gzgreg/enph253-2015-team13/SolidWorks parts/linkage_collapsed.png

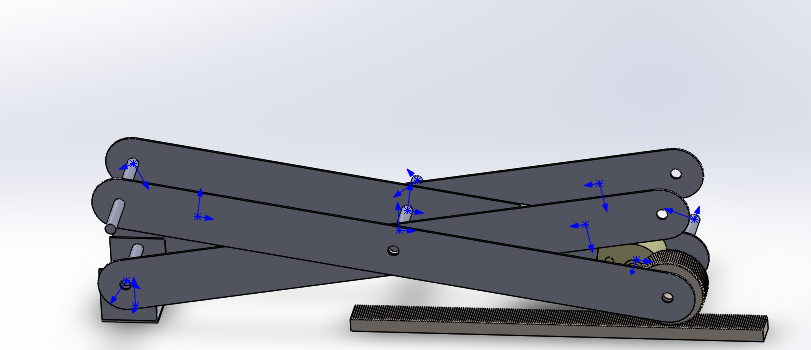
SolidWorks parts/linkage_collapsed.png
