gzgreg/enph253-2015-team13/SolidWorks parts/ARM Design/Design 2/Bottom Joint.png

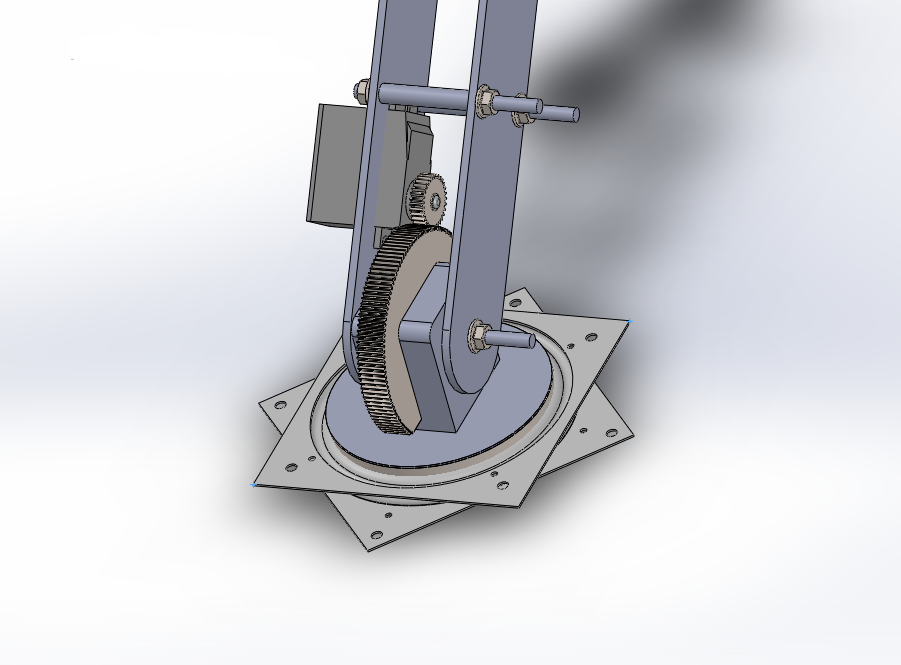
SolidWorks parts/ARM Design/Design 2/Bottom Joint.png
