gzgreg/enph253-2015-team13/README.md

# enph253-2015-team13
Github repo for our ENPH253 (and ENPH257) project.
