gzgreg/enph253-2015-team13/Lab/Lab Report Tracking Sheet.xlsx

TO DO | Used to Calculate | Data |  | Simulation
 |  | Heating | Steady State | Heating | Steady State | Legend
Black Rod | -Emissivity in different surface states |  |  |  |  |  | Complete
Bare Rod | -Thermal conductivity -Specific heat capacity |  |  |  |  |  | To Be Done
Moist Rod | -Heat loss from a wet surface |  |  |  |  |  | Not Nessisary
Insulated Rod | -Convective heat transfer coefficient in different conditions
Veritcal Bare Rod | -Convective heat transfer coefficient in different geometries
Vertical Bare Rod In Ice | -Convective heat transfer coefficient in different geometries/conditions
Power Source Heat | -Fraction of power generated by the thermal resistor
