gzgreg/enph253-2015-team13/Lab/Black Rod/html/transFinDiffPlotter_01.png

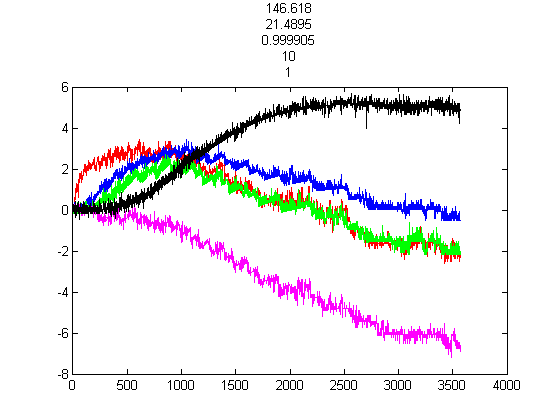
Lab/Black Rod/html/transFinDiffPlotter_01.png
