gzgreg/enph253-2015-team13/Lab/Diagrams for Report/BlackRod.png

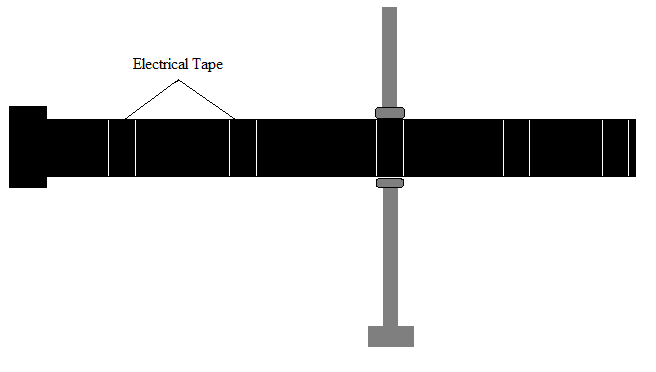
Lab/Diagrams for Report/BlackRod.png
