gzgreg/enph253-2015-team13/Lab/Diagrams for Report/MoistRod.png

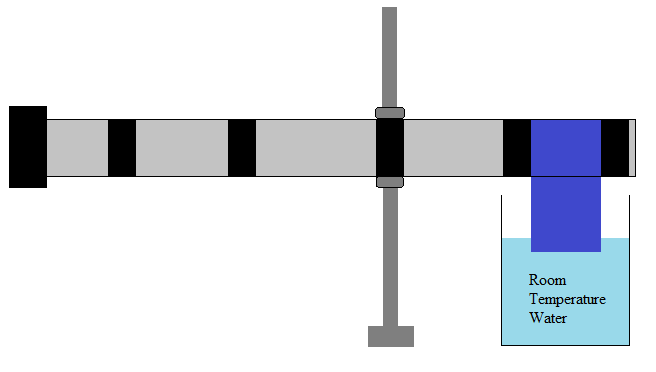
Lab/Diagrams for Report/MoistRod.png
