gzgreg/enph253-2015-team13/Lab/Diagrams for Report/VerticalBareRodIce.png

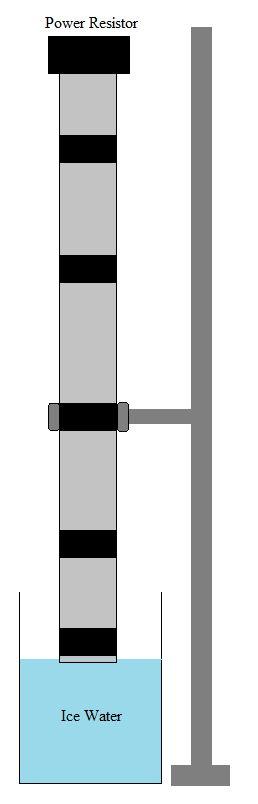
Lab/Diagrams for Report/VerticalBareRodIce.png
