gzgreg/enph253-2015-team13/Lab/James' Lab Simulations/Insulated Rod/html/insulate_rod_sim_01.png

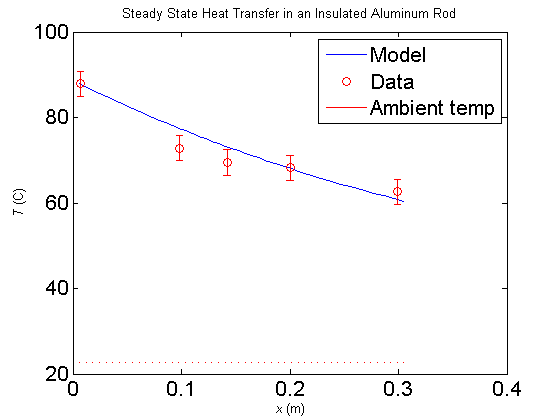
Lab/James' Lab Simulations/Insulated Rod/html/insulate_rod_sim_01.png
