gzgreg/enph253-2015-team13/Lab/Riley's Lab Stimulations V2/html/moistRodSimulation_01.png

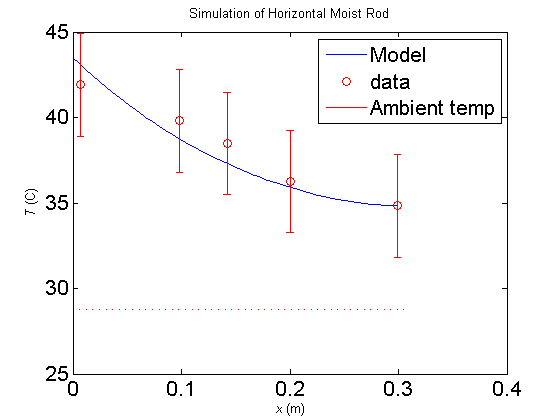
Lab/Riley's Lab Stimulations V2/html/moistRodSimulation_01.png
