gzgreg/enph253-2015-team13/Lab/Transient Insulated Rod Heating/html/transFinDiffPlotter_02.png

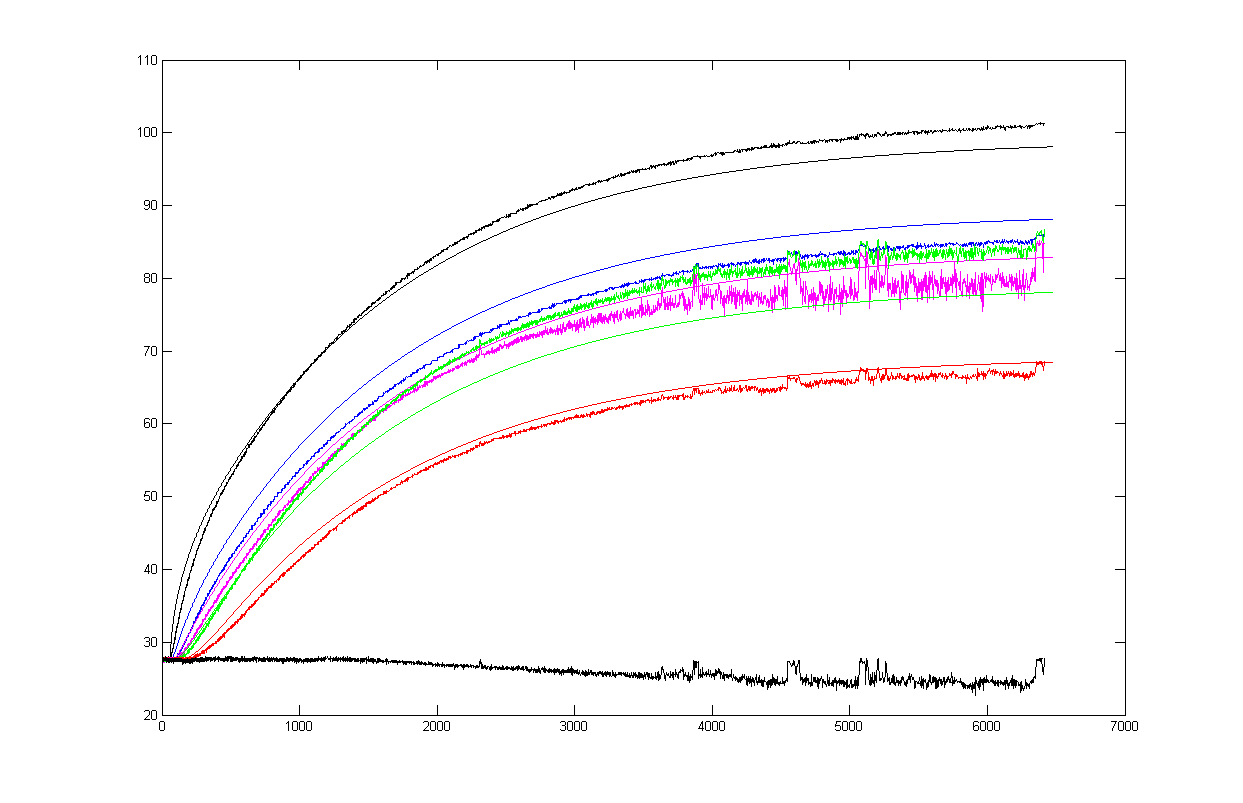
Lab/Transient Insulated Rod Heating/html/transFinDiffPlotter_02.png
