gzgreg/enph253-2015-team13/Lab/Vertical Bare Rod/htmlBottomPower/transFinDiffPlotter_02.png

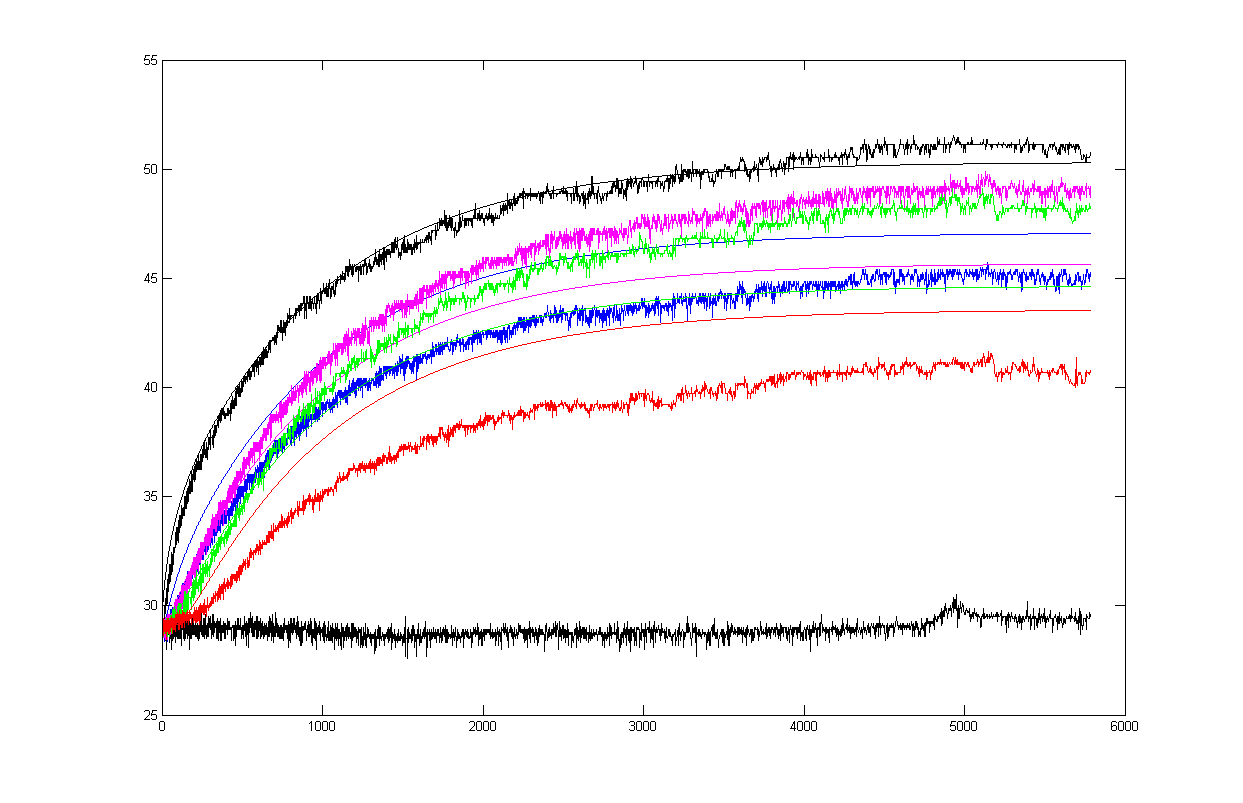
Lab/Vertical Bare Rod/htmlBottomPower/transFinDiffPlotter_02.png
