gzgreg/enph253-2015-team13/Lab/Vertical Bare Rod/htmlTopPower/transFinDiffPlotter_01.png

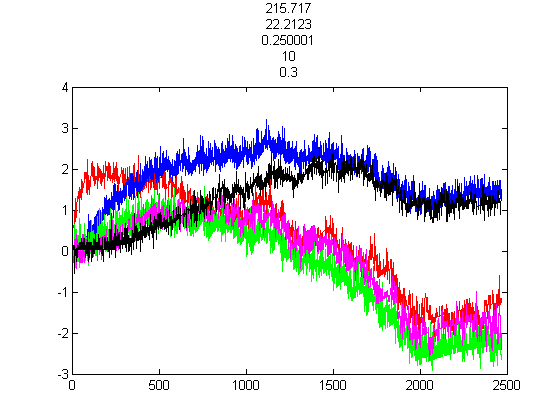
Lab/Vertical Bare Rod/htmlTopPower/transFinDiffPlotter_01.png
