gzgreg/enph253-2015-team13/Lab/Wilhelm's Lab Simuations/Black Rod/html/Black_Rod_Sim_01.png

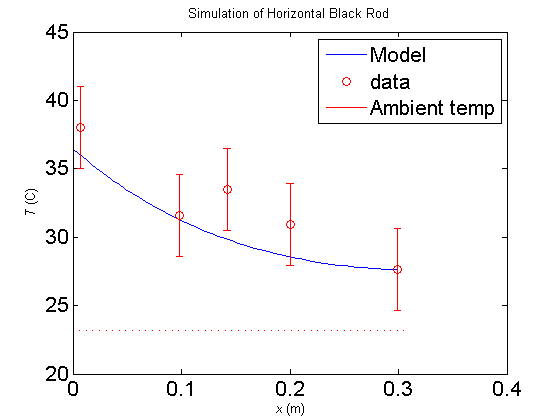
Lab/Wilhelm's Lab Simuations/Black Rod/html/Black_Rod_Sim_01.png
