gzgreg/enph253-2015-team13/Lab/Wilhelm's Lab Simuations/Vertical Bare Rod - Bottom Heating/html/Vert_Bare_Bottom_Heat_01.png

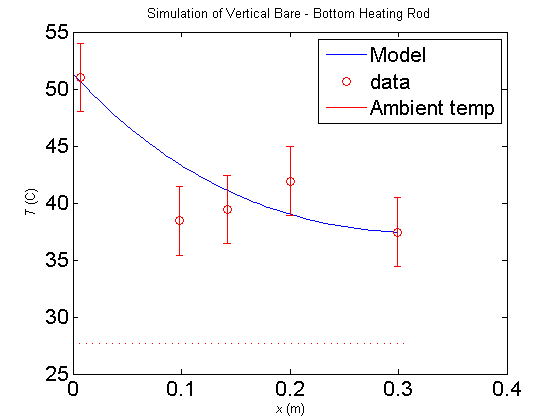
Lab/Wilhelm's Lab Simuations/Vertical Bare Rod - Bottom Heating/html/Vert_Bare_Bottom_Heat_01.png
