gzgreg/enph253-2015-team13/Lab/Wilhelm's Lab Simuations/Vertical Bare Rod - Top Heating/html/Vert_Bare_Top_Heat_01.png

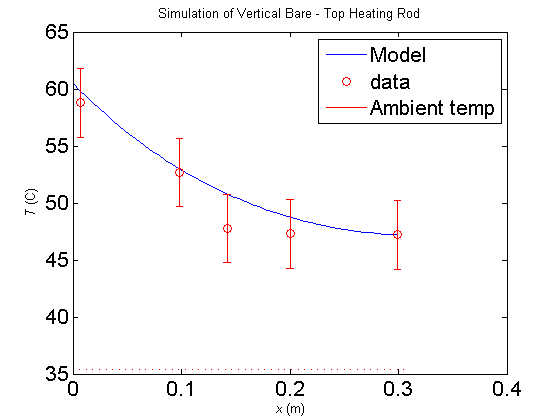
Lab/Wilhelm's Lab Simuations/Vertical Bare Rod - Top Heating/html/Vert_Bare_Top_Heat_01.png
