gzgreg/enph253-2015-team13/CrudeRobot.SLDASM

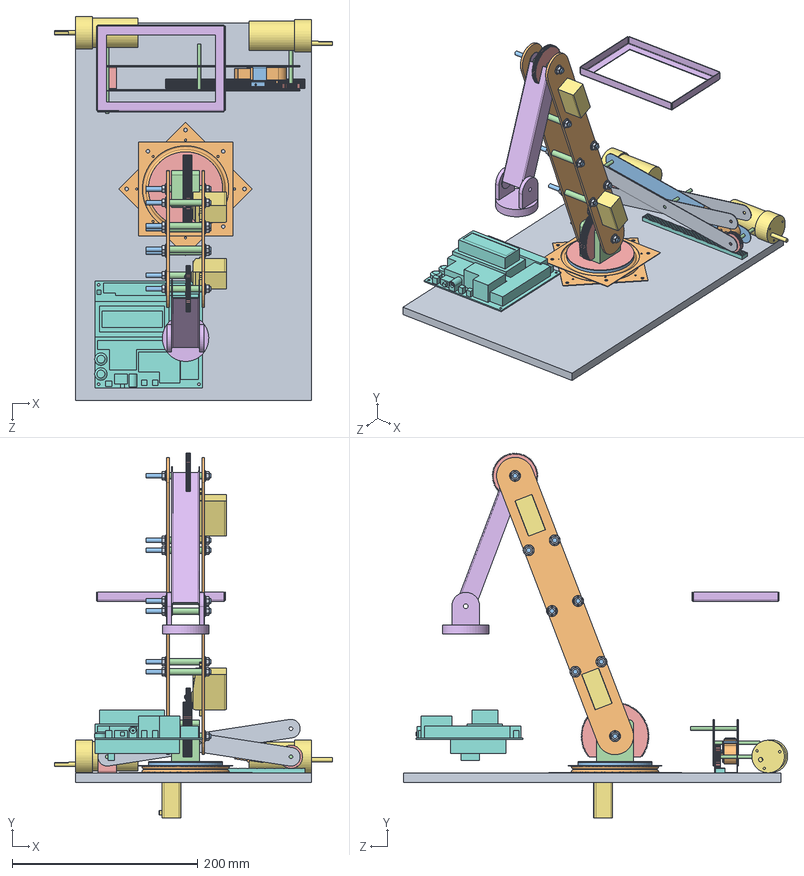
[picture p51: CAD file, 2015-06-24]
CrudeRobot.SLDASM
299.2 x 392.7 x 413.6 mm
ChassisV2.0
long_arm_side_beam x 2
~70x5mmCrosspin x 8
Sleeve x 8
spur gear_iso x 7
Arm_short_section_V2.0
Servo Futaba S3003 x 2
Servo Spindle x 2
hex flange nut gradea_iso x 16
6031K170 (Lazy Susan)
internal spur gear_iso
ArmBracket_V2.1
armRotationPlateV2.0
Pickup_Mechanism
Scotty's Stepper
rack spur rectangular_iso
Linkage long part x 3
GM7
linage with motor mount
4mmShaft x 4
linkage bracket
Basket holder
Motor BarbCole Geared (1) x 2
Tinah Board
