gzgreg/enph253-2015-team13/Playing surface/00 competition surface 2015.SLDASM

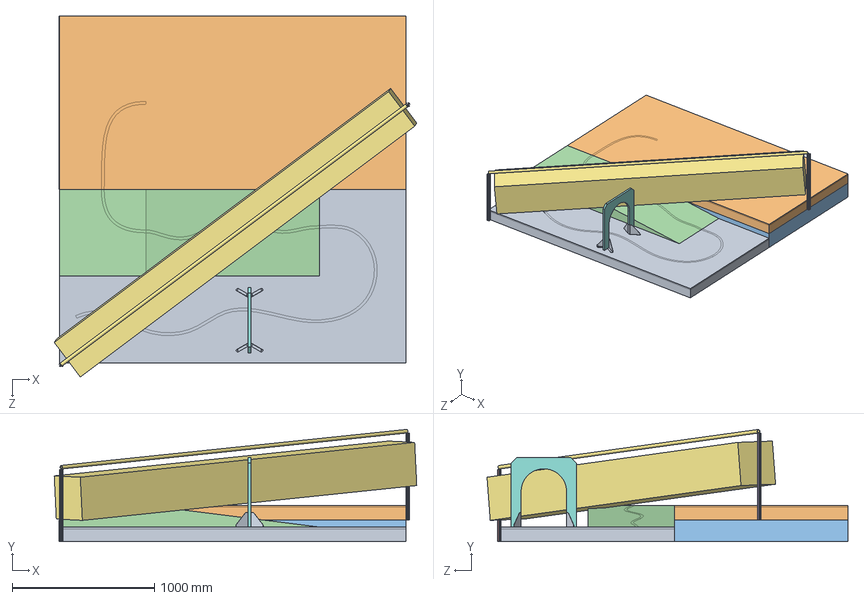
[picture p52: CAD file, 2015-06-10]
Playing surface/00 competition surface 2015.SLDASM
2549.8 x 788.8 x 2539.0 mm
surface unit one
surface unit two
riser framer
ramp
8020 20inches long
8020 24inches long
zip line tube
253 2015 play surface SPCA door
253 2015 play surface SPCA door bracket x 2
