gzgreg/enph253-2015-team13/Robot/SolidWorks Parts/Pet Basket.SLDASM

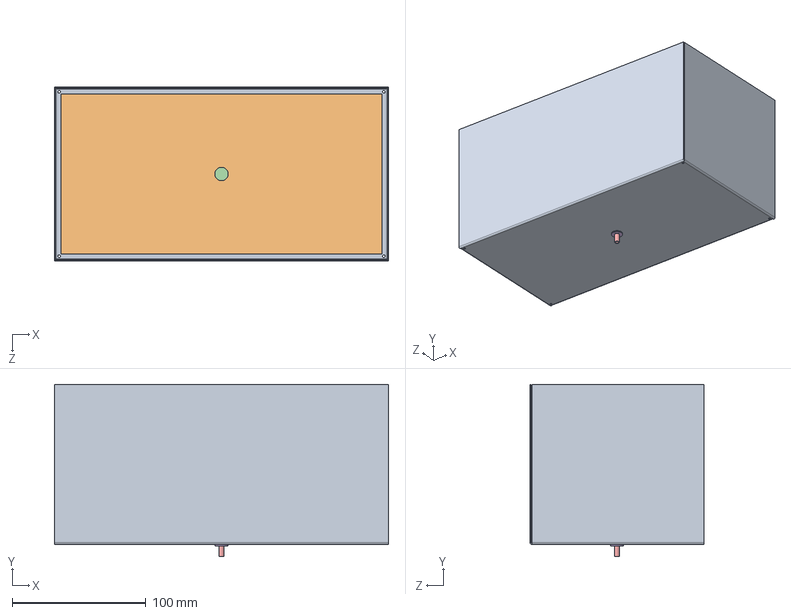
[picture p53: CAD file, 2015-06-18]
Robot/SolidWorks Parts/Pet Basket.SLDASM
250.0 x 128.9 x 130.0 mm
Pet Basket
Launch Bottom
8mmTube
8mmEndCap
4mmTube
Seal
