gzgreg/enph253-2015-team13/Robot/SolidWorks Parts/Zipline Mechanism/Zipline.SLDASM

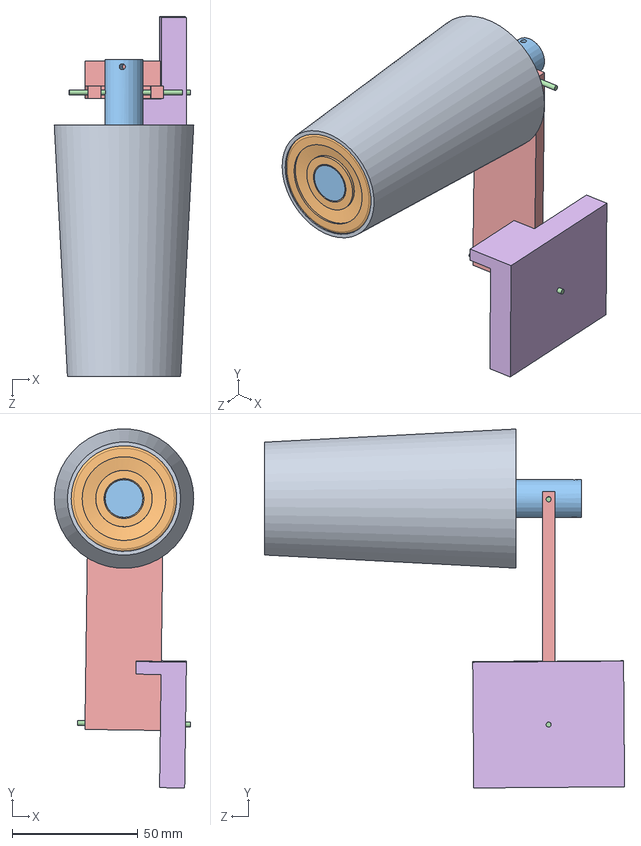
[picture p54: CAD file, 2015-07-04]
Robot/SolidWorks Parts/Zipline Mechanism/Zipline.SLDASM
55.5 x 142.7 x 143.2 mm
Bearing Holder
taper roller bearing_iso x 2
Bearing Rod
Pin x 2
Bearing Rod Holder
Basket Attachment
