gzgreg/enph253-2015-team13/SolidWorks parts/ARM Design/Design 2/Arm_V2.0.SLDASM

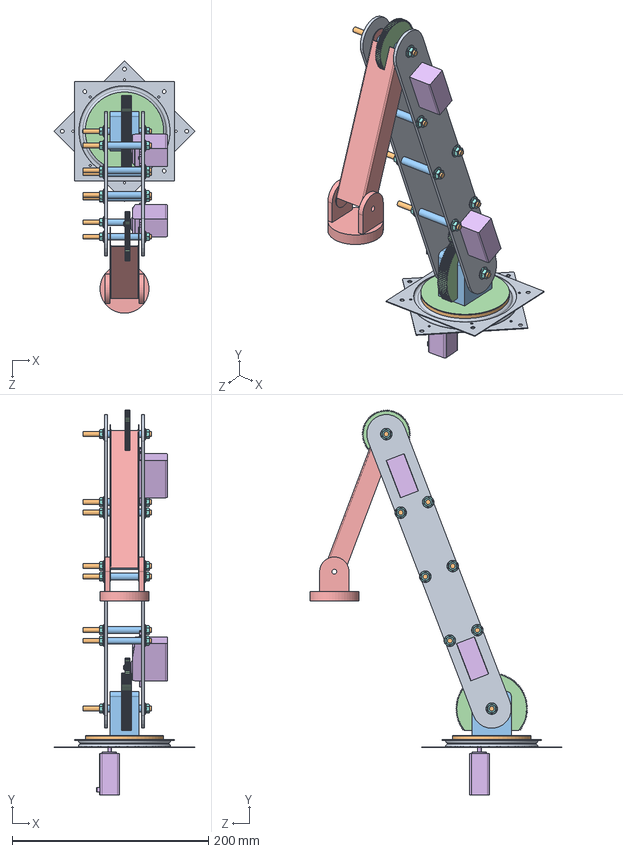
[picture p55: CAD file, 2015-06-19]
SolidWorks parts/ARM Design/Design 2/Arm_V2.0.SLDASM
143.7 x 392.7 x 257.4 mm
long_arm_side_beam x 2
~70x5mmCrosspin x 8
Sleeve x 8
spur gear_iso x 5
Arm_short_section_V2.0
Servo Futaba S3003 x 2
Servo Spindle x 2
hex flange nut gradea_iso x 16
6031K170 (Lazy Susan)
internal spur gear_iso
ArmBracket_V2.1
armRotationPlateV2.0
Pickup_Mechanism
Scotty's Stepper
