gzgreg/enph253-2015-team13/SolidWorks parts/Basket Lift Mechanism - Version 1/Assem1.SLDASM

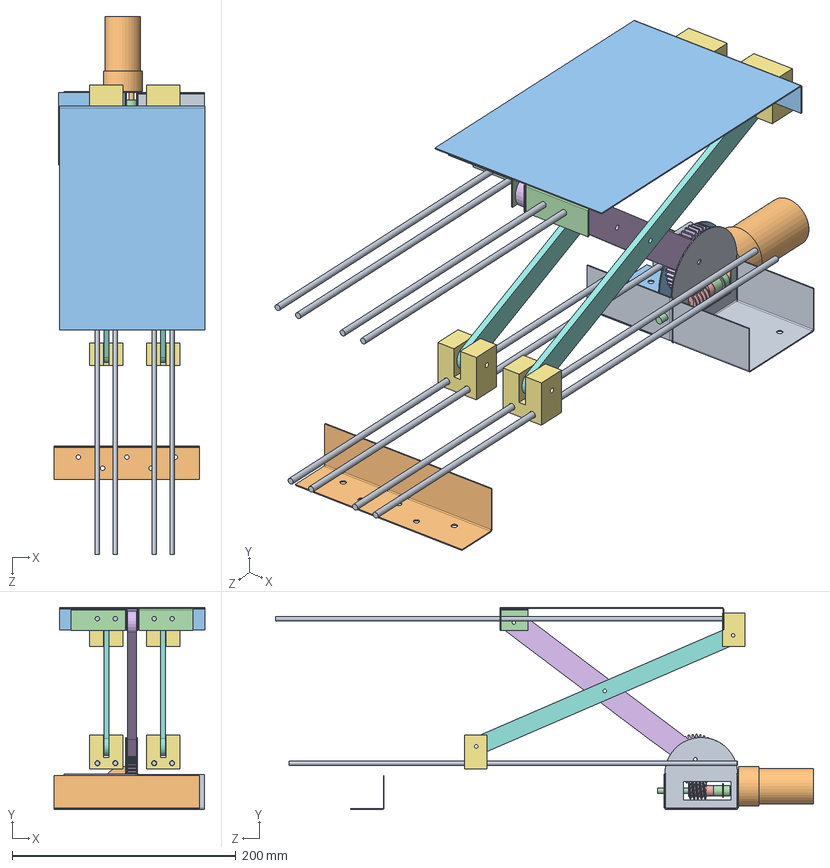
[picture p56: CAD file, 2015-07-16]
SolidWorks parts/Basket Lift Mechanism - Version 1/Assem1.SLDASM
134.6 x 180.5 x 481.1 mm
DrivenArmBasePinJoint-WithMotorMount
MotorBarbColeGeared
DrivenArmBasePinJoint-ForMakingAssembly
MachinedDrivenPin
WormGear
DrivenArmShaft
SlideArmPinSlider x 4
SlideArmShaft x 2
SlideArmSlidePole x 8
SlideArmPoleHolder
TopShelf-v1
DrivenArmTopPinJoint x 2
