gzgreg/enph253-2015-team13/SolidWorks parts/Catapult Basket/Catapult Basket - Assy Rev B.SLDASM

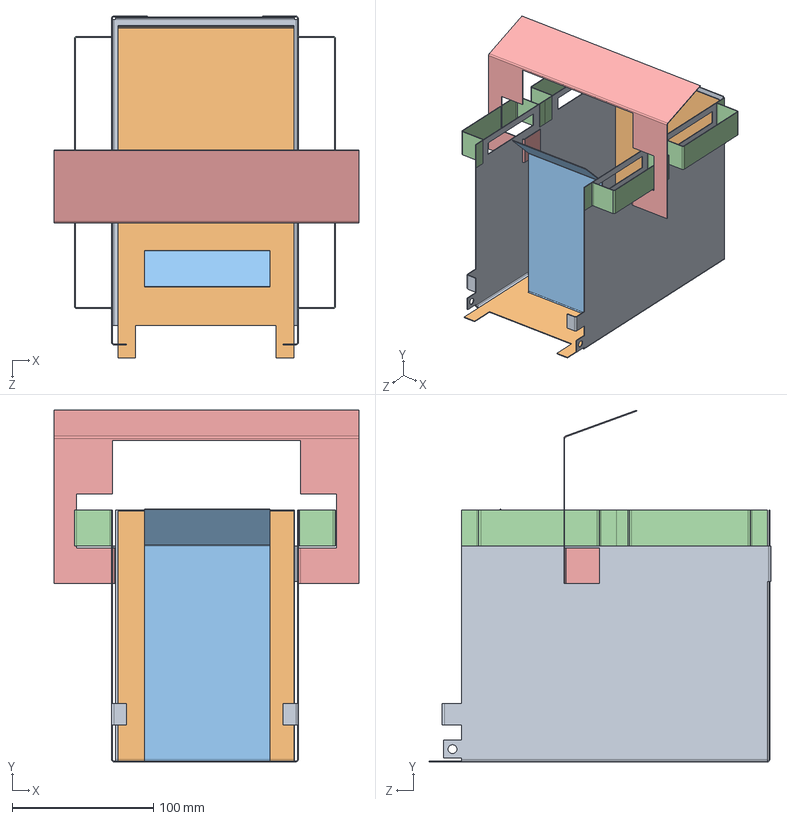
[picture p57: CAD file, 2015-07-23]
SolidWorks parts/Catapult Basket/Catapult Basket - Assy Rev B.SLDASM
215.9 x 249.3 x 242.4 mm
Outer Basket to Cut Rev 4
Inner Basket - Catapult to Cut Rev 2
Inner Basket - Sloped Angle to Cut Rev 2
Basket Attachment Rev 2 x 4
Zipline Guide Rev 1
