gzgreg/enph253-2015-team13/SolidWorks parts/Chassis and drive train/Chassis and Drive train.SLDASM

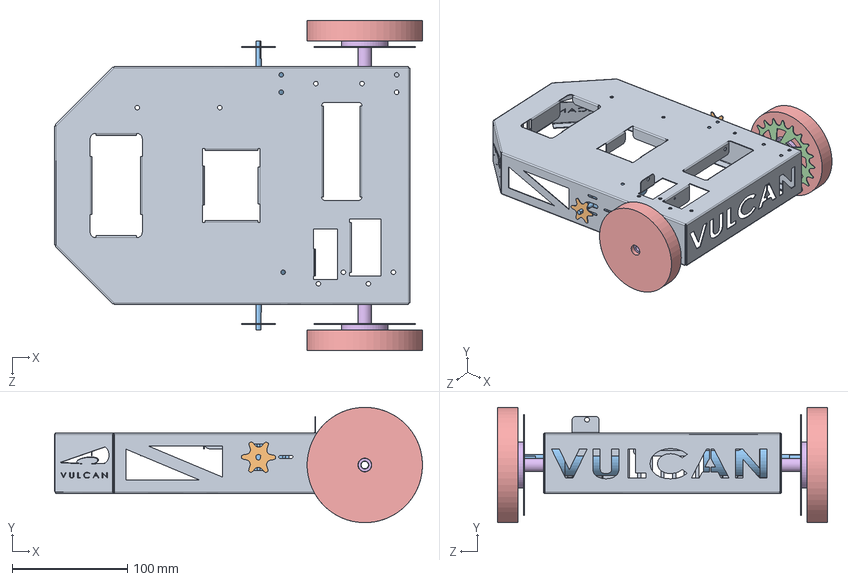
[picture p58: CAD file, 2015-08-13]
SolidWorks parts/Chassis and drive train/Chassis and Drive train.SLDASM
319.0 x 100.0 x 285.7 mm
chassis V4.0
6-tooth-sprocket x 2
Motor BarbCole Geared (1)MWasm x 2
20-tooth-sprocket_ x 2
wheelMWasm x 2
wheel hubMWasm x 2
