gzgreg/enph253-2015-team13/SolidWorks parts/PLAN B STUFF/HolesOnBasket.SLDASM

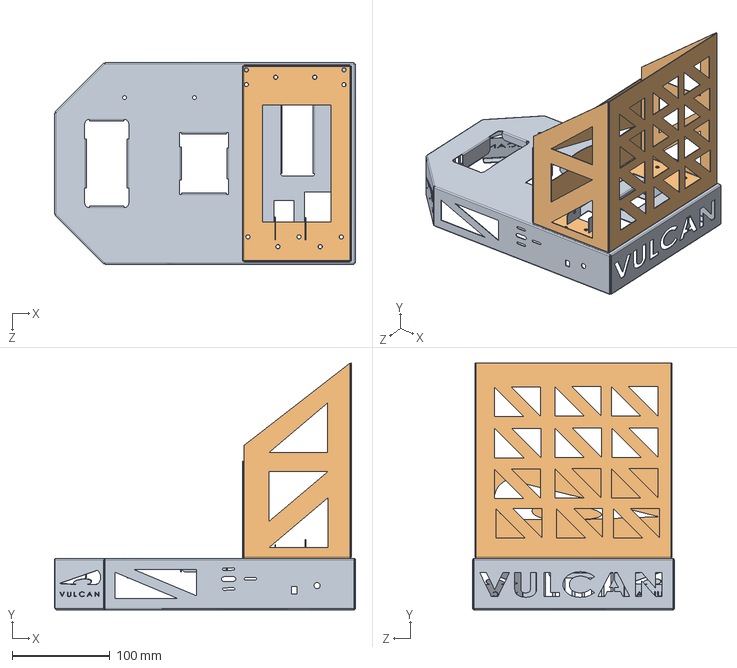
[picture p59: CAD file, 2015-08-13]
SolidWorks parts/PLAN B STUFF/HolesOnBasket.SLDASM
308.3 x 252.5 x 206.7 mm
chassis V4.1
Basket-Triangles
