gzgreg/enph253-2015-team13/SolidWorks parts/wheels/Assem1.SLDASM

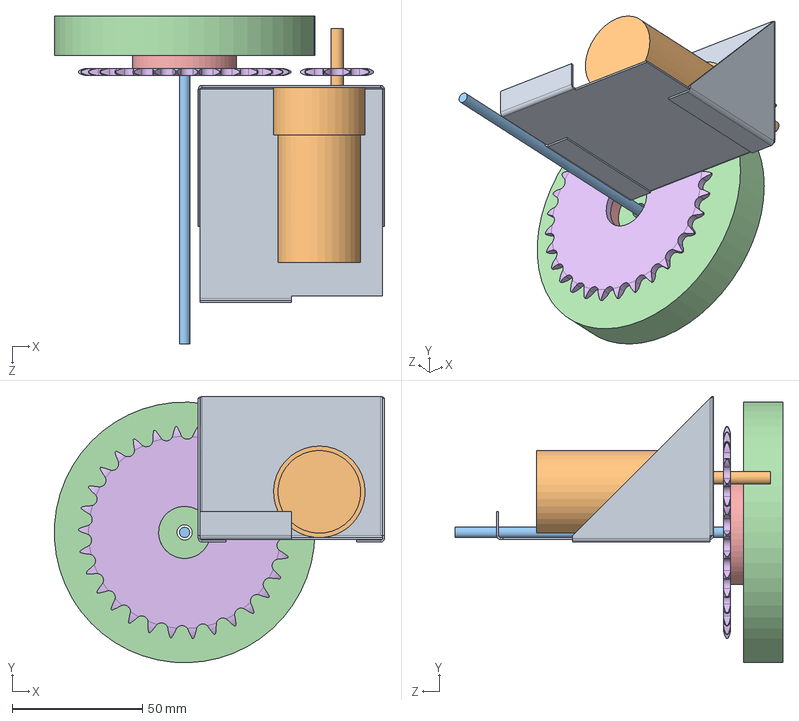
[picture p60: CAD file, 2015-06-25]
SolidWorks parts/wheels/Assem1.SLDASM
126.6 x 102.2 x 125.7 mm
mounting bracket
Motor BarbCole Geared (1)
axel
wheel
wheel hub
short pitch roller chain wheel_s_iso x 2
