gzgreg/enph253-2015-team13/SolidWorks parts/Zip Line Mechanism/SizeTestAssembly.SLDASM

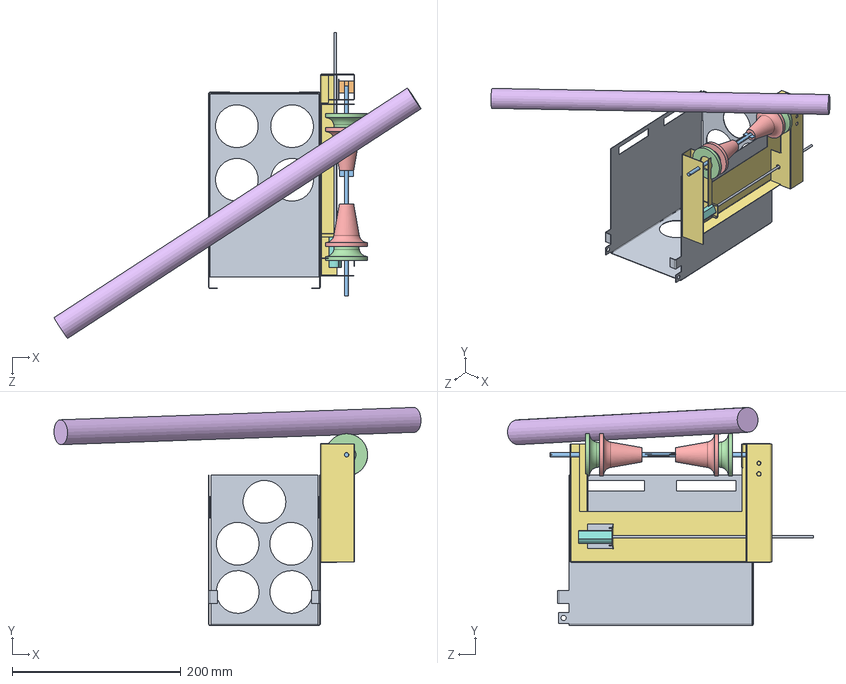
[picture p61: CAD file, 2015-08-01]
SolidWorks parts/Zip Line Mechanism/SizeTestAssembly.SLDASM
435.1 x 258.6 x 362.8 mm
Outer Basket to Cut Rev 4
PinSupport v3
RollerShaft x 2
PoweredRoller x 2
Zipline Roller Rev 5 x 2
ZiplinePole
RollerFlange-FullCorrectSide
DrivingMotorTemplate
DrivenShaft
