gzgreg/enph253-2015-team13/SolidWorks parts/ARM Design/Design 1/Arm_V1.0.SLDASM

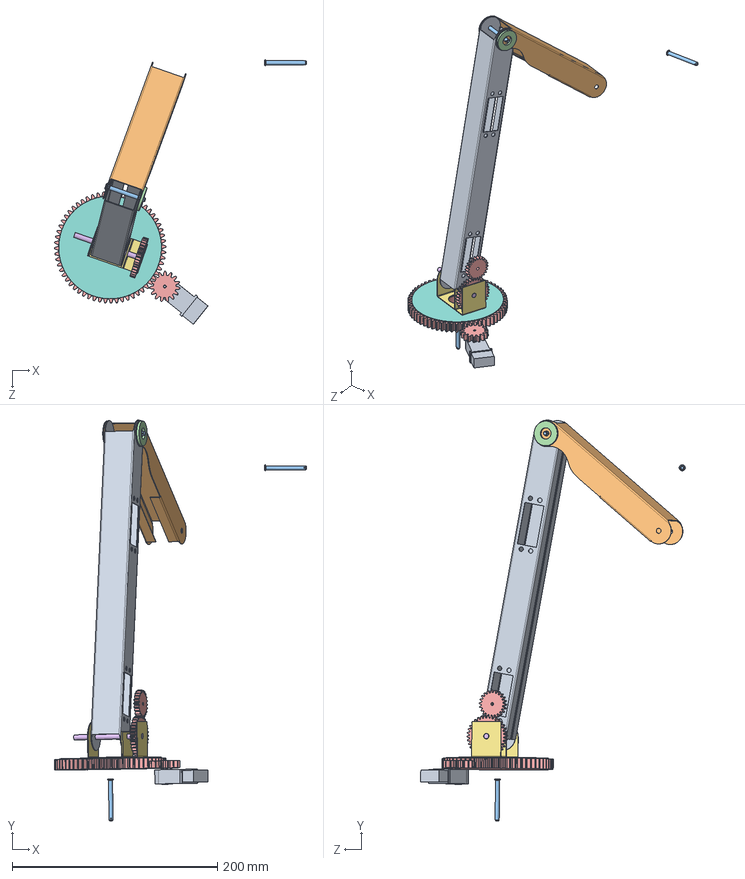
[picture p62: CAD file, 2015-06-17]
SolidWorks parts/ARM Design/Design 1/Arm_V1.0.SLDASM
245.5 x 390.4 x 257.6 mm
armSeg1_V1.0
armSeg2_V1.0
clevis pin headed_iso x 3
plain washer 10673 type snl_iso
spur gear_iso x 4
~70x5mmCrosspin
Armbracket
armRotationPlate
GM7
