gzgreg/enph253-2015-team13/SolidWorks parts/Basket Lift/Driven Linkage.SLDASM

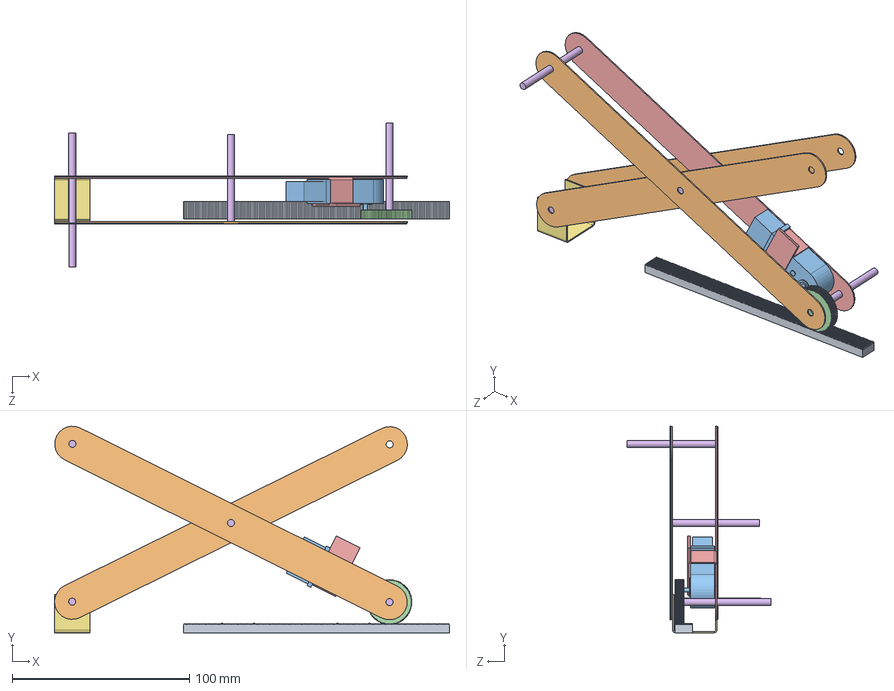
[picture p63: CAD file, 2015-06-24]
SolidWorks parts/Basket Lift/Driven Linkage.SLDASM
222.9 x 116.6 x 81.3 mm
rack spur rectangular_iso
Linkage long part x 3
GM7
spur gear_iso x 2
linage with motor mount
4mmShaft x 4
linkage bracket
