gzgreg/enph253-2015-team13/SolidWorks parts/Catapult Basket/Catapult Basket - Assy Rev B with Zipline Catcher.SLDASM

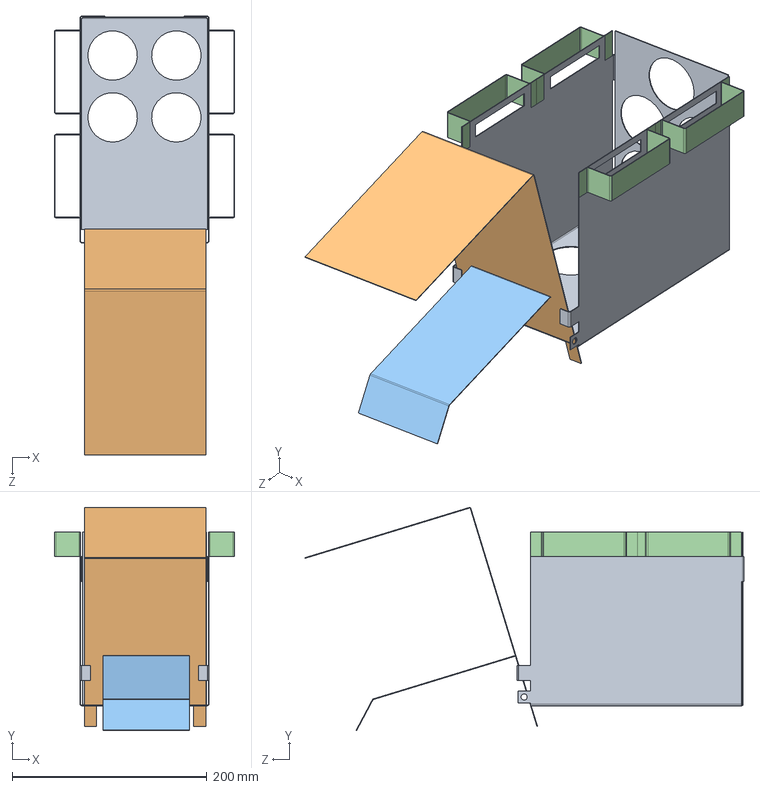
[picture p64: CAD file, 2015-07-23]
SolidWorks parts/Catapult Basket/Catapult Basket - Assy Rev B with Zipline Catcher.SLDASM
185.2 x 229.1 x 450.9 mm
Outer Basket to Cut Rev 4
Inner Basket - Catapult to Cut Rev 2
Inner Basket - Sloped Angle to Cut Rev 2
Basket Attachment Rev 2 x 4
