gzgreg/enph253-2015-team13/SolidWorks parts/Motor-wheel_module/Motor-wheel_assem.SLDASM

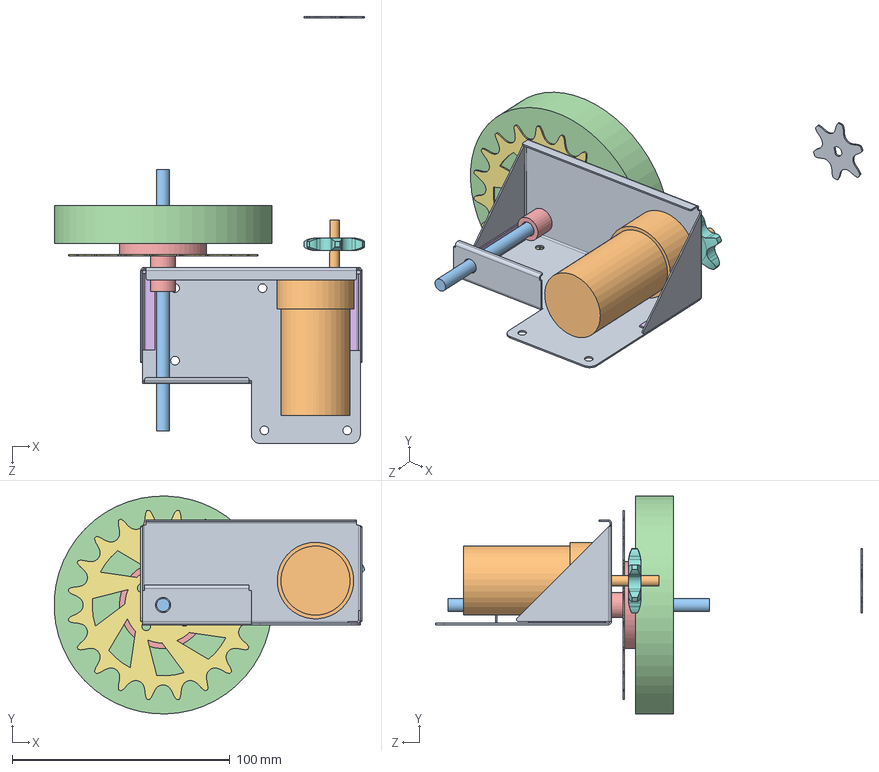
[picture p65: CAD file, 2015-07-15]
SolidWorks parts/Motor-wheel_module/Motor-wheel_assem.SLDASM
142.4 x 100.0 x 195.9 mm
mounting bracketMWasm
Motor BarbCole Geared (1)MWasm
axelMWasm
wheelMWasm
wheel hubMWasm
edge_stiffener x 2
20-tooth-sprocket
precision roller chain sprocket_ai
6-tooth-sprocket
