gzgreg/enph253-2015-team13/SolidWorks parts/pickup mechanism.SLDASM

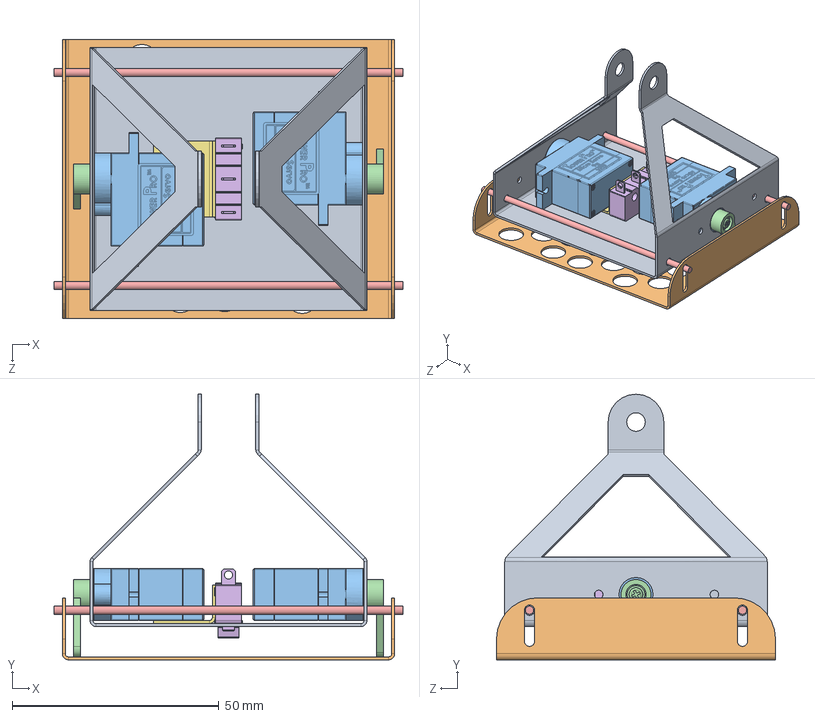
[picture p66: CAD file, 2015-08-04]
SolidWorks parts/pickup mechanism.SLDASM
84.4 x 64.2 x 67.5 mm
pickup mechanism
Al_pickup_mech
SG90 BODY x 2
SG90 ARM x 2
Part2^pickup mechanism x 2
Micro Switch Button
Part3^pickup mechanism
