gzgreg/enph253-2015-team13/SolidWorks parts/Servo futaba/Servo Assembly Futaba S3003.SLDASM

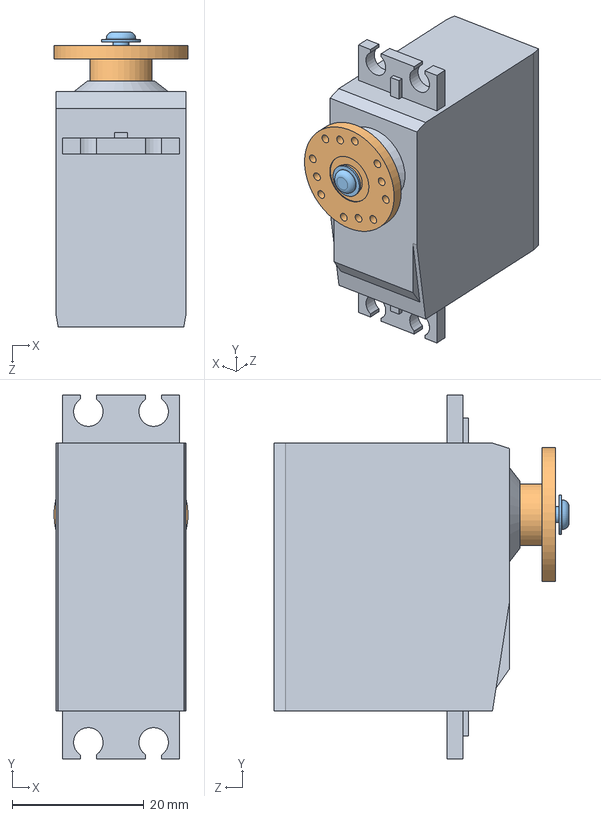
[picture p67: CAD file, 2015-07-08]
SolidWorks parts/Servo futaba/Servo Assembly Futaba S3003.SLDASM
20.3 x 55.3 x 44.8 mm
Servo Futaba S3003
Servo Rotor
Servo Spindle
