gzgreg/enph253-2015-team13/SolidWorks parts/Bumper/FinalBumperMech.SLDASM

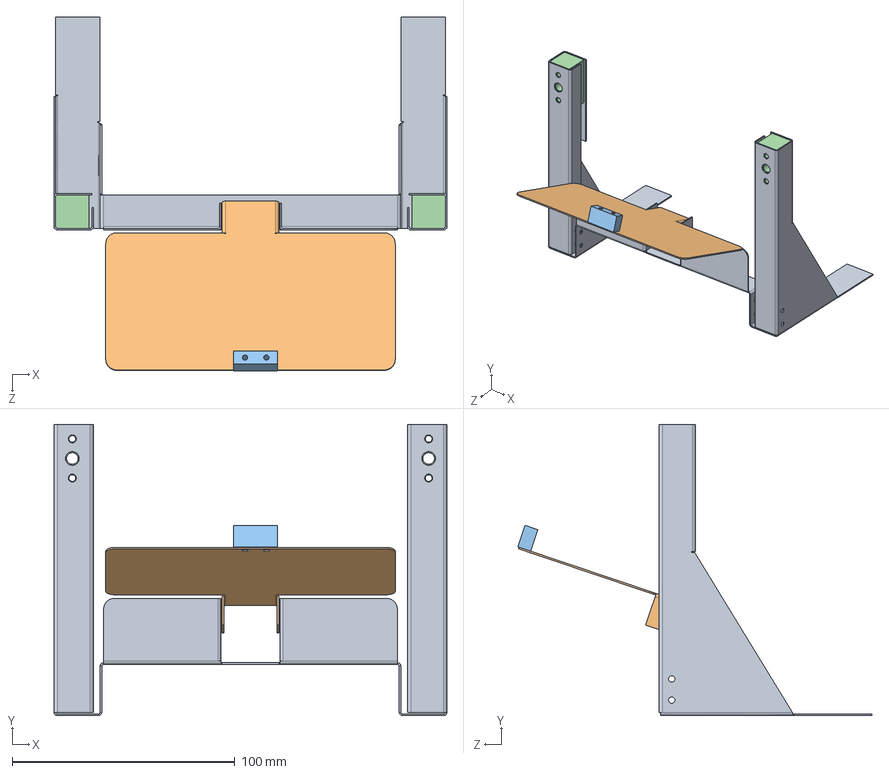
[picture p68: CAD file, 2015-08-13]
SolidWorks parts/Bumper/FinalBumperMech.SLDASM
176.5 x 130.7 x 159.2 mm
MicroSwitchMount-withIRMount
PickupFlange
CrudeMicroSwitch
IRHousing-for Assembly x 2
