gzgreg/enph253-2015-team13/SolidWorks parts/james' zipline/Assem2.SLDASM

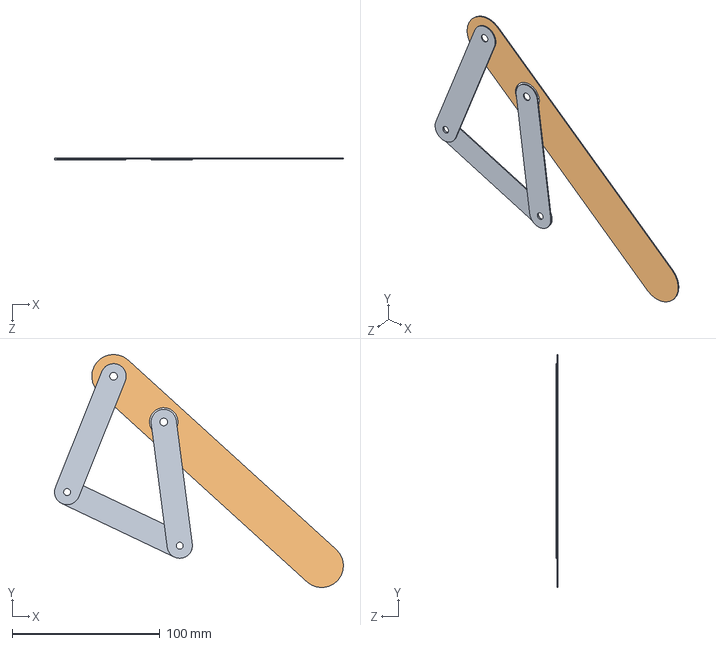
[picture p69: CAD file, 2015-07-04]
SolidWorks parts/james' zipline/Assem2.SLDASM
195.7 x 157.9 x 1.47 mm
