gzgreg/enph253-2015-team13/SolidWorks parts/Motor-wheel_module/wheelMWasm.SLDPRT

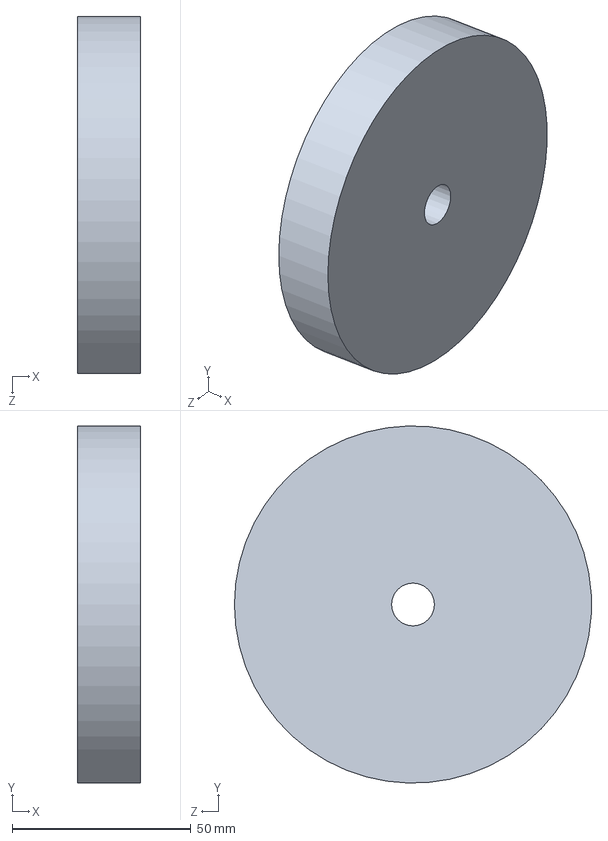
[picture p70: CAD file, 2015-07-14]
SolidWorks parts/Motor-wheel_module/wheelMWasm.SLDPRT
17.5 x 100.0 x 100.0 mm
