gzgreg/enph253-2015-team13/SolidWorks parts/PLAN B STUFF/Assem2.SLDASM

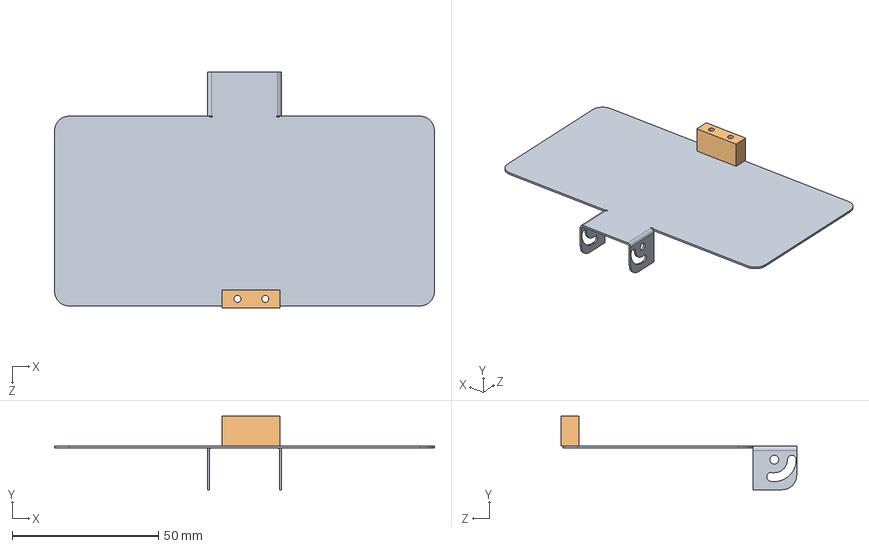
[picture p71: CAD file, 2015-08-13]
SolidWorks parts/PLAN B STUFF/Assem2.SLDASM
130.0 x 25.2 x 80.6 mm
PickupFlange
CrudeMicroSwitch
