gzgreg/enph253-2015-team13/SolidWorks parts/Zip Line Mechanism/RollerFlange-FullCorrectSide.SLDPRT

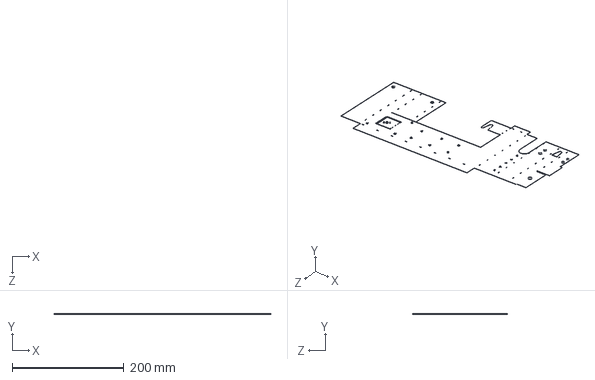
[picture p72: CAD file, 2015-08-01]
SolidWorks parts/Zip Line Mechanism/RollerFlange-FullCorrectSide.SLDPRT
389.1 x 0.737 x 169.1 mm
