gzgreg/enph253-2015-team13/SolidWorks parts/ARM Design/Arm_v3.SLDASM

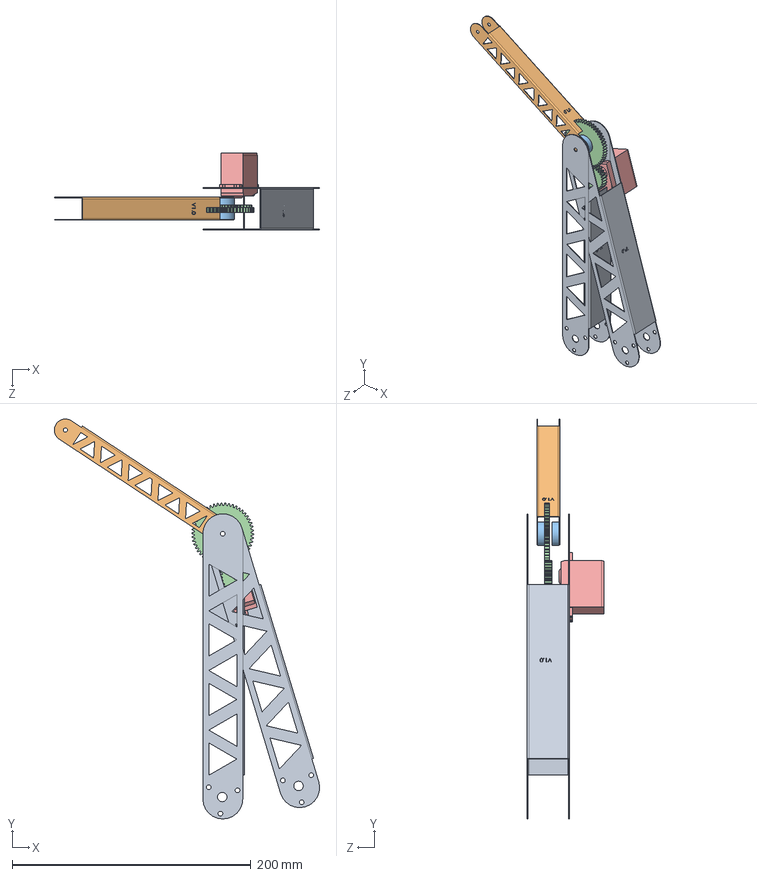
[picture p73: CAD file, 2015-08-01]
SolidWorks parts/ARM Design/Arm_v3.SLDASM
222.5 x 335.4 x 64.2 mm
amr_seg2_v3
gear spacer x 2
arm_segment_v3
spur gear_iso x 2
Servo Motor
