gzgreg/enph253-2015-team13/SolidWorks parts/Basket Lift/Accordian_Linkage.SLDASM

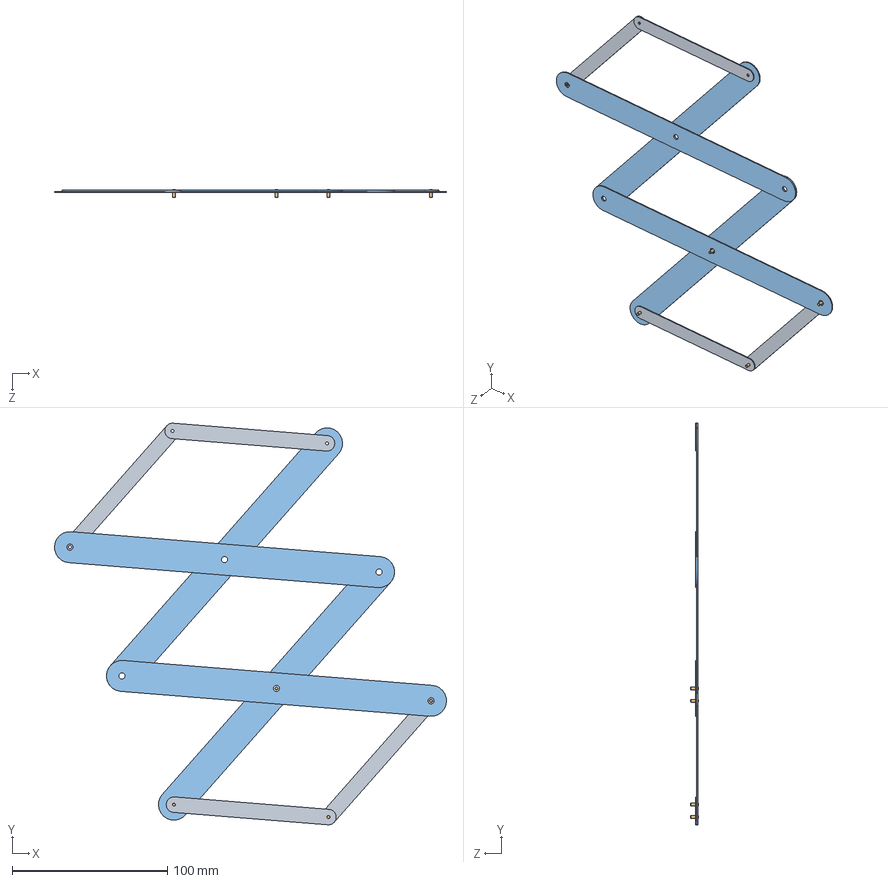
[picture p74: CAD file, 2015-06-15]
SolidWorks parts/Basket Lift/Accordian_Linkage.SLDASM
252.8 x 259.1 x 5.00 mm
Linkage part x 4
parallel pin hardened_iso x 4
Linkage long part x 4
