gzgreg/enph253-2015-team13/SolidWorks parts/Motor-wheel_module/wheel hubMWasm.SLDPRT

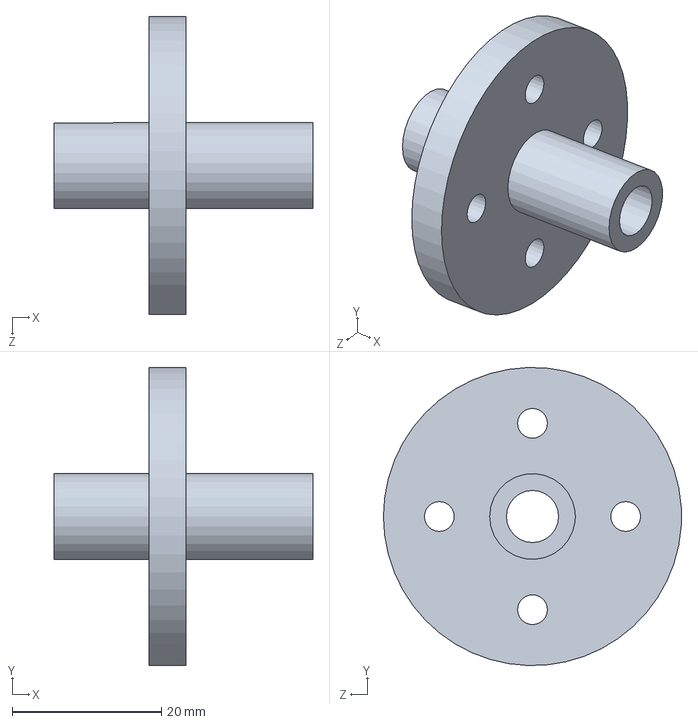
[picture p75: CAD file, 2015-07-13]
SolidWorks parts/Motor-wheel_module/wheel hubMWasm.SLDPRT
34.7 x 40.0 x 40.0 mm
