gzgreg/enph253-2015-team13/SolidWorks parts/SG90.SLDASM

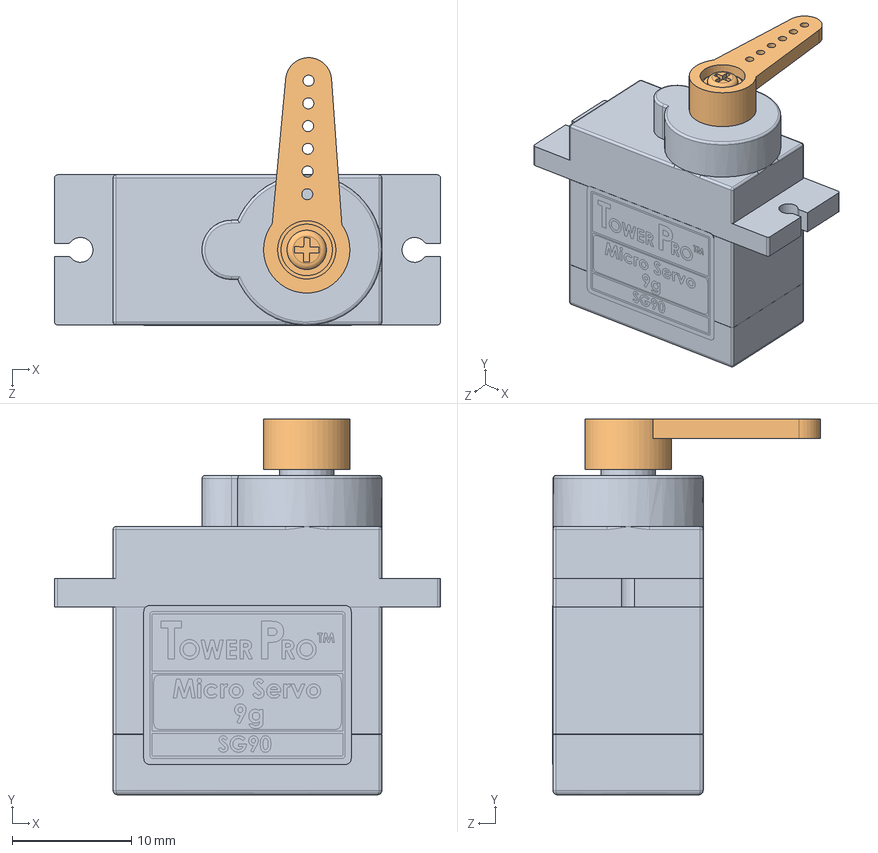
[picture p76: CAD file, 2015-08-02]
SolidWorks parts/SG90.SLDASM
32.4 x 31.5 x 22.4 mm
SG90 BODY
SG90 ARM
