gzgreg/enph253-2015-team13/SolidWorks parts/ARM Design/Arm_mount.SLDASM

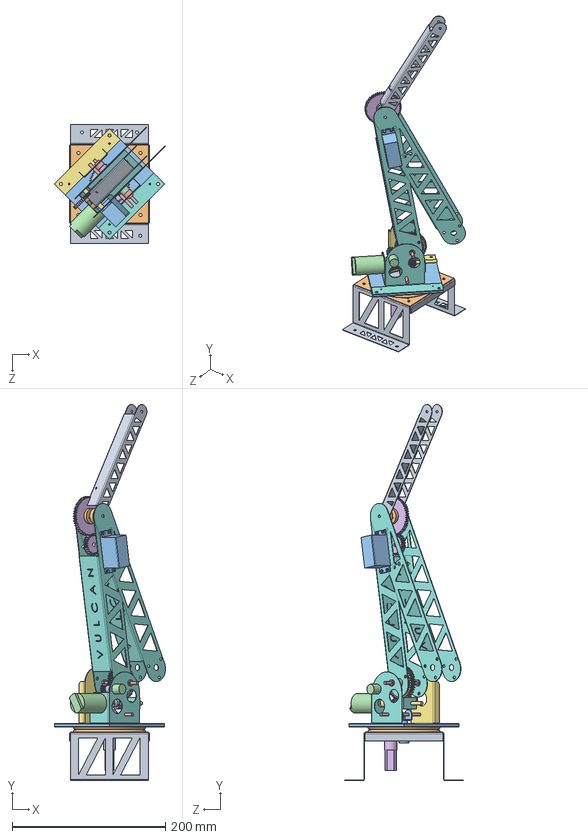
[picture p77: CAD file, 2015-08-01]
SolidWorks parts/ARM Design/Arm_mount.SLDASM
145.0 x 490.9 x 155.1 mm
arm_mount
6031K170 (Lazy Susan)
Internal_spur
Potentiometer x 2
arm_rotation_spur_gear
Arm_rotation_motor
Arm base Flange with motor mount
worm for helical gear
helical gear 40 teeth
Mecano Thingy
DC motor
4mm_shaft x 2
spur gear_iso x 3
metal_shaft_coupler
amr_seg2_v3
gear spacer x 2
arm_segment_v3
Servo Motor
bushing-spacer
bushing-spacer2 x 2
bushing-spacer3
top_arm_spacer x 2
