gzgreg/enph253-2015-team13/SolidWorks parts/Zip Line Mechanism/Assem2.SLDASM

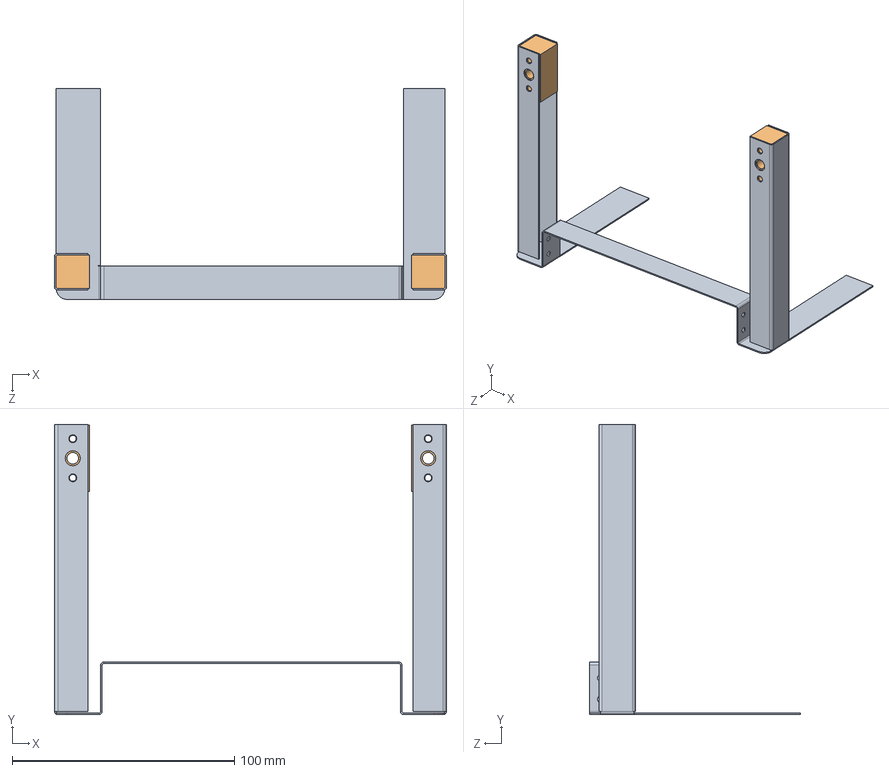
[picture p78: CAD file, 2015-08-01]
SolidWorks parts/Zip Line Mechanism/Assem2.SLDASM
176.5 x 130.7 x 95.0 mm
MicroSwitchMount-withIRMount
IRHousing-for Assembly x 2
