gzgreg/enph253-2015-team13/SolidWorks parts/ARM Design/Design 5/Arm_mount_V5.0.SLDASM

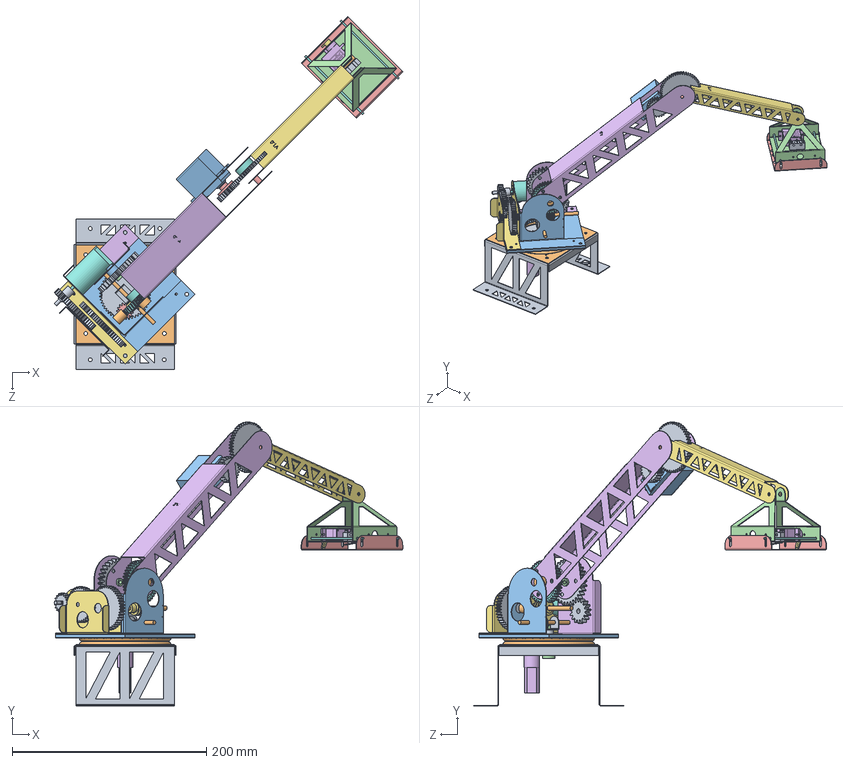
[picture p79: CAD file, 2015-08-13]
SolidWorks parts/ARM Design/Design 5/Arm_mount_V5.0.SLDASM
358.8 x 292.3 x 363.4 mm
arm_mountV4.0V5.0FINAL
6031K170 (Lazy Susan)V4.0V5.0FINAL
Internal_spurV4.0V5.0FINAL
PotentiometerV4.0V5.0FINAL
arm_rotation_spur_gearV4.0V5.0FINAL
Arm_rotation_motorV4.0V5.0FINAL
worm for helical gearV4.0V5.0FINAL
helical gear 40 teethV4.0V5.0FINAL
Mecano ThingyV4.0V5.0FINAL
4mm_shaftV4.0V5.0FINAL
Servo Futaba S3003V4.0V5.0FINAL
Servo SpindleV4.0V5.0FINAL
Servo RotorV4.0V5.0FINAL
amr_seg2_v3V4.0V5.0FINAL
gear spacerV4.0V5.0FINAL
spur gear_iso x 8
bushing-spacerV4.0V5.0FINAL
bushing-spacer2V4.0V5.0FINAL
bushing-spacer3V4.0V5.0FINAL
top_arm_spacerV4.0V5.0FINAL
Part3V4.0V5.0
new motor flangeV5.0
DC motor
motor gear collar
metal_shaft_couplerV4.0V5.0
Arm base Flange with motor mountV4.0V5.0
pickup mechanismFINAL
Al_pickup_mechFINAL
SG90 BODYFINAL
SG90 ARMFINAL
Part2^pickup mechanism x 2
Micro Switch ButtonFINAL
Part3^pickup mechanism
