gzgreg/enph253-2015-team13/SolidWorks parts/Basket Lift Mechanism - Version 1/SlideArmYolo.SLDASM

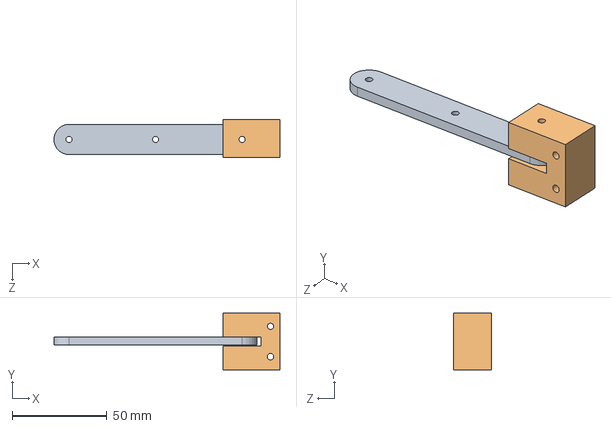
[picture p80: CAD file, 2015-07-16]
SolidWorks parts/Basket Lift Mechanism - Version 1/SlideArmYolo.SLDASM
119.1 x 30.0 x 20.0 mm
SlideArmShaft
SlideArmPinSlider
