gzgreg/enph253-2015-team13/SolidWorks parts/Bumper/BumperMech.SLDASM

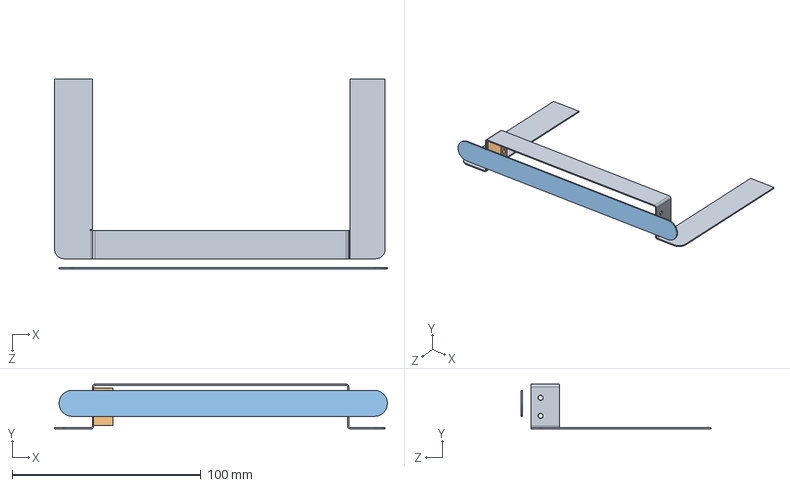
[picture p81: CAD file, 2015-08-01]
SolidWorks parts/Bumper/BumperMech.SLDASM
176.2 x 23.7 x 100.3 mm
MicroSwitchMount
CrudeMicroSwitch
Bumper
