gzgreg/enph253-2015-team13/SolidWorks parts/Catapult Basket/Catapult Basket - Assy Rev 2.SLDASM

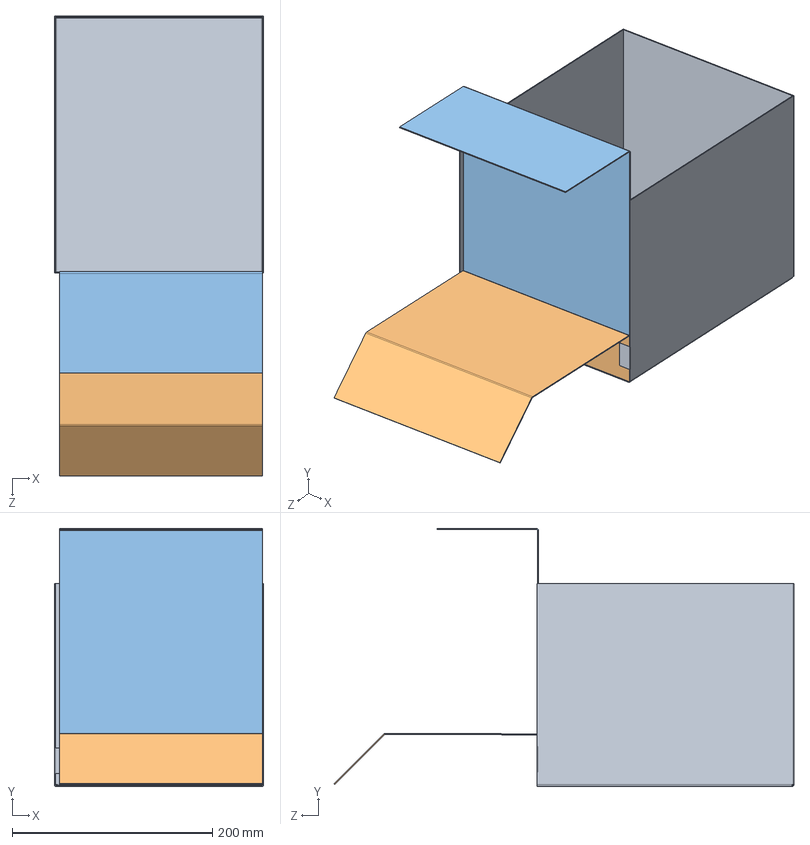
[picture p82: CAD file, 2015-07-13]
SolidWorks parts/Catapult Basket/Catapult Basket - Assy Rev 2.SLDASM
209.2 x 258.3 x 459.9 mm
Catapult Basket Rev 1
Catapult Basket - Catapult Slope Side Rev 1
Catapult Basket - Catapult Rev 2
