gzgreg/enph253-2015-team13/SolidWorks parts/Motor-wheel_module/mounting bracketMWasm.SLDPRT

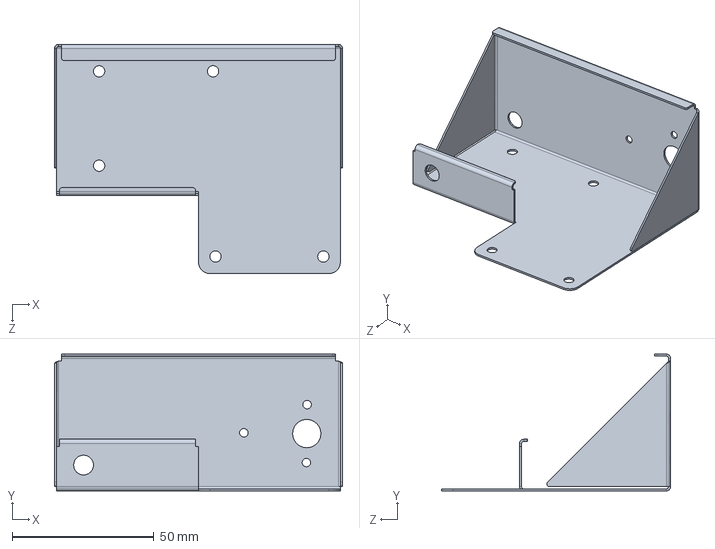
[picture p83: CAD file, 2015-07-04]
SolidWorks parts/Motor-wheel_module/mounting bracketMWasm.SLDPRT
101.5 x 48.2 x 80.7 mm
