gzgreg/enph253-2015-team13/SolidWorks parts/Basket Lift Mechanism - R-Dawg Version 2.0/BasketLiftMechanism-V2.SLDASM

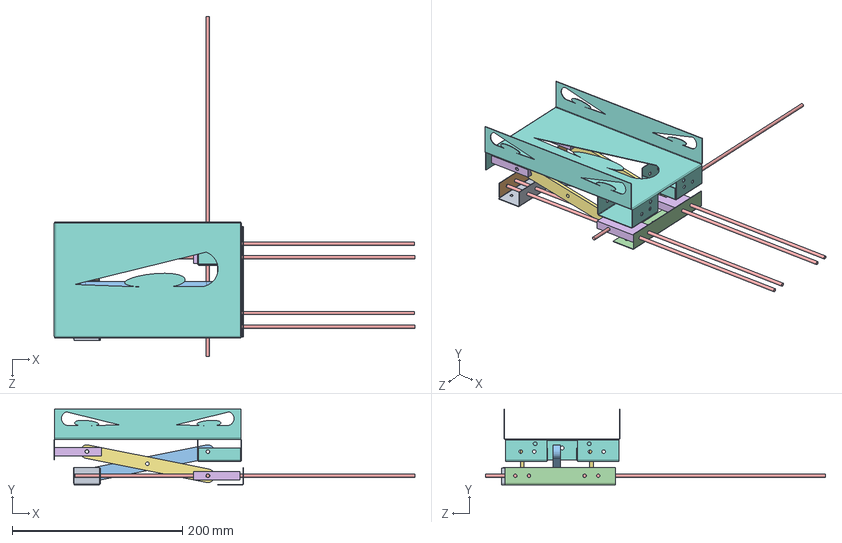
[picture p84: CAD file, 2015-07-22]
SolidWorks parts/Basket Lift Mechanism - R-Dawg Version 2.0/BasketLiftMechanism-V2.SLDASM
424.5 x 89.1 x 400.0 mm
FixedArmPinJoint
FixedArmPinJoint-WithSlidePoleMounts
FixedArmShaft
SlidePoleMount
SlideArmSlidePole x 5
SlideArmPinSlider x 4
SlideArmShaft x 2
BasketHolder
