gzgreg/enph253-2015-team13/SolidWorks parts/Basket Lift Mechanism - Version 1/aRMM.SLDASM

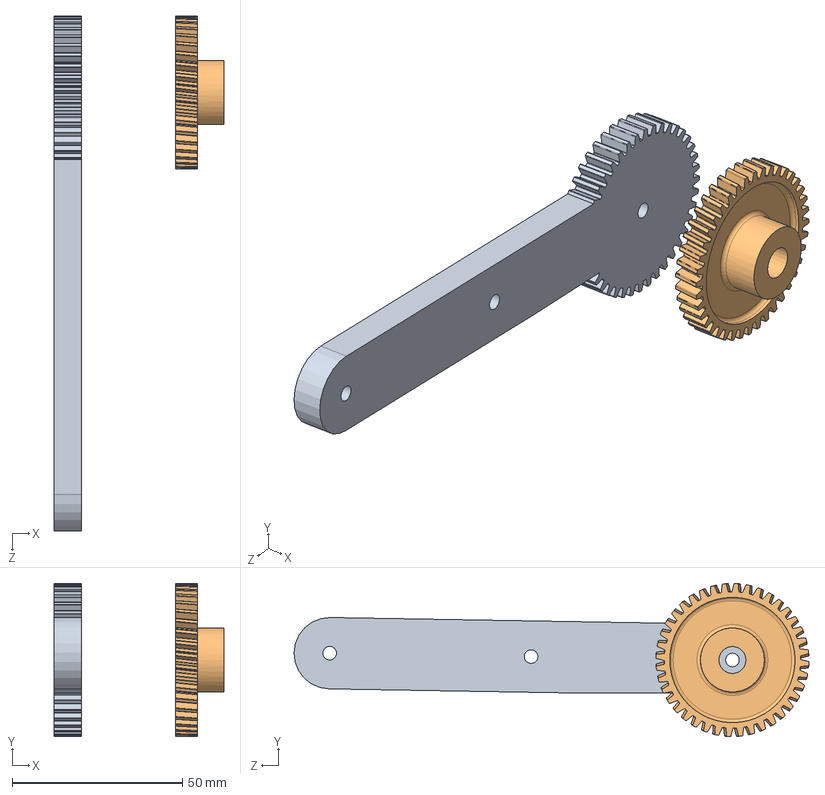
[picture p85: CAD file, 2015-07-16]
SolidWorks parts/Basket Lift Mechanism - Version 1/aRMM.SLDASM
49.9 x 45.0 x 151.3 mm
DrivenArmShaft
HelicalGear40Teeth
