gzgreg/enph253-2015-team13/SolidWorks parts/Bumper/IRHousing-for Assembly.SLDPRT

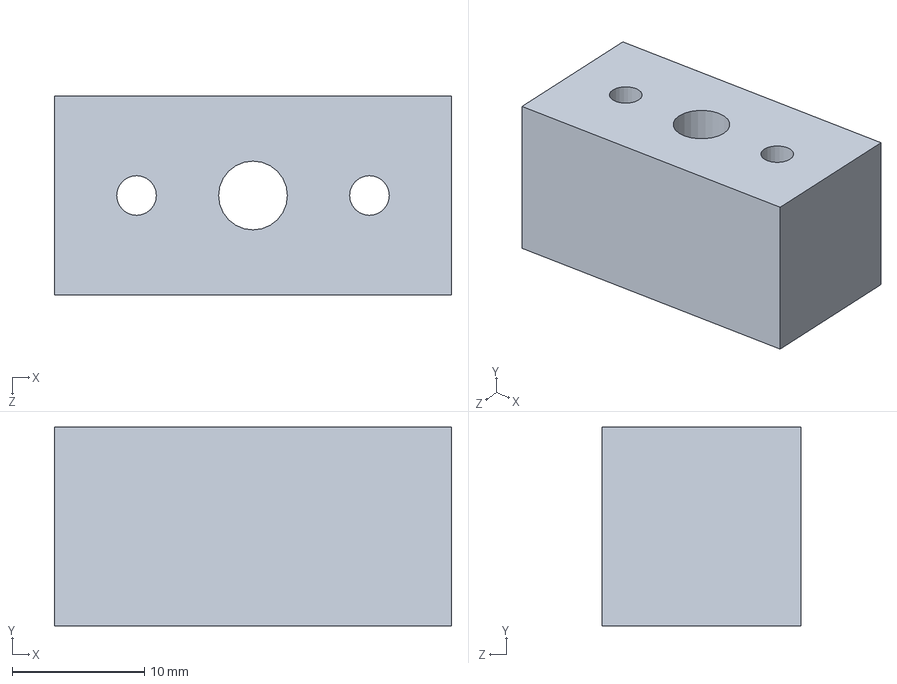
[picture p86: CAD file, 2015-08-01]
SolidWorks parts/Bumper/IRHousing-for Assembly.SLDPRT
30.0 x 15.0 x 15.0 mm
