gzgreg/enph253-2015-team13/SolidWorks parts/Motor-wheel_module/Cfhfh.SLDASM

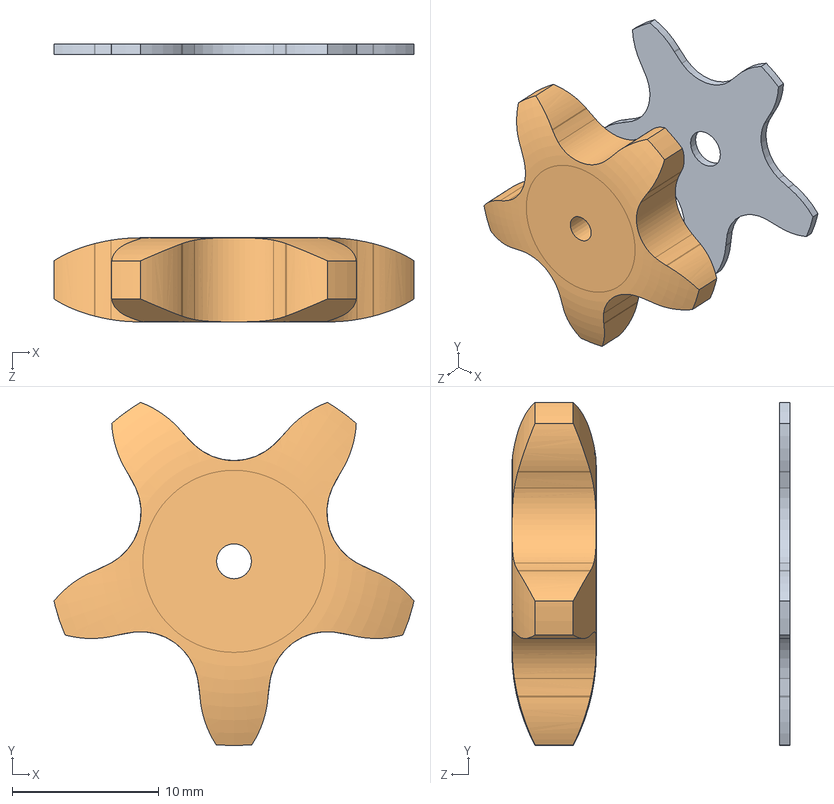
[picture p87: CAD file, 2015-07-04]
SolidWorks parts/Motor-wheel_module/Cfhfh.SLDASM
24.5 x 23.4 x 18.9 mm
9 -tooth-sprocket
precision roller chain sprocket_ai
