gzgreg/enph253-2015-team13/SolidWorks parts/Motor-wheel_module/Assem1.SLDASM

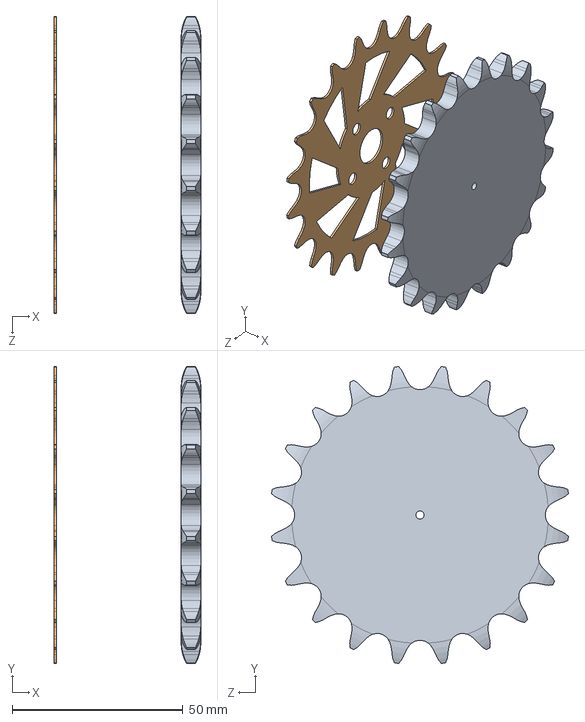
[picture p88: CAD file, 2015-07-04]
SolidWorks parts/Motor-wheel_module/Assem1.SLDASM
42.9 x 86.9 x 86.9 mm
precision roller chain sprocket_ai
30-tooth-sprocket
