gzgreg/enph253-2015-team13/SolidWorks parts/Zip Line Mechanism/RollerFlange-Full.SLDPRT

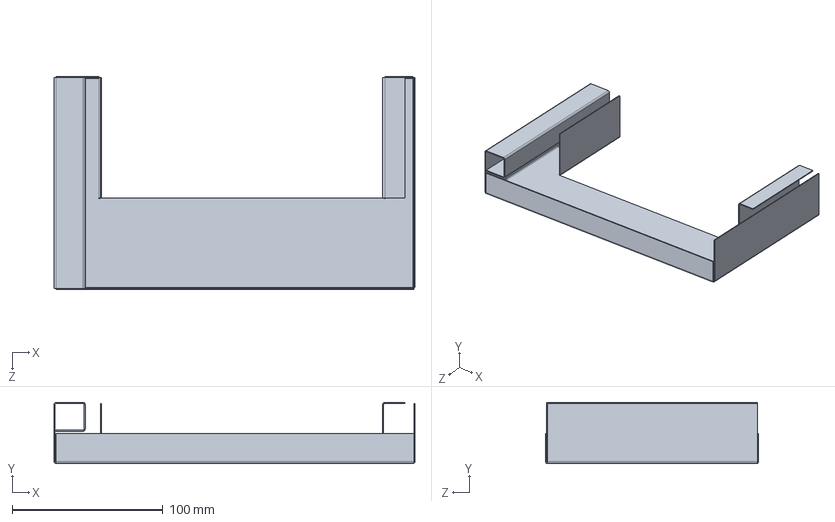
[picture p89: CAD file, 2015-07-30]
SolidWorks parts/Zip Line Mechanism/RollerFlange-Full.SLDPRT
239.4 x 40.7 x 141.5 mm
