gzgreg/enph253-2015-team13/SolidWorks parts/Basket Lift Mechanism - R-Dawg Version 2.0/BasketHoldAssembly.SLDASM

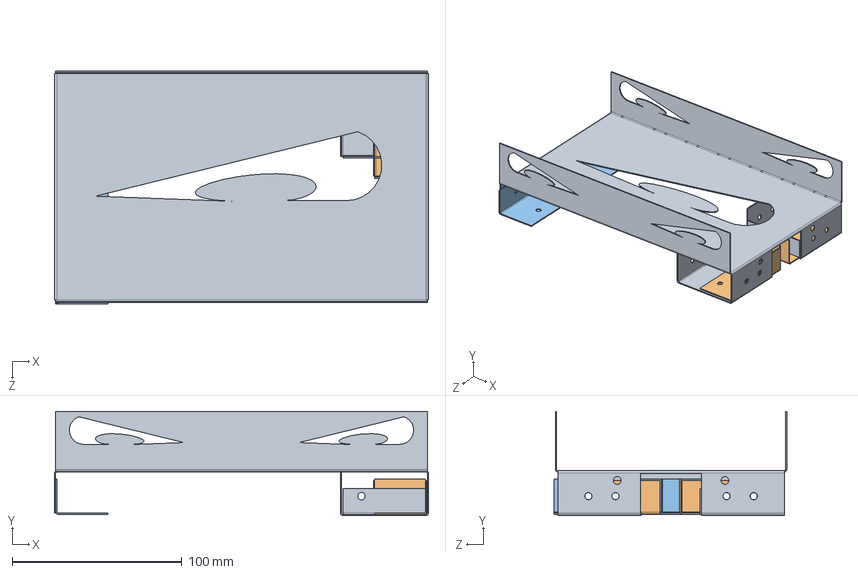
[picture p90: CAD file, 2015-07-17]
SolidWorks parts/Basket Lift Mechanism - R-Dawg Version 2.0/BasketHoldAssembly.SLDASM
220.5 x 61.5 x 137.1 mm
BasketHolder
FixedArmPinJoint x 2
SlidePoleMount
