gzgreg/enph253-2015-team13/SolidWorks parts/Motor-wheel_module/make_9-t-sprocket.SLDASM

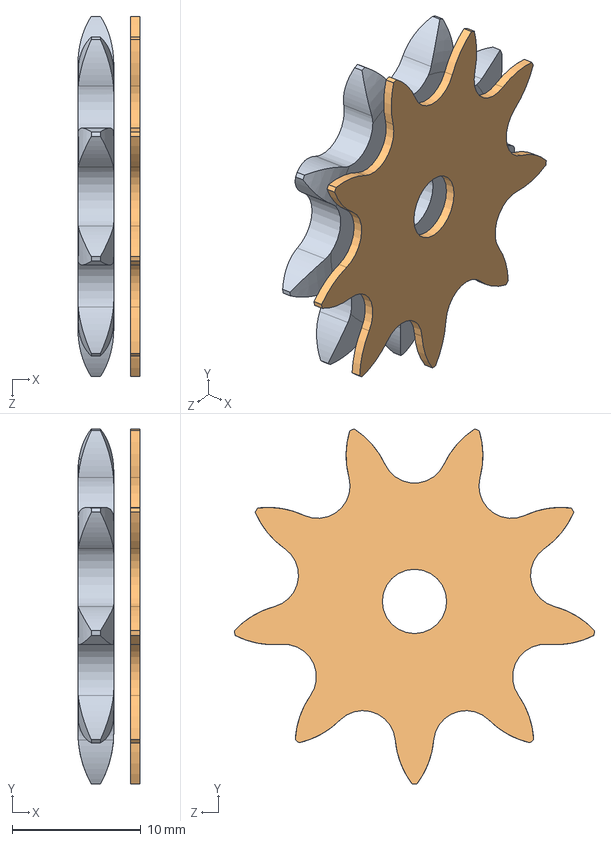
[picture p91: CAD file, 2015-07-04]
SolidWorks parts/Motor-wheel_module/make_9-t-sprocket.SLDASM
4.83 x 27.6 x 28.0 mm
short pitch roller chain wheel_s_iso
9 -tooth-sprocket
