gzgreg/enph253-2015-team13/SolidWorks parts/Zipline Catcher/Zipline Roller Assy Rev 1.SLDASM

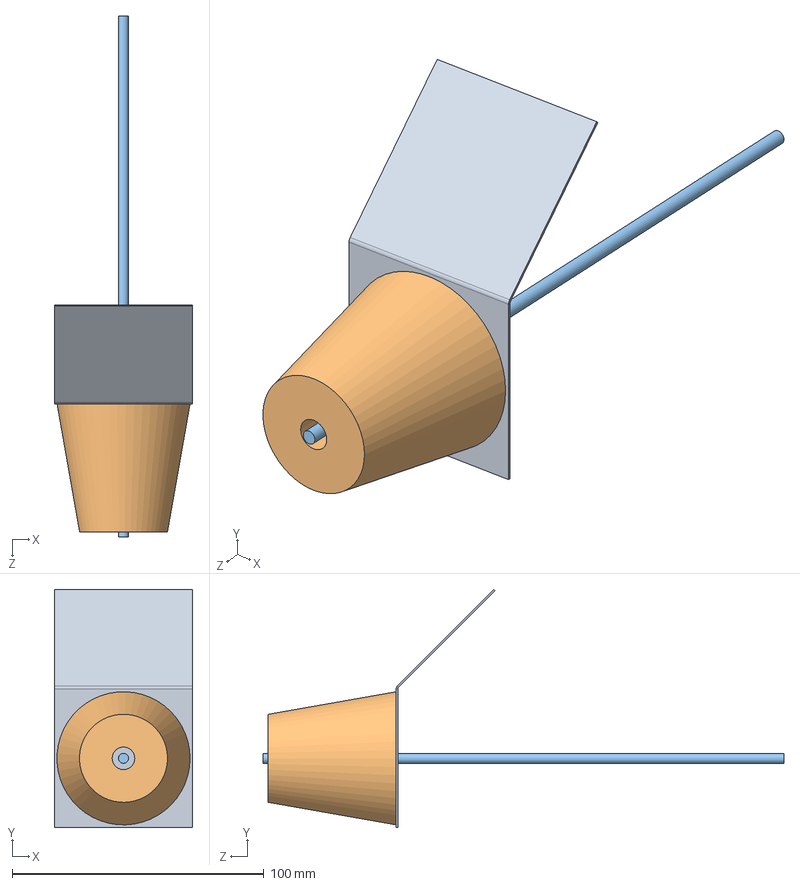
[picture p92: CAD file, 2015-07-14]
SolidWorks parts/Zipline Catcher/Zipline Roller Assy Rev 1.SLDASM
55.0 x 94.6 x 207.0 mm
Guide Piece Rev 1
Zipline Roller Rev 2
Zipline Roller Shaft
