gzgreg/enph253-2015-team13/SolidWorks parts/basket lift motor.SLDASM

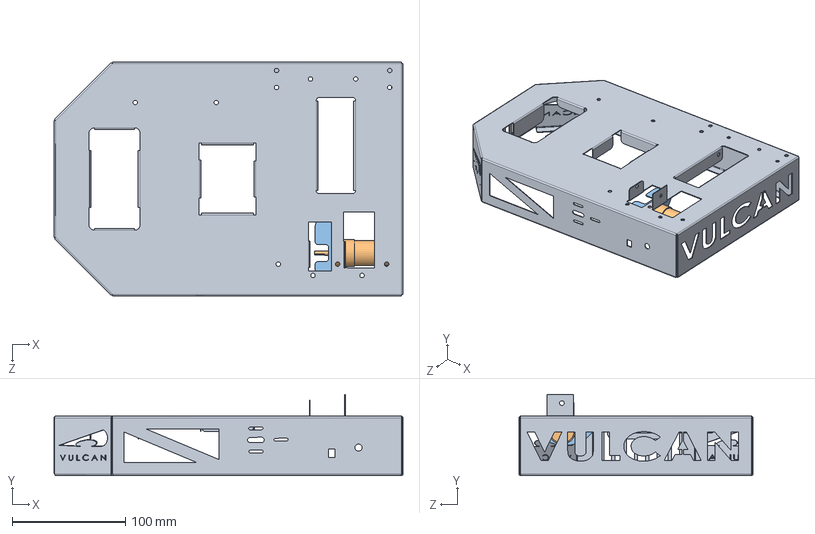
[picture p93: CAD file, 2015-07-31]
SolidWorks parts/basket lift motor.SLDASM
308.3 x 71.8 x 206.7 mm
chassis V4.1
swiss_geared_motor
basket lift motor mount
