gzgreg/enph253-2015-team13/SolidWorks parts/Motor-wheel_module/axelMWasm.SLDPRT

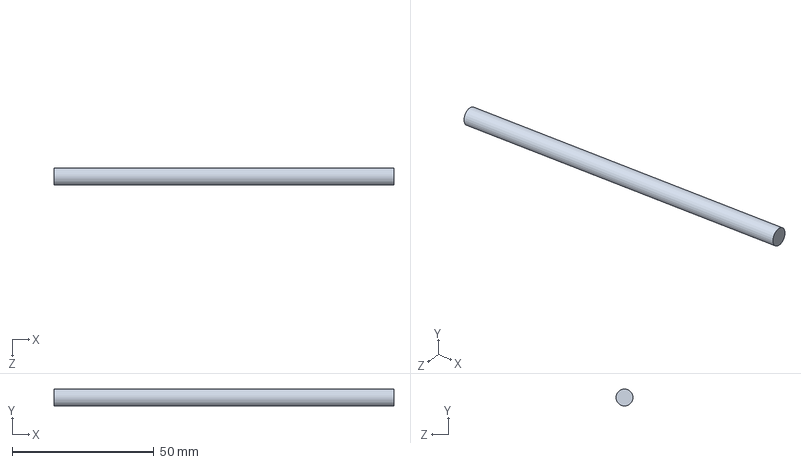
[picture p94: CAD file, 2015-06-27]
SolidWorks parts/Motor-wheel_module/axelMWasm.SLDPRT
120.0 x 6.00 x 6.00 mm
