gzgreg/enph253-2015-team13/SolidWorks parts/Motor-wheel_module/Motor BarbCole Geared (1)MWasm.SLDPRT

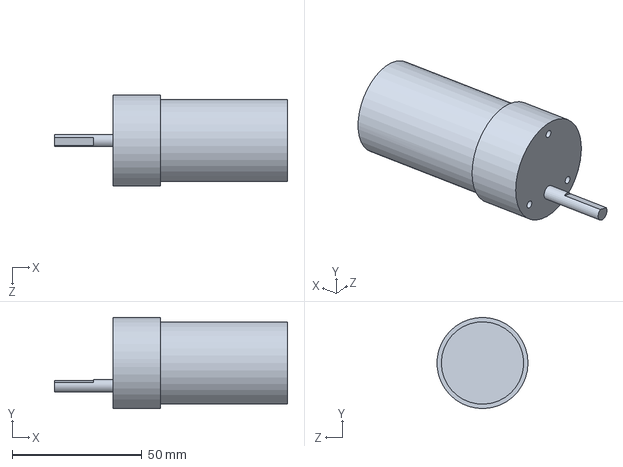
[picture p95: CAD file, 2015-06-26]
SolidWorks parts/Motor-wheel_module/Motor BarbCole Geared (1)MWasm.SLDPRT
89.9 x 35.1 x 35.1 mm
