gzgreg/enph253-2015-team13/SolidWorks parts/mounted_tinah.SLDASM

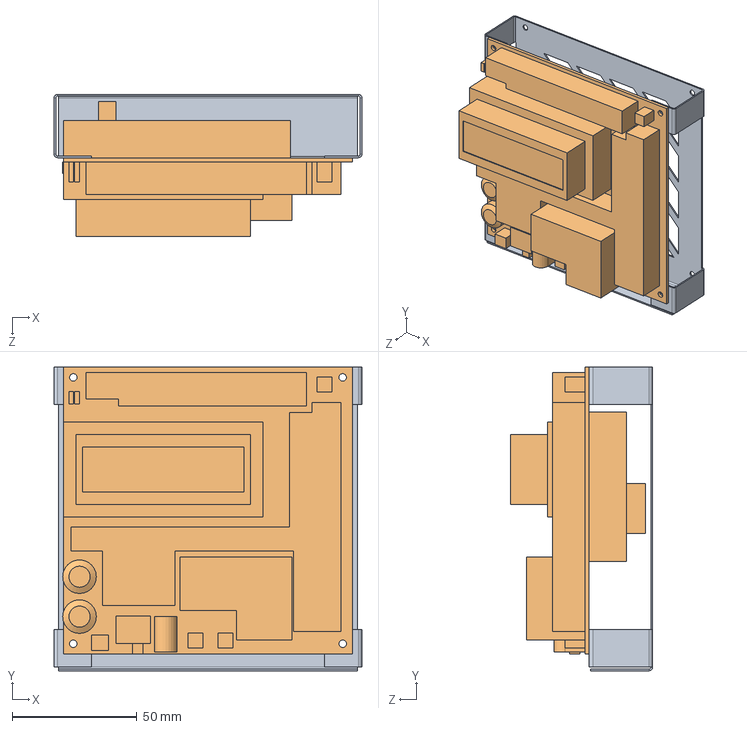
[picture p96: CAD file, 2015-07-30]
SolidWorks parts/mounted_tinah.SLDASM
123.5 x 121.7 x 57.1 mm
tinah mount
Tinah Board
