gzgreg/enph253-2015-team13/SolidWorks parts/Basket Lift Mechanism - Version 1/DrivenArmBasePinJoint-ForMakingAssembly.SLDPRT

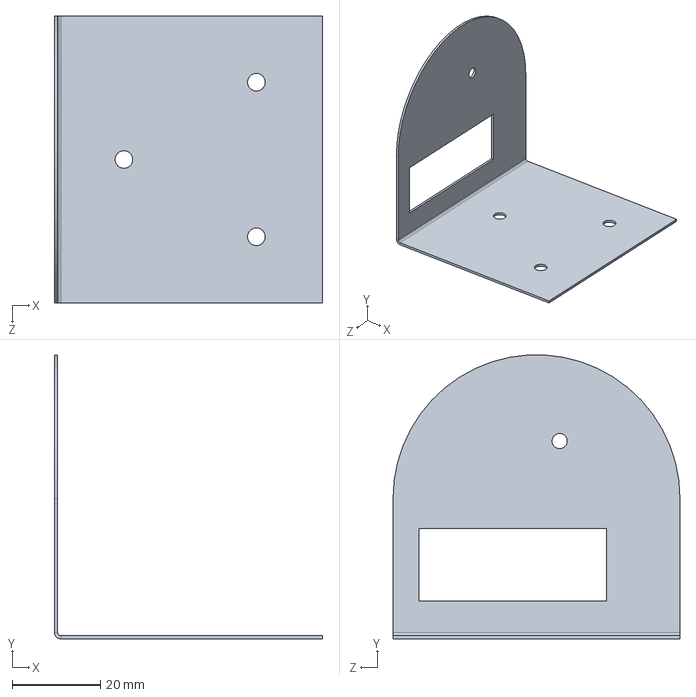
[picture p97: CAD file, 2015-07-16]
SolidWorks parts/Basket Lift Mechanism - Version 1/DrivenArmBasePinJoint-ForMakingAssembly.SLDPRT
60.7 x 64.3 x 65.0 mm
