gzgreg/enph253-2015-team13/SolidWorks parts/chassis v4.0.SLDASM

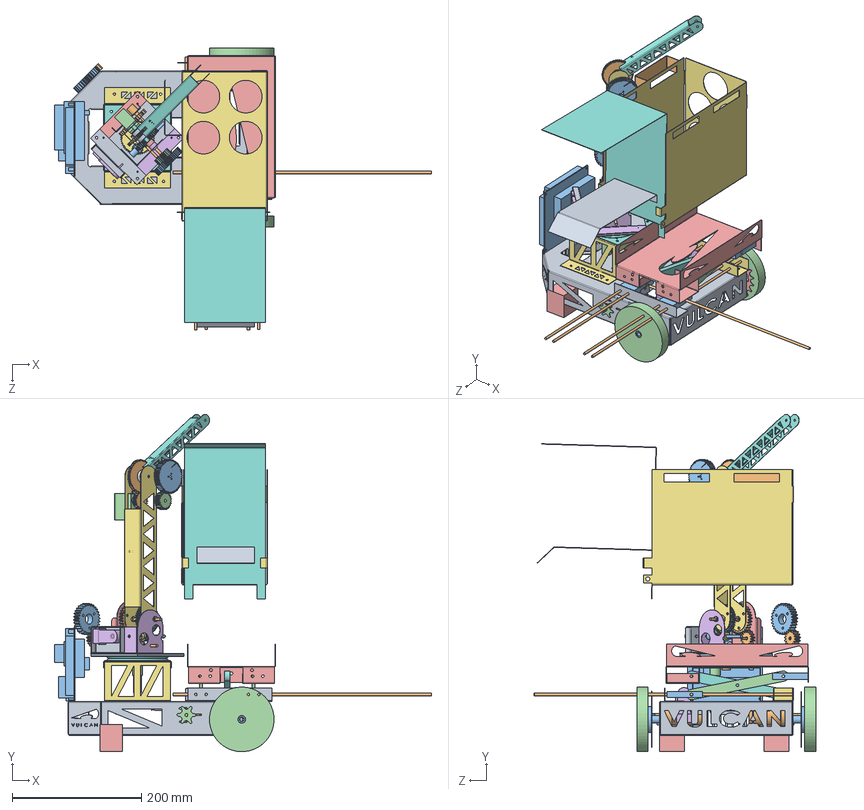
[picture p98: CAD file, 2015-07-30]
SolidWorks parts/chassis v4.0.SLDASM
583.6 x 522.2 x 435.9 mm
chassis V4.0
Motor BarbCole Geared (1) x 2
wheel hubMWasm x 2
wheelMWasm x 2
20-tooth-sprocket x 2
QRD x 2
Tinah Board
6-tooth-sprocket x 2
castor_wheel_crude x 2
FixedArmPinJoint
FixedArmPinJoint-WithSlidePoleMounts
FixedArmShaft
SlidePoleMount
SlideArmSlidePole x 5
SlideArmPinSlider x 4
SlideArmShaft x 2
BasketHolder
GM7 x 2
arm_mountV4.0
6031K170 (Lazy Susan)V4.0
Internal_spurV4.0
PotentiometerV4.0 x 2
arm_rotation_spur_gearV4.0
Arm_rotation_motorV4.0
Part3V4.0
Arm base Flange with motor mountV4.0
worm for helical gearV4.0
helical gear 40 teethV4.0
Mecano ThingyV4.0
4mm_shaftV4.0 x 2
metal_shaft_couplerV4.0
Servo Futaba S3003V4.0
Servo SpindleV4.0
Servo RotorV4.0
amr_seg2_v3V4.0
gear spacerV4.0 x 2
arm_segment_v3V4.0
spur gear_iso x 4
mod1_50t_laser_offsetV4.0
mod1_25T_gear_laser_offsetV4.0
bushing-spacerV4.0
bushing-spacer2V4.0 x 2
bushing-spacer3V4.0
top_arm_spacerV4.0 x 2
new motor flange
pot_gear
arm_encoder_gear
