gzgreg/enph253-2015-team13/SolidWorks parts/Motor-wheel_module/wheel.SLDASM

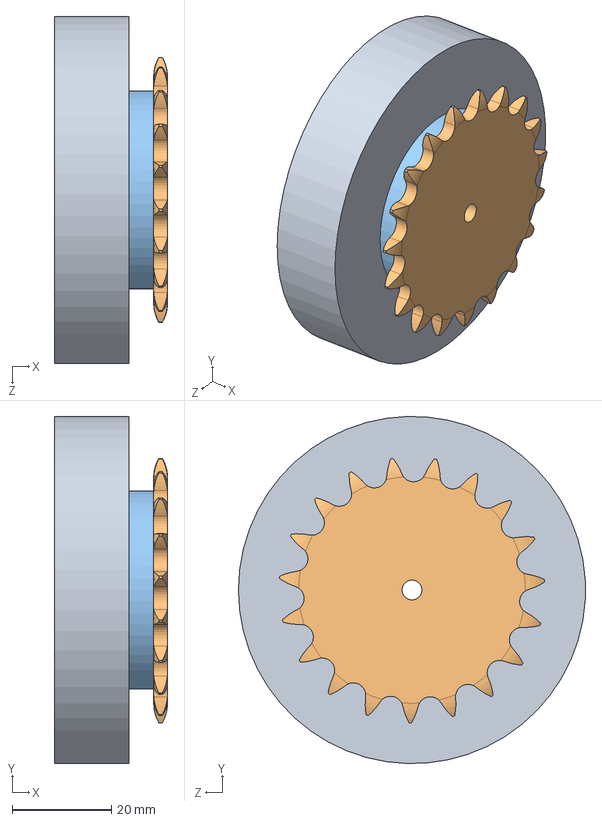
[picture p99: CAD file, 2015-06-24]
SolidWorks parts/Motor-wheel_module/wheel.SLDASM
22.8 x 70.0 x 70.0 mm
wheel
short pitch roller chain wheel_s_iso
wheel hub
