gzgreg/enph253-2015-team13/SolidWorks parts/ARM Design/Design 5/MountV4.0V5.0.SLDASM

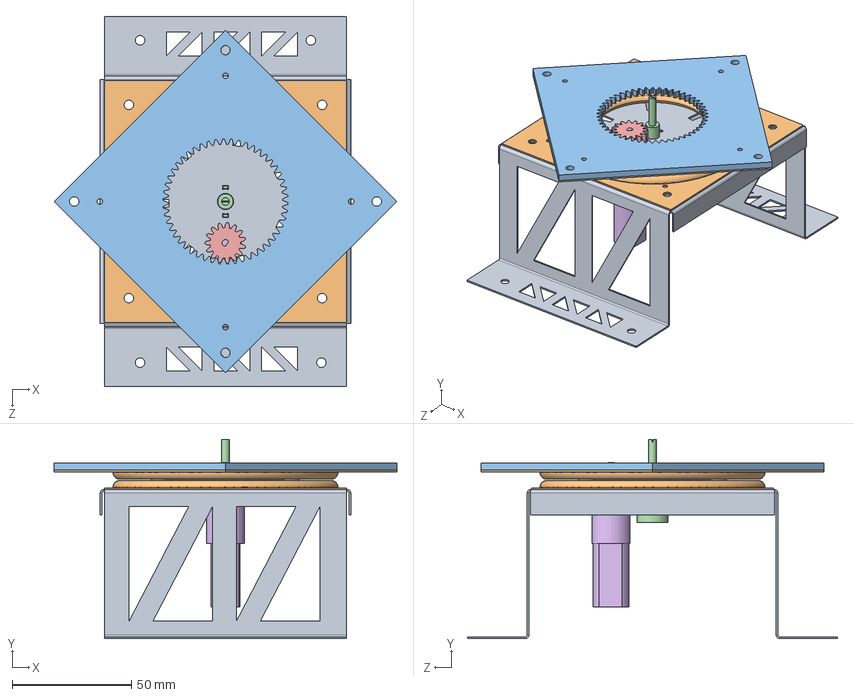
[picture p100: CAD file, 2015-07-30]
SolidWorks parts/ARM Design/Design 5/MountV4.0V5.0.SLDASM
143.7 x 83.5 x 155.1 mm
arm_mount
6031K170 (Lazy Susan)
Internal_spur
Potentiometer
arm_rotation_spur_gear
Arm_rotation_motor
