gzgreg/enph253-2015-team13/SolidWorks parts/worm and gear assembly.SLDASM

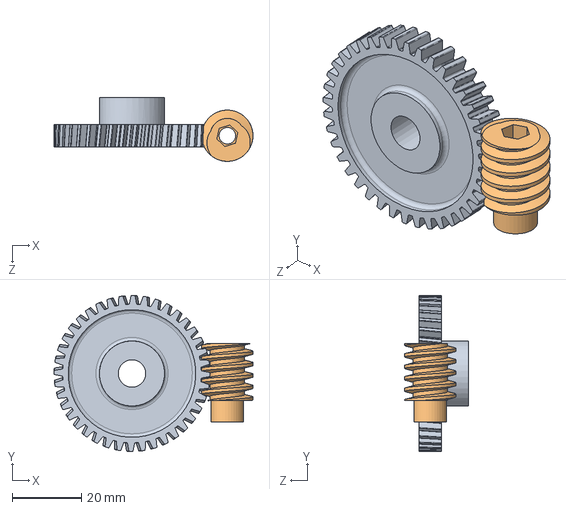
[picture p101: CAD file, 2015-07-08]
SolidWorks parts/worm and gear assembly.SLDASM
57.4 x 45.0 x 18.4 mm
helical gear 40 teeth
worm for helical gear
