gzgreg/enph253-2015-team13/SolidWorks parts/Assem2.SLDASM

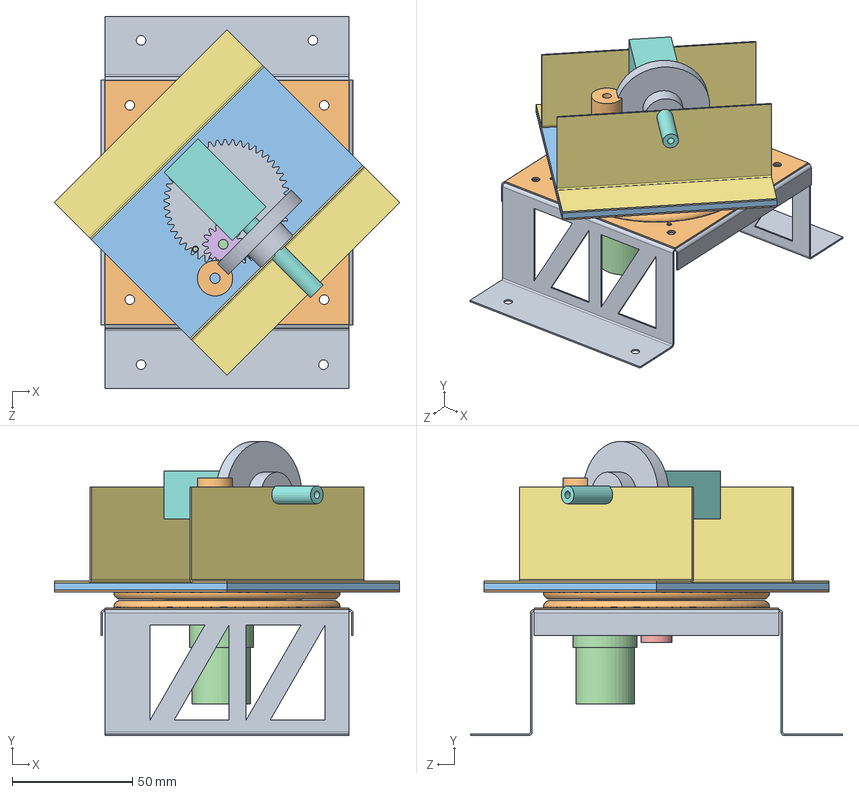
[picture p102: CAD file, 2015-07-08]
SolidWorks parts/Assem2.SLDASM
143.7 x 122.5 x 155.1 mm
arm_mount
6031K170 (Lazy Susan)
Internal_spur
small_geared_motot
Potentiometer
arm_rotation_spur_gear
gear for worm
basic worm
