gzgreg/enph253-2015-team13/SolidWorks parts/Robot.SLDASM

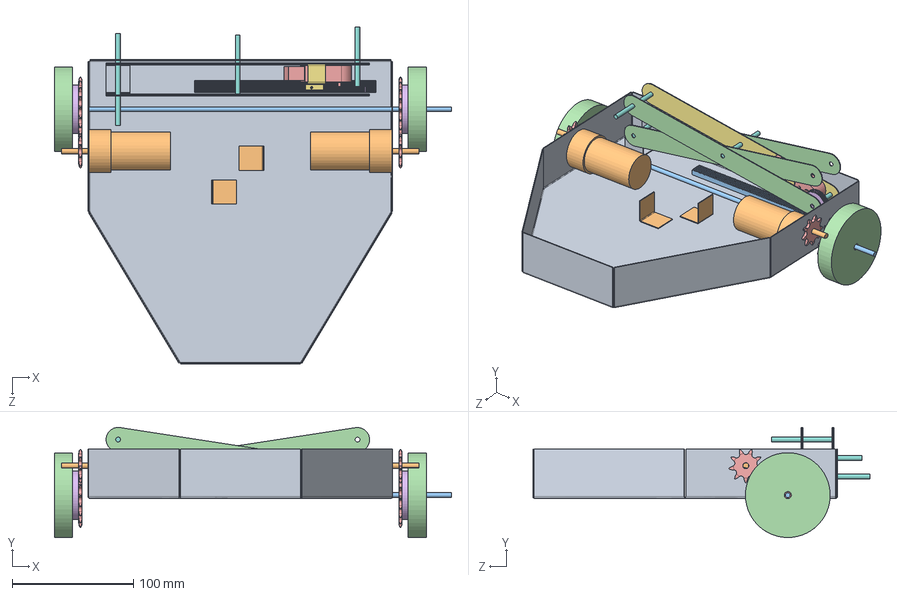
[picture p103: CAD file, 2015-06-24]
SolidWorks parts/Robot.SLDASM
327.8 x 90.9 x 278.5 mm
Chassis V3.0
Motor BarbCole Geared (1) x 2
rack spur rectangular_iso
Linkage long part x 3
GM7
spur gear_iso x 3
linage with motor mount
4mmShaft x 4
linkage bracket
Wheel_mount_bracket x 2
Axel
wheel x 2
short pitch roller chain wheel_s_iso x 4
wheel hub x 2
