gzgreg/enph253-2015-team13/SolidWorks parts/ARM Design/Spur_teeth_cut.SLDASM

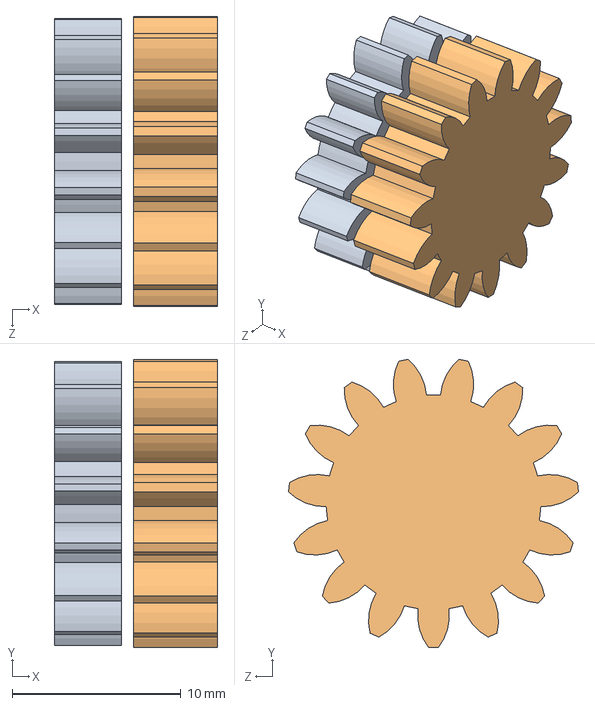
[picture p104: CAD file, 2015-07-07]
SolidWorks parts/ARM Design/Spur_teeth_cut.SLDASM
9.70 x 17.1 x 17.2 mm
spur gear_iso
arm_rotation_spur_gear
