gzgreg/enph253-2015-team13/SolidWorks parts/Assem1.SLDASM

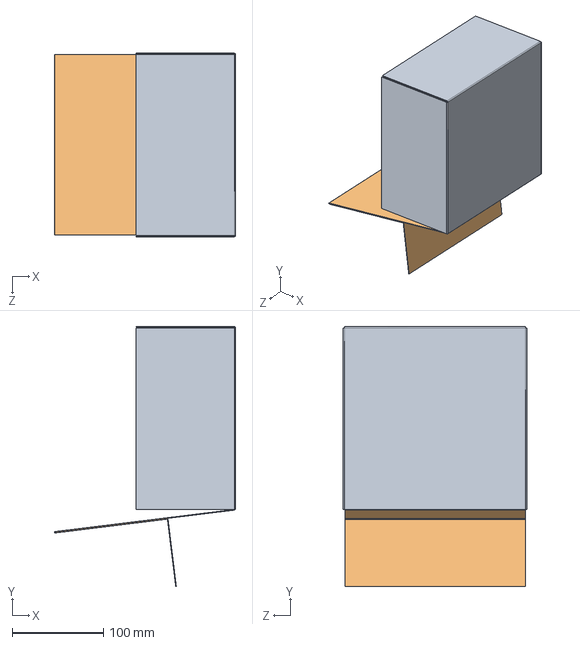
[picture p105: CAD file, 2015-06-11]
SolidWorks parts/Assem1.SLDASM
199.1 x 285.4 x 201.5 mm
basket
