gzgreg/enph253-2015-team13/SolidWorks parts/ARM Design/internal_spur_offset_cut.SLDASM

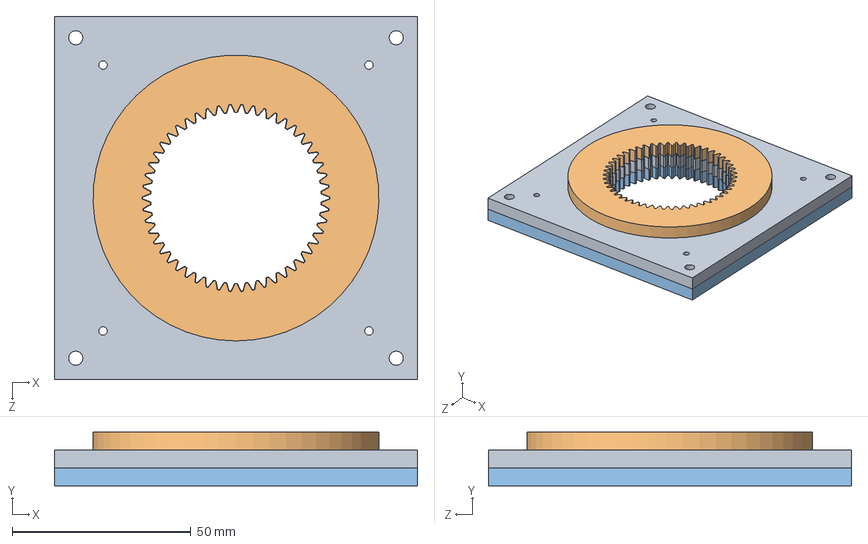
[picture p106: CAD file, 2015-07-07]
SolidWorks parts/ARM Design/internal_spur_offset_cut.SLDASM
101.6 x 15.0 x 101.6 mm
internal_spur_offset
internal spur gear_iso
Internal_spur
