gzgreg/enph253-2015-team13/SolidWorks parts/ARM Design/internal_spur_cut.SLDASM

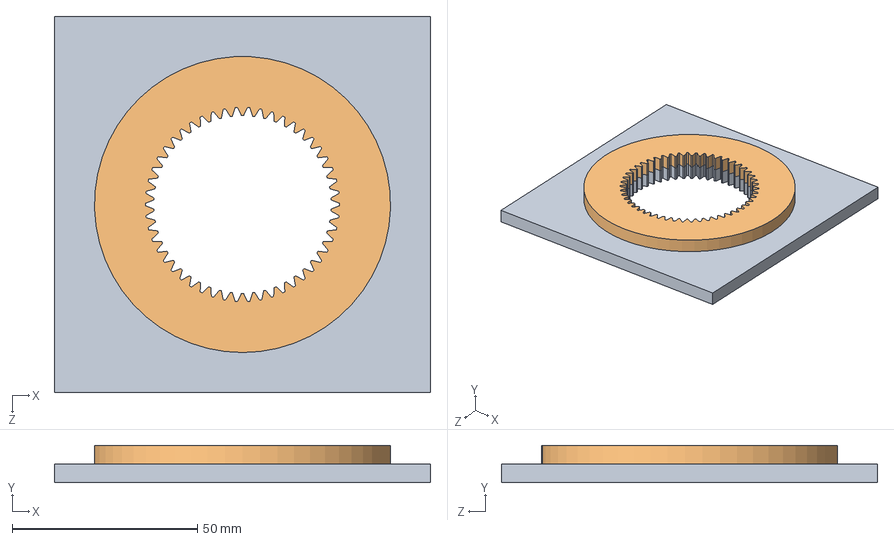
[picture p107: CAD file, 2015-07-04]
SolidWorks parts/ARM Design/internal_spur_cut.SLDASM
101.6 x 10.0 x 101.6 mm
Internal_spur
internal spur gear_iso
