gzgreg/enph253-2015-team13/SolidWorks parts/ARM Design/Design 1/armRotationPlateV2.0.SLDPRT

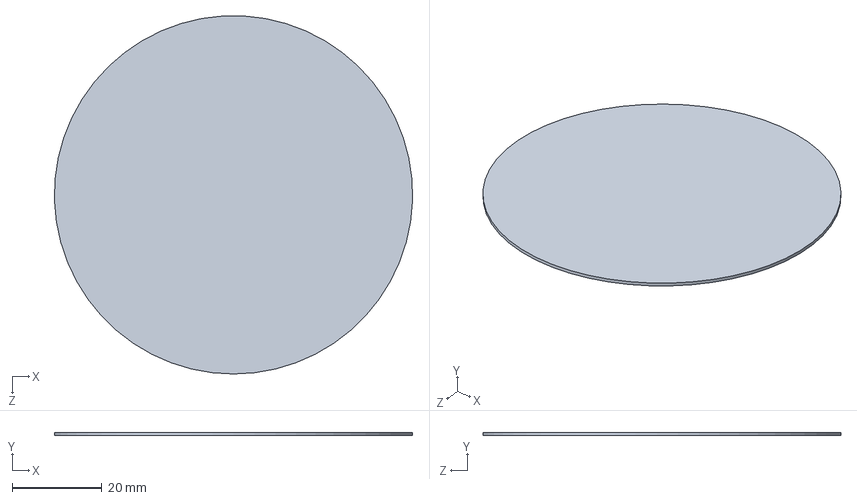
[picture p108: CAD file, 2015-06-18]
SolidWorks parts/ARM Design/Design 1/armRotationPlateV2.0.SLDPRT
80.0 x 0.737 x 79.9 mm
