gzgreg/enph253-2015-team13/SolidWorks parts/ARM Design/Design 5/helical gear 40 teethV4.0V5.0.SLDPRT

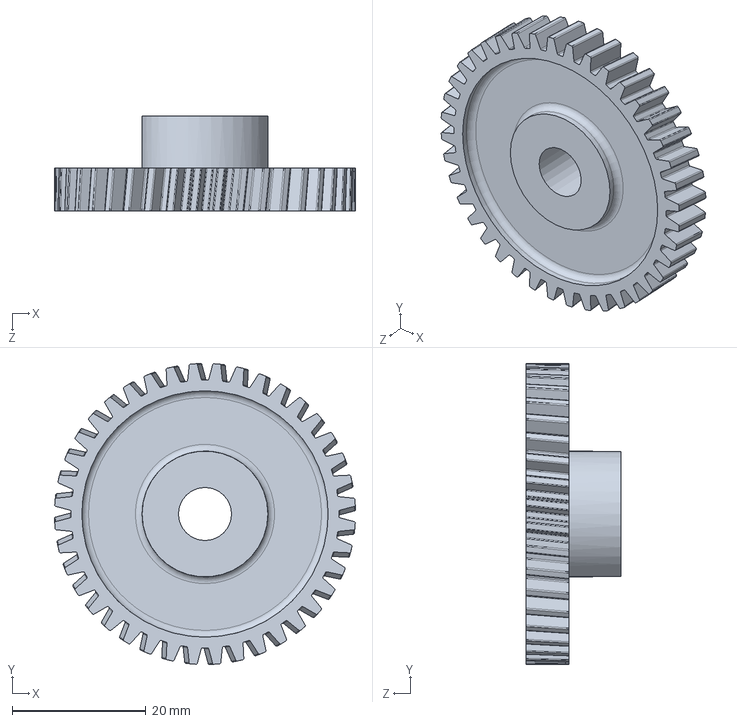
[picture p109: CAD file, 2015-08-13]
SolidWorks parts/ARM Design/Design 5/helical gear 40 teethV4.0V5.0.SLDPRT
45.0 x 45.0 x 14.2 mm
