gzgreg/enph253-2015-team13/SolidWorks parts/Arm Release/Steel Plate Rev 1.SLDPRT

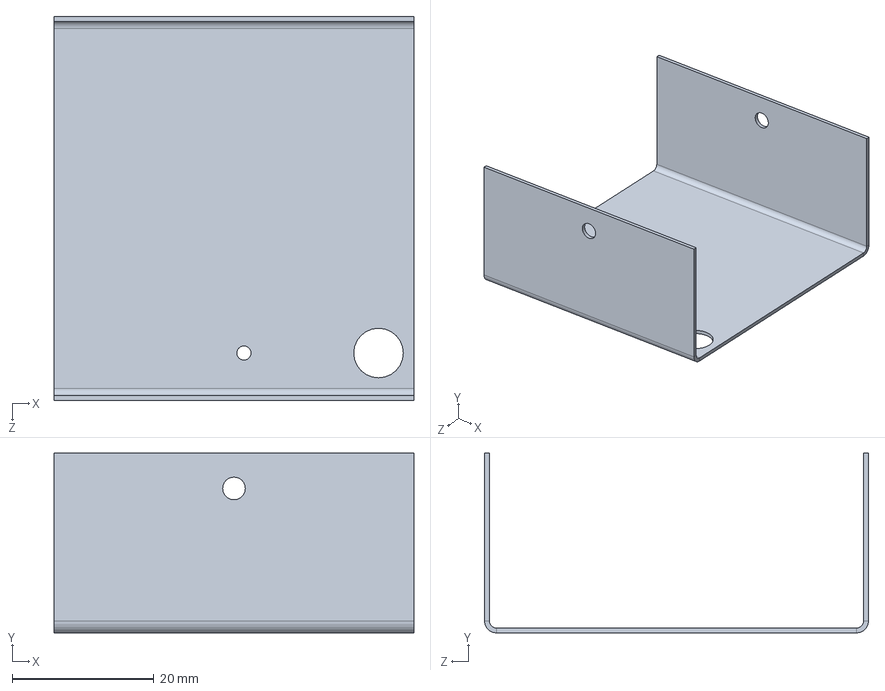
[picture p110: CAD file, 2015-07-10]
SolidWorks parts/Arm Release/Steel Plate Rev 1.SLDPRT
50.8 x 25.4 x 54.2 mm
