gzgreg/enph253-2015-team13/SolidWorks parts/Basket Lift Mechanism - R-Dawg Version 2.0/FixedArmPinJoint.SLDPRT

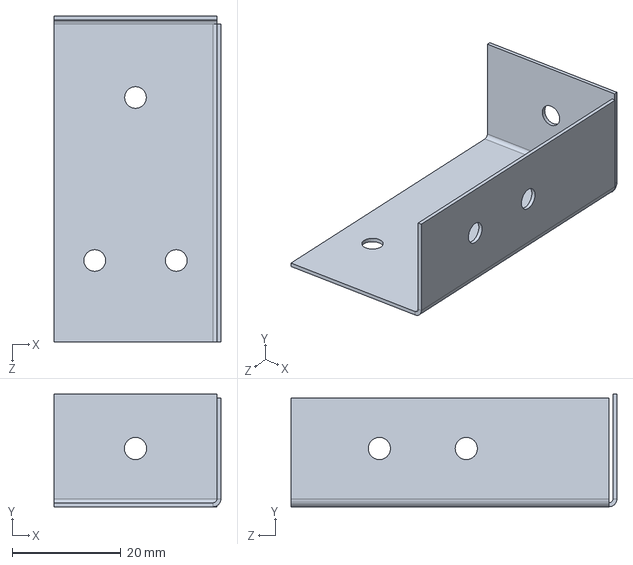
[picture p111: CAD file, 2015-07-22]
SolidWorks parts/Basket Lift Mechanism - R-Dawg Version 2.0/FixedArmPinJoint.SLDPRT
30.7 x 20.7 x 60.0 mm
