gzgreg/enph253-2015-team13/SolidWorks parts/Basket Lift/linage with motor mount.SLDPRT

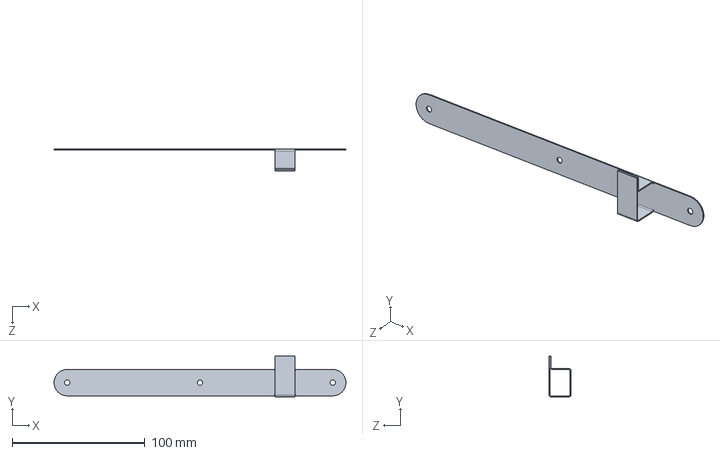
[picture p112: CAD file, 2015-06-24]
SolidWorks parts/Basket Lift/linage with motor mount.SLDPRT
220.0 x 30.7 x 16.5 mm
