gzgreg/enph253-2015-team13/SolidWorks parts/Bumper/PickupFlange.SLDPRT

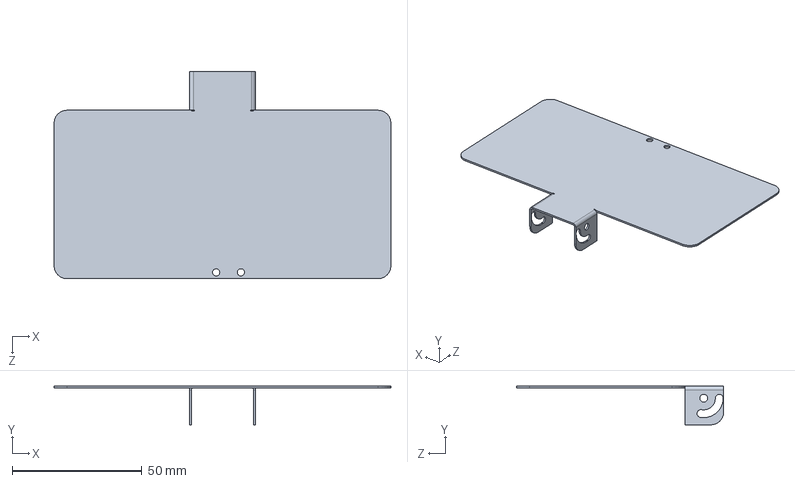
[picture p113: CAD file, 2015-08-13]
SolidWorks parts/Bumper/PickupFlange.SLDPRT
130.0 x 15.0 x 80.0 mm
