gzgreg/enph253-2015-team13/SolidWorks parts/james' zipline/Part2.SLDPRT

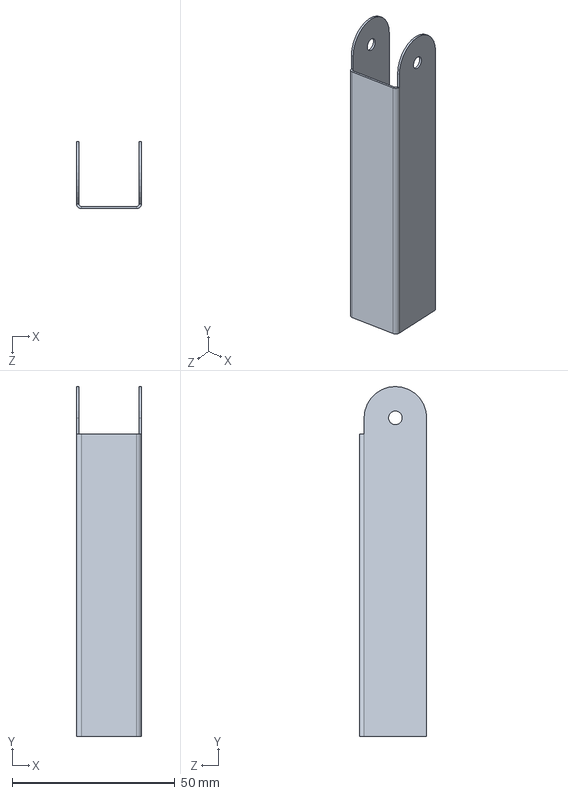
[picture p114: CAD file, 2015-07-04]
SolidWorks parts/james' zipline/Part2.SLDPRT
19.9 x 107.6 x 20.7 mm
