gzgreg/enph253-2015-team13/SolidWorks parts/Motor-wheel_module/20-tooth-sprocket.SLDPRT

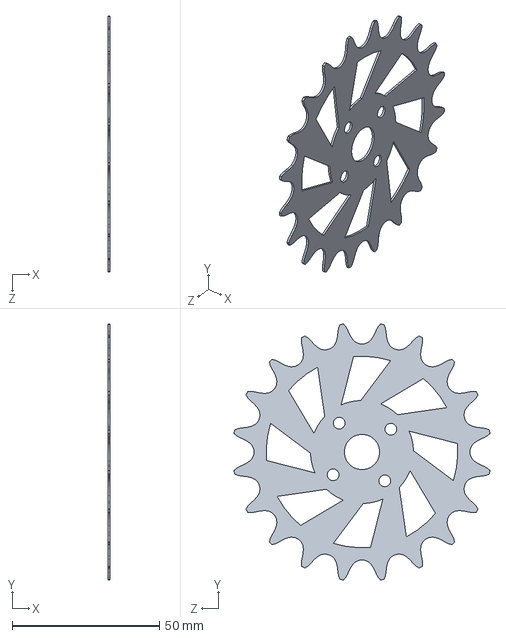
[picture p115: CAD file, 2015-08-13]
SolidWorks parts/Motor-wheel_module/20-tooth-sprocket.SLDPRT
0.737 x 86.9 x 86.9 mm
