gzgreg/enph253-2015-team13/SolidWorks parts/Servo futaba/Servo Spindle.SLDPRT

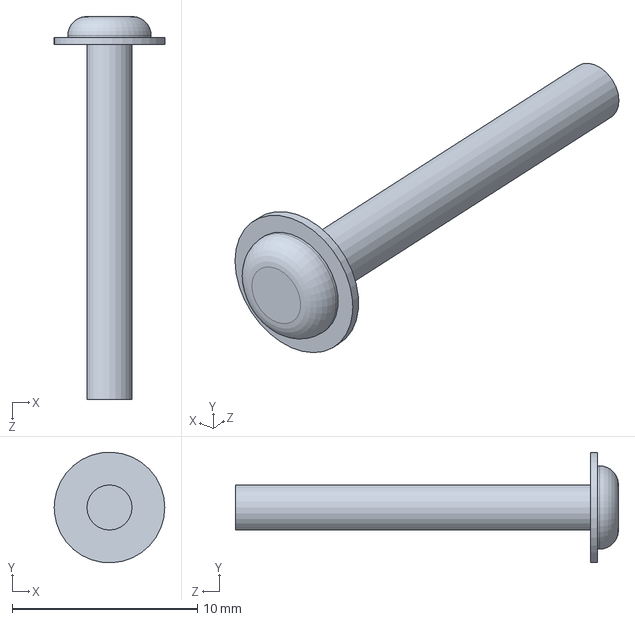
[picture p116: CAD file, 2015-07-08]
SolidWorks parts/Servo futaba/Servo Spindle.SLDPRT
5.97 x 5.96 x 20.7 mm
