gzgreg/enph253-2015-team13/SolidWorks parts/tinah mount.SLDPRT

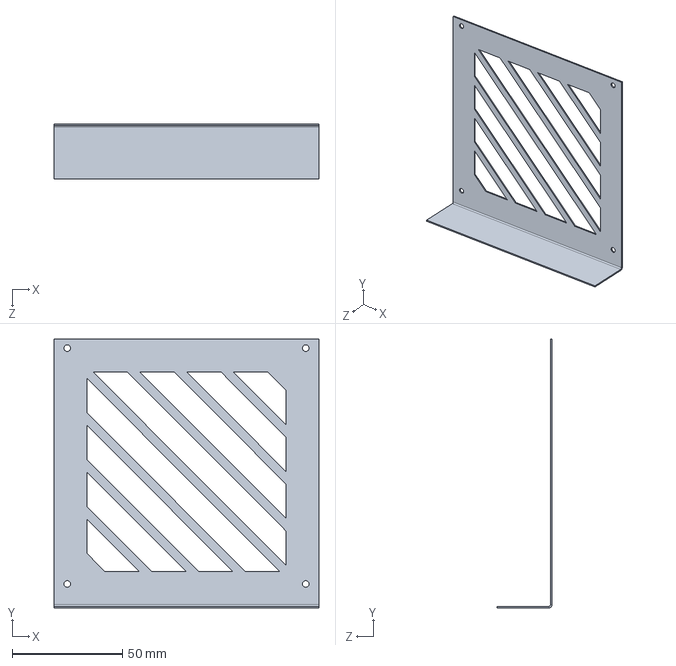
[picture p117: CAD file, 2015-08-13]
SolidWorks parts/tinah mount.SLDPRT
120.0 x 121.7 x 25.0 mm
