gzgreg/enph253-2015-team13/Robot/SolidWorks Parts/PCB box.SLDPRT

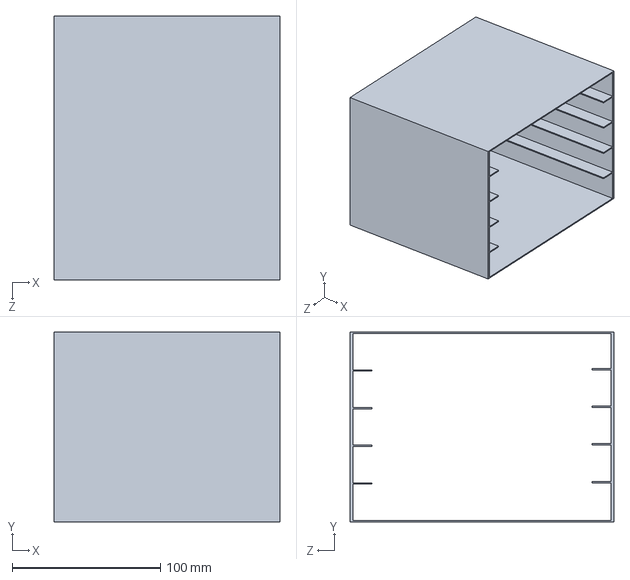
[picture p118: CAD file, 2015-06-17]
Robot/SolidWorks Parts/PCB box.SLDPRT
152.4 x 128.0 x 177.8 mm
