gzgreg/enph253-2015-team13/Robot/SolidWorks Parts/Zipline Mechanism/Bearing Holder.SLDPRT

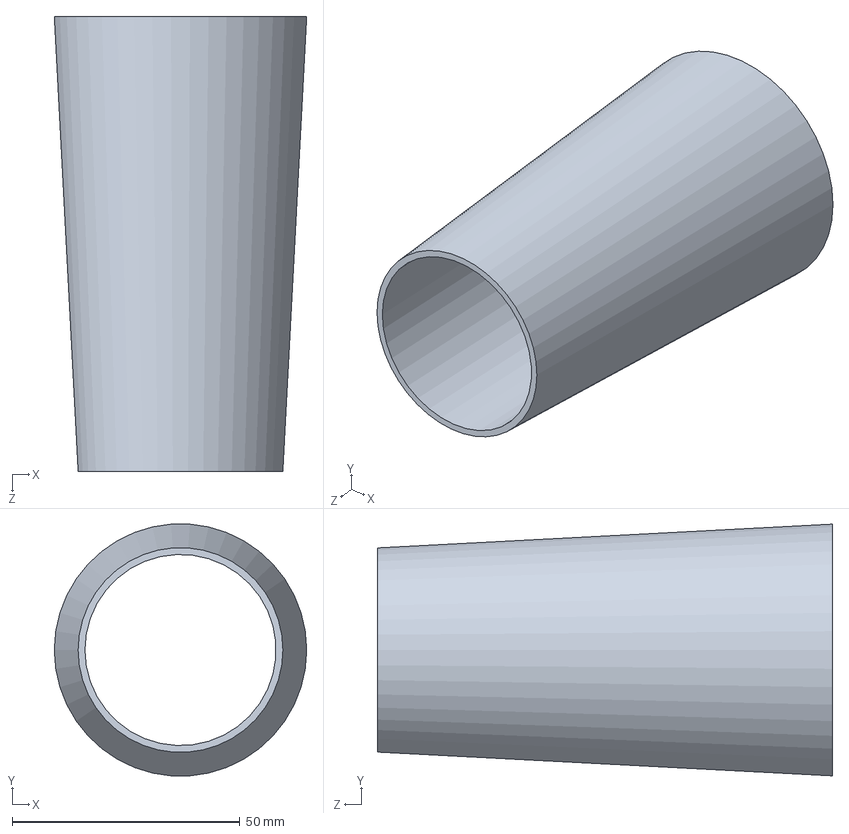
[picture p119: CAD file, 2015-06-15]
Robot/SolidWorks Parts/Zipline Mechanism/Bearing Holder.SLDPRT
55.5 x 55.3 x 100.0 mm
