gzgreg/enph253-2015-team13/SolidWorks parts/ARM Design/Design 2/Pickup_Mechanism.SLDPRT

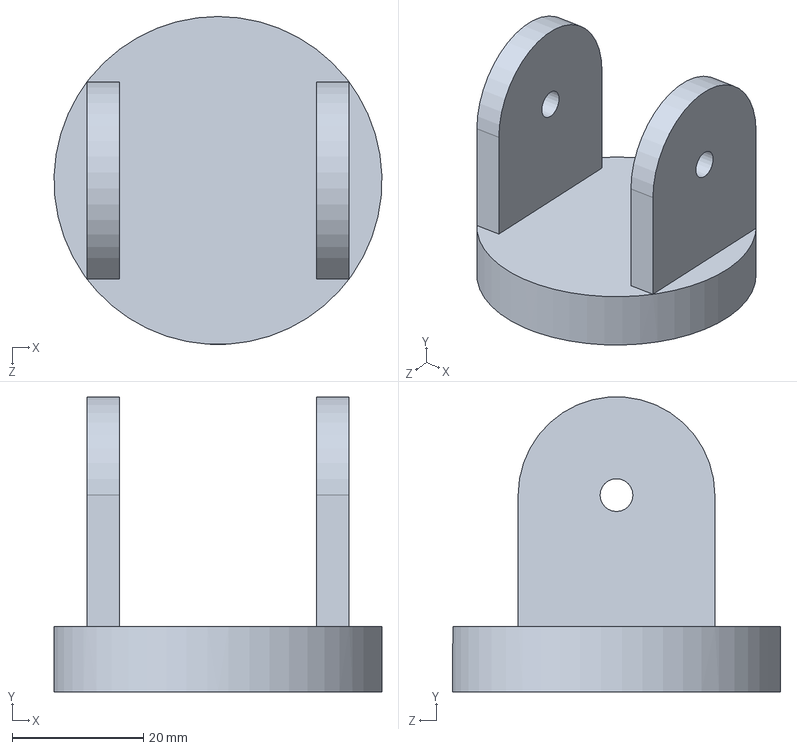
[picture p120: CAD file, 2015-06-18]
SolidWorks parts/ARM Design/Design 2/Pickup_Mechanism.SLDPRT
50.0 x 44.9 x 50.0 mm
