gzgreg/enph253-2015-team13/SolidWorks parts/ARM Design/Design 5/Part3V4.0V5.0.SLDPRT

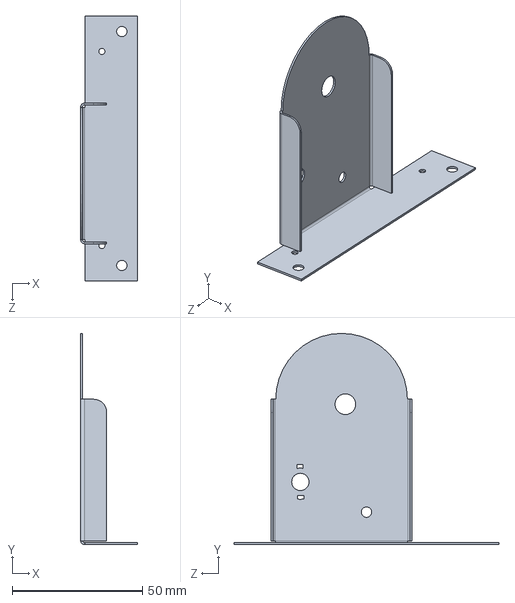
[picture p121: CAD file, 2015-08-13]
SolidWorks parts/ARM Design/Design 5/Part3V4.0V5.0.SLDPRT
21.7 x 81.0 x 101.6 mm
