gzgreg/enph253-2015-team13/SolidWorks parts/ARM Design/gear spacer.SLDPRT

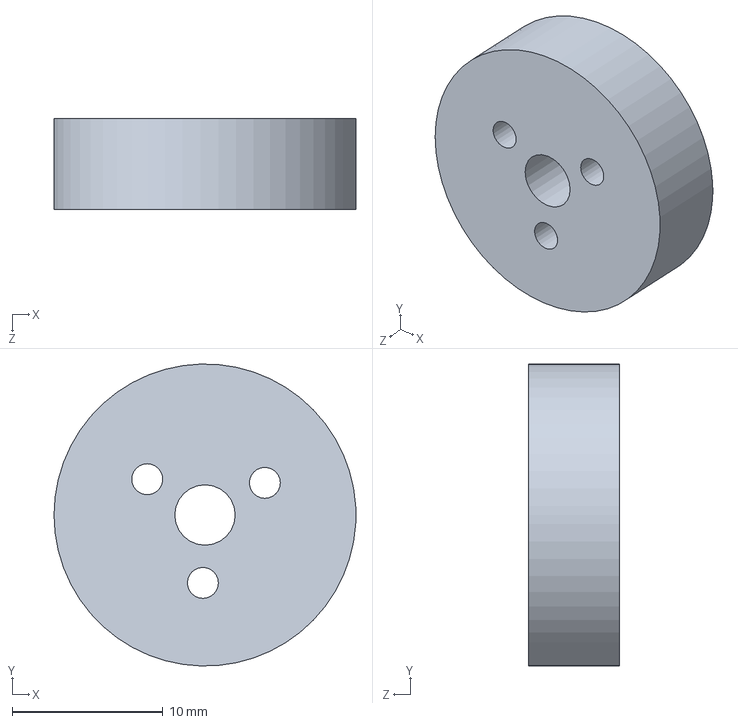
[picture p122: CAD file, 2015-08-01]
SolidWorks parts/ARM Design/gear spacer.SLDPRT
20.0 x 20.0 x 6.00 mm
