gzgreg/enph253-2015-team13/SolidWorks parts/Arm Release/Servo Rotor.SLDPRT

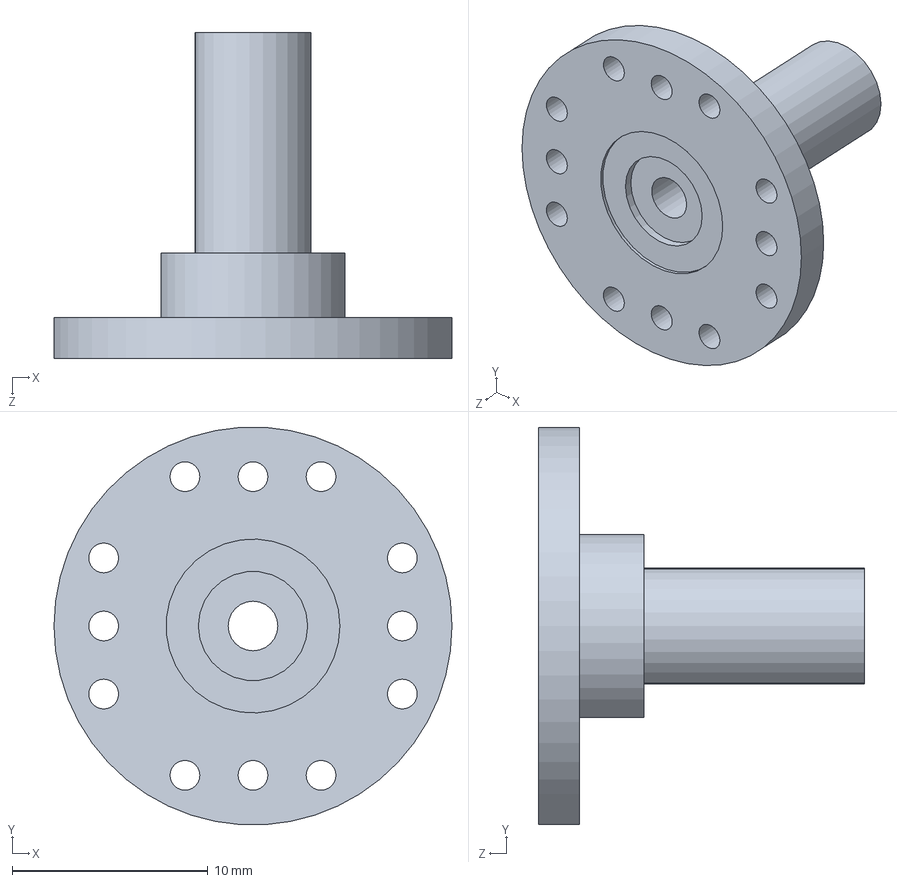
[picture p123: CAD file, 2015-07-10]
SolidWorks parts/Arm Release/Servo Rotor.SLDPRT
20.3 x 20.3 x 16.7 mm
