gzgreg/enph253-2015-team13/SolidWorks parts/Basket Lift Mechanism - R-Dawg Version 2.0/RollerSpacers.SLDPRT

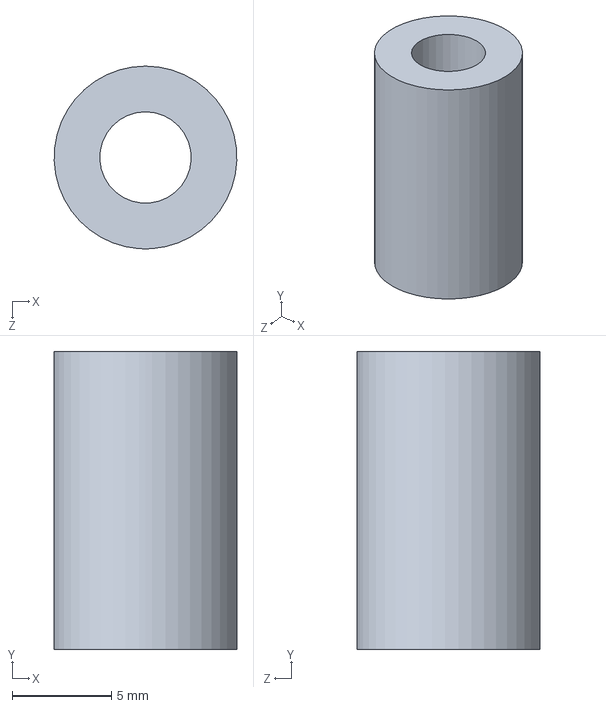
[picture p124: CAD file, 2015-07-22]
SolidWorks parts/Basket Lift Mechanism - R-Dawg Version 2.0/RollerSpacers.SLDPRT
9.19 x 15.0 x 9.20 mm
