gzgreg/enph253-2015-team13/SolidWorks parts/Basket Lift Mechanism - Version 1/WormGear.SLDPRT

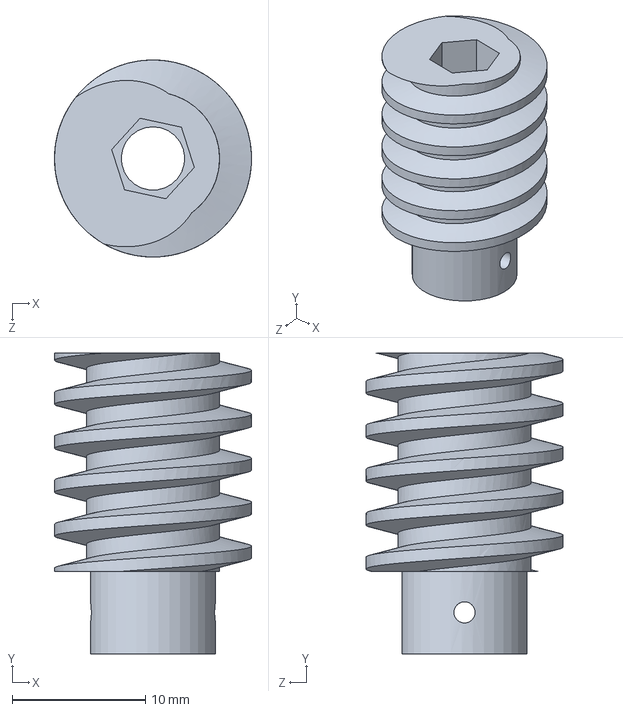
[picture p125: CAD file, 2015-07-16]
SolidWorks parts/Basket Lift Mechanism - Version 1/WormGear.SLDPRT
14.8 x 22.6 x 14.8 mm
