gzgreg/enph253-2015-team13/SolidWorks parts/Bumper/MicroSwitchMount-withIRMount.SLDPRT

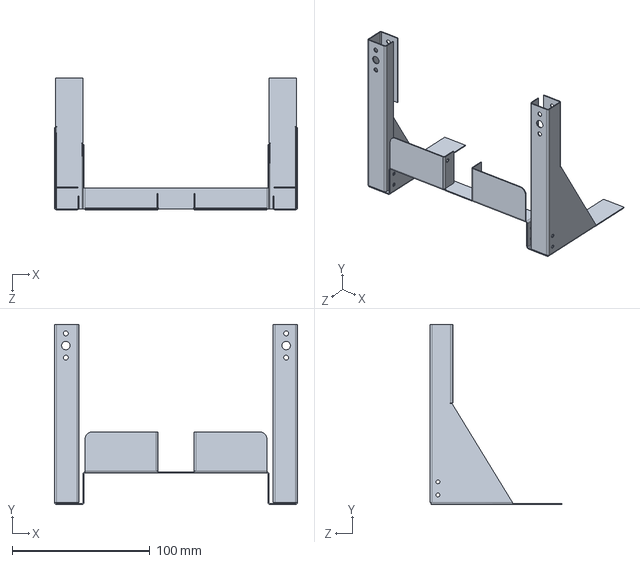
[picture p126: CAD file, 2015-08-13]
SolidWorks parts/Bumper/MicroSwitchMount-withIRMount.SLDPRT
176.5 x 130.7 x 95.7 mm
