gzgreg/enph253-2015-team13/SolidWorks parts/james' zipline/Part3.SLDPRT

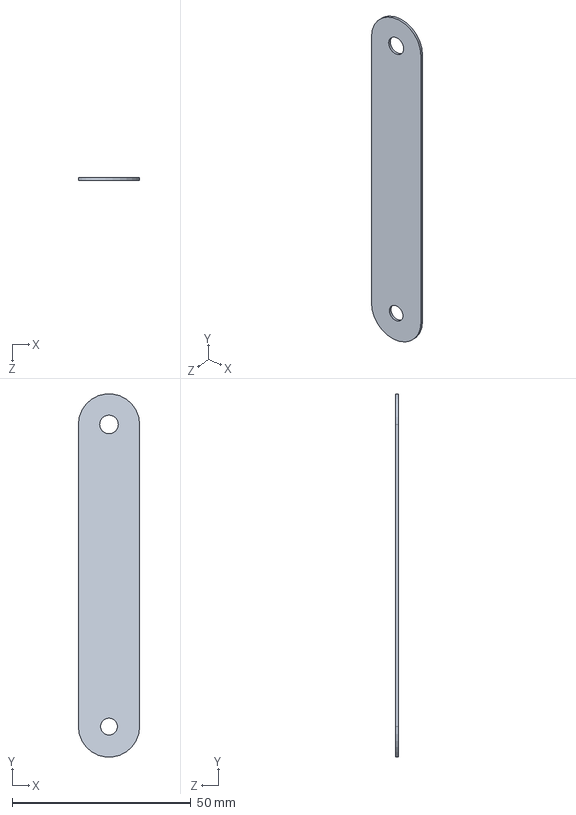
[picture p127: CAD file, 2015-07-04]
SolidWorks parts/james' zipline/Part3.SLDPRT
17.1 x 101.5 x 0.737 mm
