gzgreg/enph253-2015-team13/SolidWorks parts/PLAN B STUFF/Basket-Caution.SLDPRT

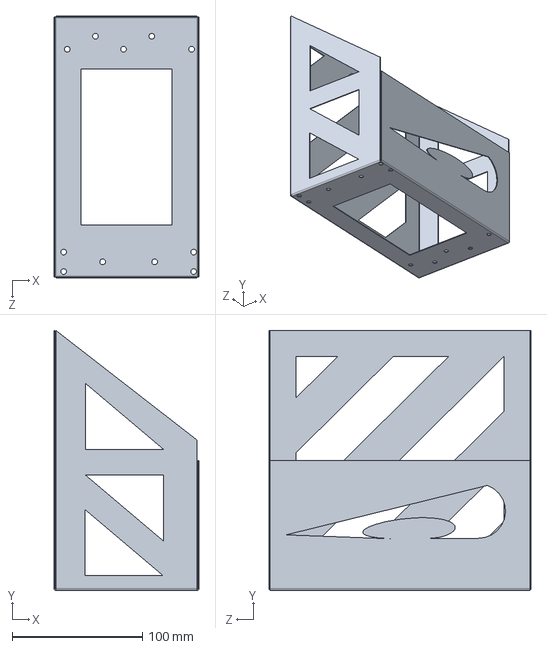
[picture p128: CAD file, 2015-08-13]
SolidWorks parts/PLAN B STUFF/Basket-Caution.SLDPRT
111.5 x 200.0 x 201.5 mm
