gzgreg/enph253-2015-team13/SolidWorks parts/wheels/wheel.SLDPRT

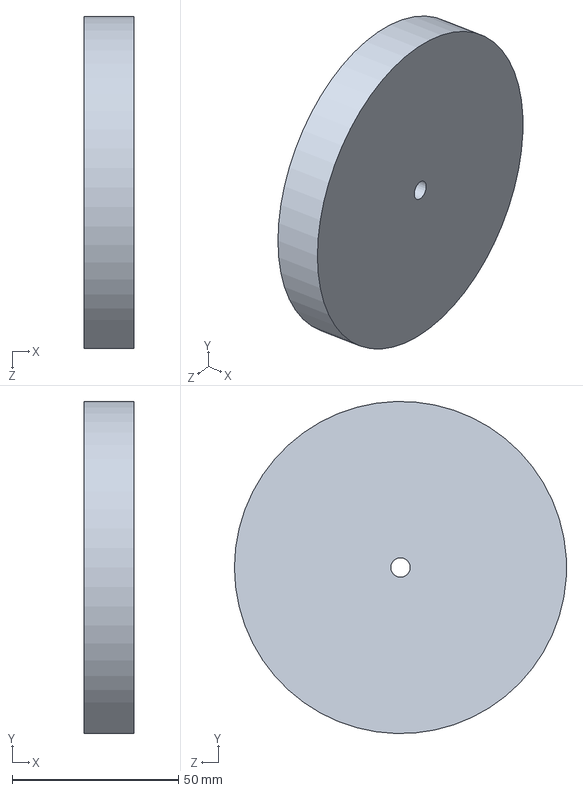
[picture p129: CAD file, 2015-06-25]
SolidWorks parts/wheels/wheel.SLDPRT
15.0 x 100.0 x 100.0 mm
