gzgreg/enph253-2015-team13/SolidWorks parts/Zip Line Mechanism/Outer Basket to Cut Rev 4.SLDPRT

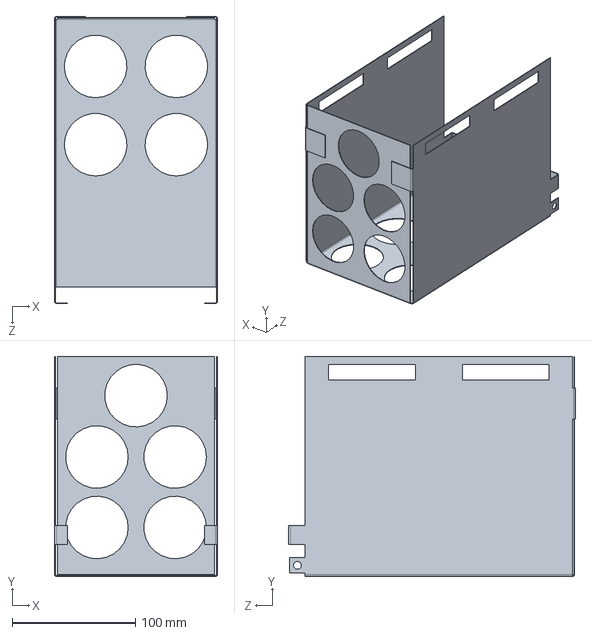
[picture p130: CAD file, 2015-08-01]
SolidWorks parts/Zip Line Mechanism/Outer Basket to Cut Rev 4.SLDPRT
132.4 x 178.5 x 233.1 mm
