gzgreg/enph253-2015-team13/Robot/SolidWorks Parts/8mmEndCap.SLDPRT

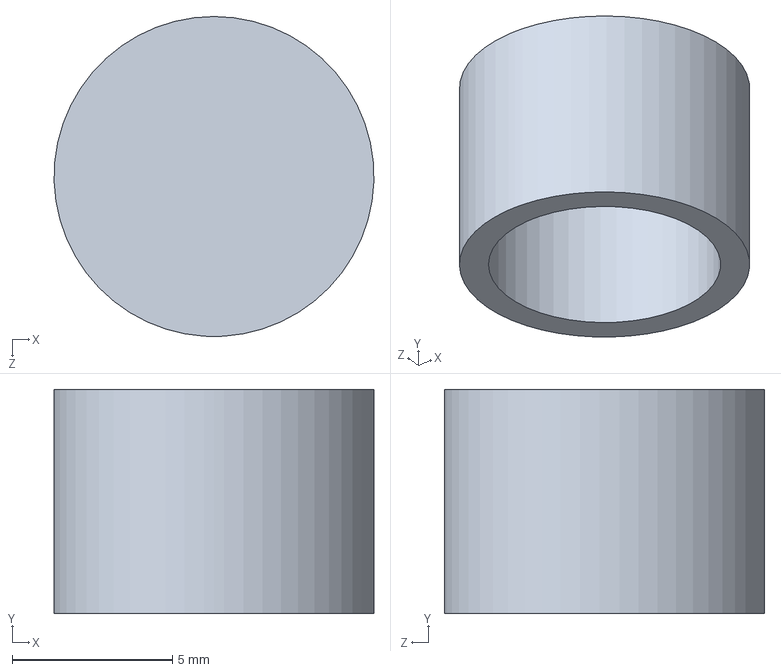
[picture p131: CAD file, 2015-06-03]
Robot/SolidWorks Parts/8mmEndCap.SLDPRT
10.00 x 7.00 x 10.0 mm
