gzgreg/enph253-2015-team13/Robot/SolidWorks Parts/Zipline Mechanism/Basket Attachment.SLDPRT

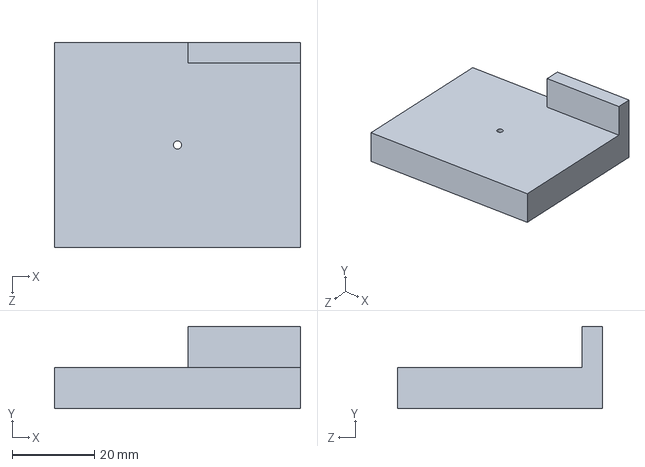
[picture p132: CAD file, 2015-06-15]
Robot/SolidWorks Parts/Zipline Mechanism/Basket Attachment.SLDPRT
60.0 x 20.0 x 50.0 mm
