gzgreg/enph253-2015-team13/SolidWorks parts/Al_pickup_mech.SLDPRT

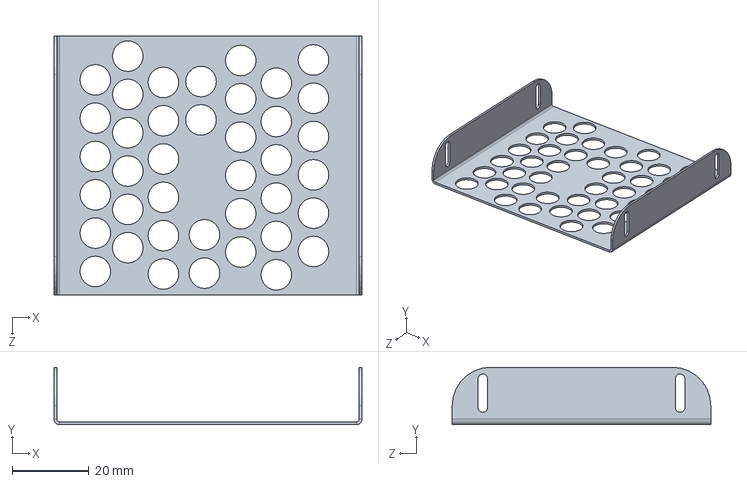
[picture p133: CAD file, 2015-08-04]
SolidWorks parts/Al_pickup_mech.SLDPRT
80.4 x 15.0 x 67.5 mm
