gzgreg/enph253-2015-team13/SolidWorks parts/ARM Design/amr_seg2_v3.SLDPRT

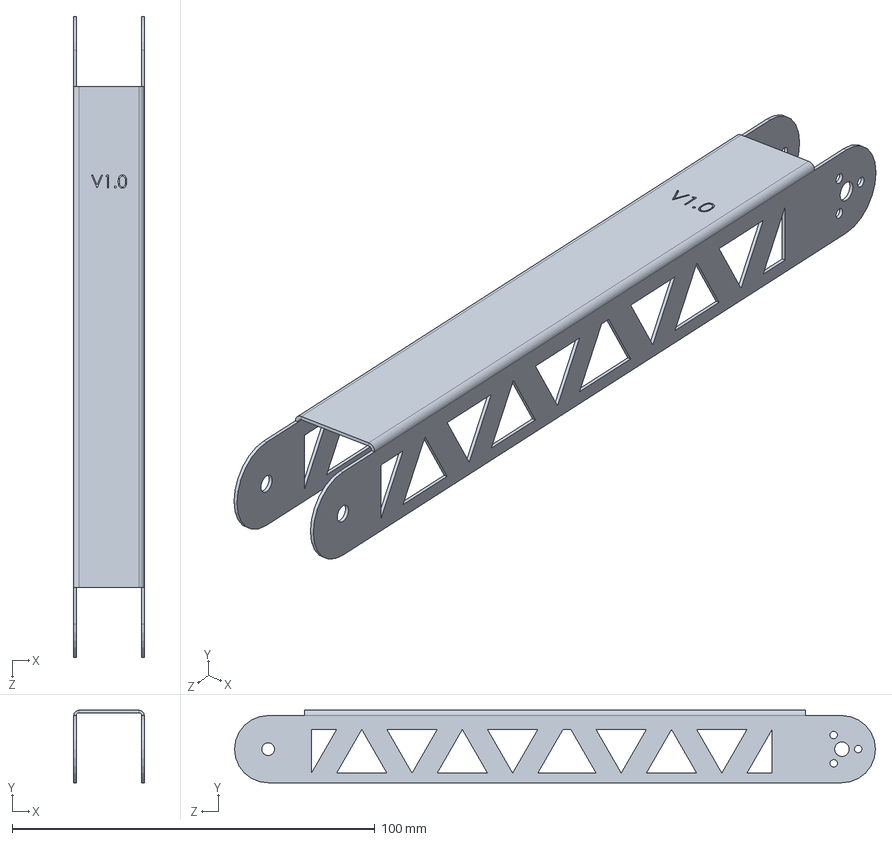
[picture p134: CAD file, 2015-08-01]
SolidWorks parts/ARM Design/amr_seg2_v3.SLDPRT
19.5 x 20.0 x 176.6 mm
