gzgreg/enph253-2015-team13/SolidWorks parts/ARM Design/Design 1/armSeg1_V1.0.SLDPRT

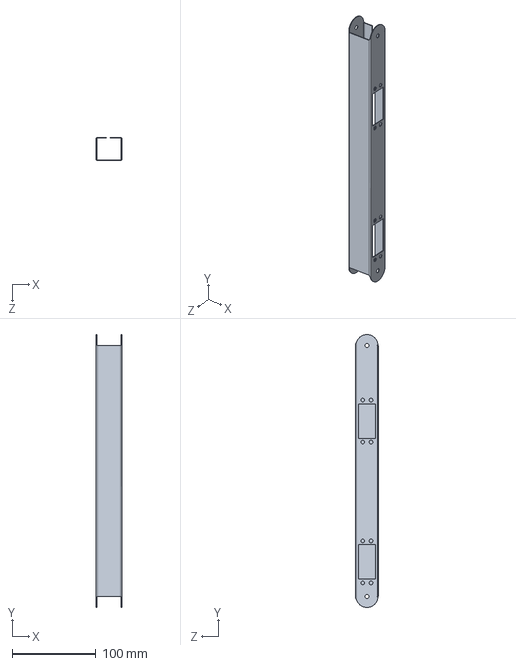
[picture p135: CAD file, 2015-06-17]
SolidWorks parts/ARM Design/Design 1/armSeg1_V1.0.SLDPRT
30.7 x 326.3 x 27.8 mm
