gzgreg/enph253-2015-team13/SolidWorks parts/ARM Design/Design 2/Arm_short_section_V2.0.SLDPRT

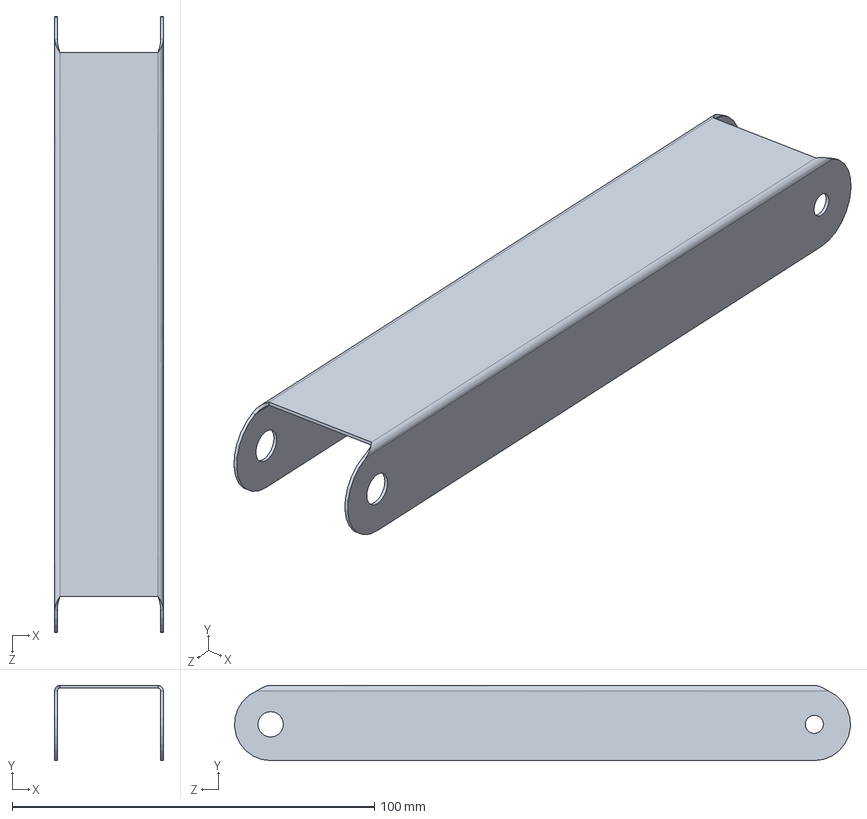
[picture p136: CAD file, 2015-06-18]
SolidWorks parts/ARM Design/Design 2/Arm_short_section_V2.0.SLDPRT
30.0 x 20.7 x 170.0 mm
