gzgreg/enph253-2015-team13/SolidWorks parts/ARM Design/Design 5/arm_segment_v3V4.0V5.0.SLDPRT

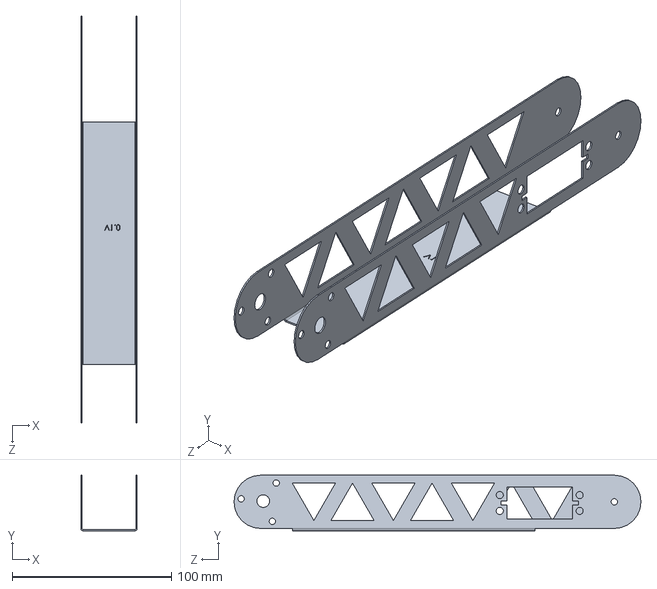
[picture p137: CAD file, 2015-08-13]
SolidWorks parts/ARM Design/Design 5/arm_segment_v3V4.0V5.0.SLDPRT
35.5 x 35.0 x 255.9 mm
