gzgreg/enph253-2015-team13/SolidWorks parts/Arm Release/Al Plate Rev 1.SLDPRT

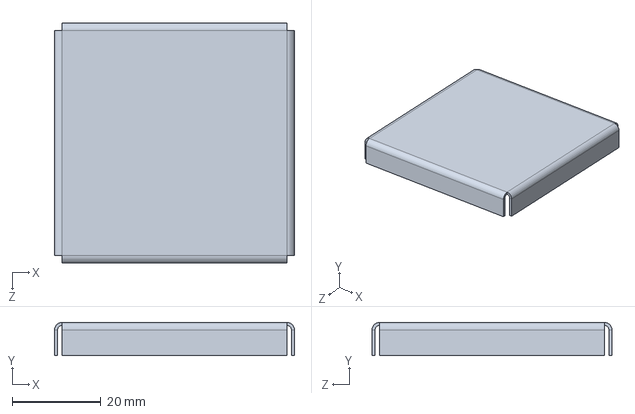
[picture p138: CAD file, 2015-07-10]
SolidWorks parts/Arm Release/Al Plate Rev 1.SLDPRT
54.2 x 7.50 x 54.2 mm
