gzgreg/enph253-2015-team13/SolidWorks parts/Basket Lift Mechanism - R-Dawg Version 2.0/FixedArmPinJoint-WithSlidePoleMounts.SLDPRT

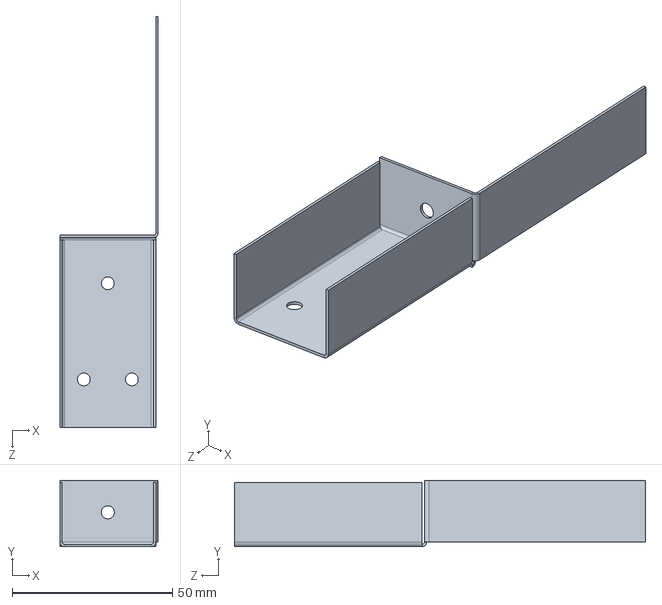
[picture p139: CAD file, 2015-07-22]
SolidWorks parts/Basket Lift Mechanism - R-Dawg Version 2.0/FixedArmPinJoint-WithSlidePoleMounts.SLDPRT
30.7 x 20.7 x 128.3 mm
