gzgreg/enph253-2015-team13/SolidWorks parts/Basket Lift Mechanism - Version 1/SlideArmSlidePole.SLDPRT

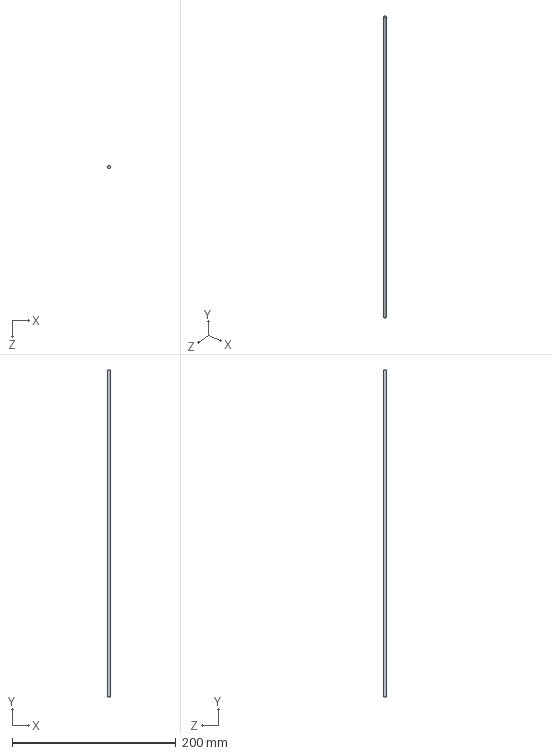
[picture p140: CAD file, 2015-07-16]
SolidWorks parts/Basket Lift Mechanism - Version 1/SlideArmSlidePole.SLDPRT
4.00 x 400.0 x 4.00 mm
