gzgreg/enph253-2015-team13/SolidWorks parts/Basket Lift/linkage bracket.SLDPRT

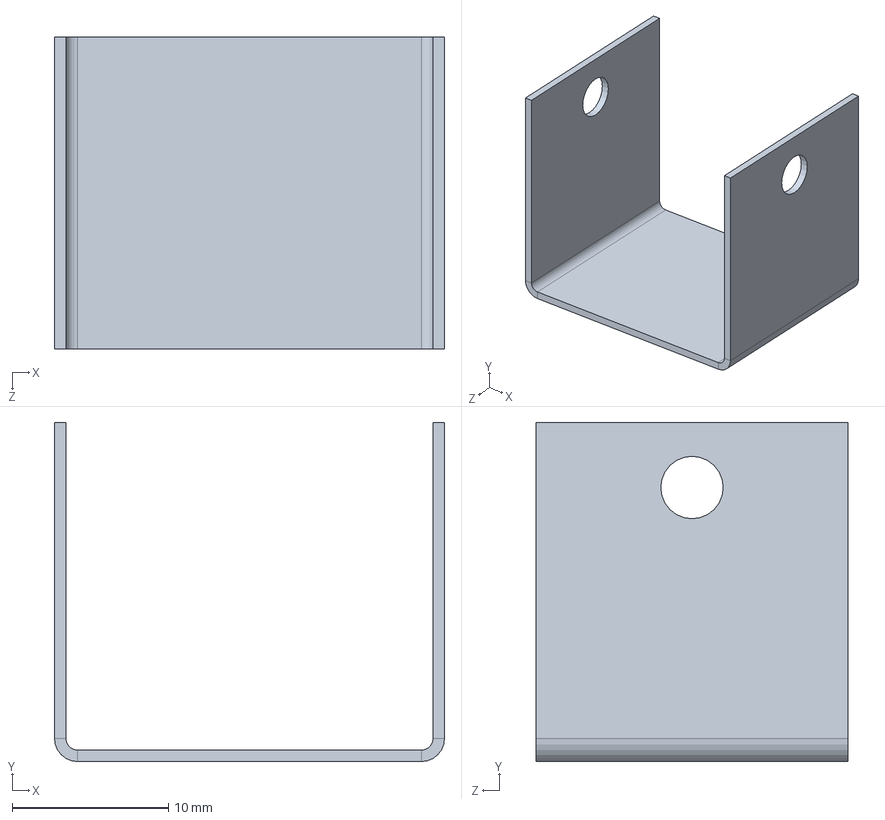
[picture p141: CAD file, 2015-06-15]
SolidWorks parts/Basket Lift/linkage bracket.SLDPRT
25.0 x 21.7 x 20.0 mm
