gzgreg/enph253-2015-team13/SolidWorks parts/Catapult Basket/Inner Basket - Catapult to Cut Rev 2.SLDPRT

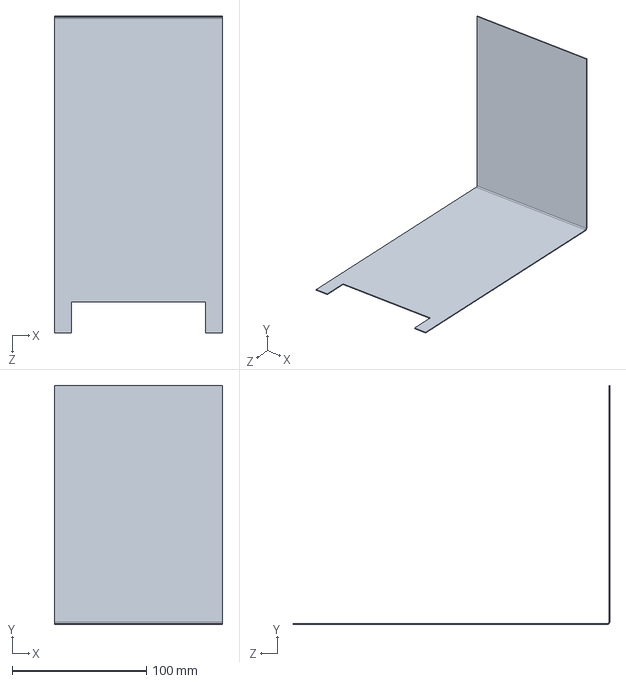
[picture p142: CAD file, 2015-07-14]
SolidWorks parts/Catapult Basket/Inner Basket - Catapult to Cut Rev 2.SLDPRT
125.0 x 177.8 x 235.5 mm
