gzgreg/enph253-2015-team13/SolidWorks parts/Servo futaba/Servo Futaba S3003.SLDPRT

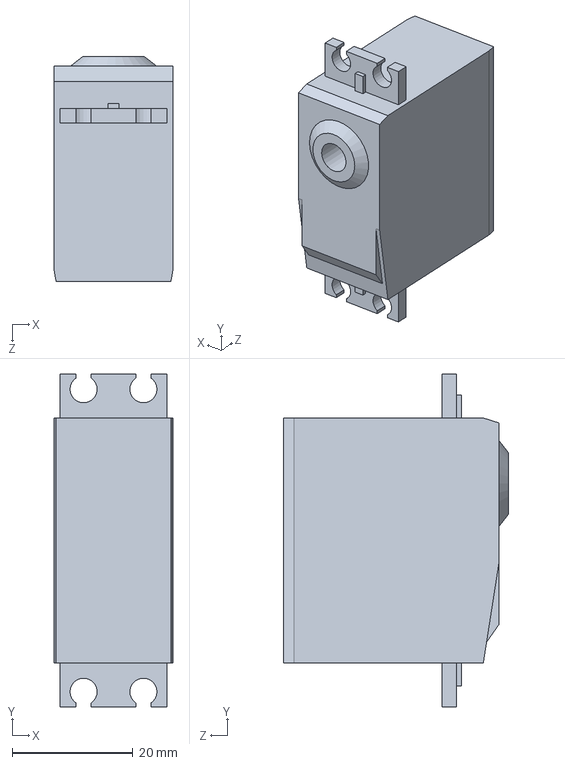
[picture p143: CAD file, 2015-07-08]
SolidWorks parts/Servo futaba/Servo Futaba S3003.SLDPRT
19.7 x 55.3 x 37.4 mm
