gzgreg/enph253-2015-team13/SolidWorks parts/wheels/wheel hub.SLDPRT

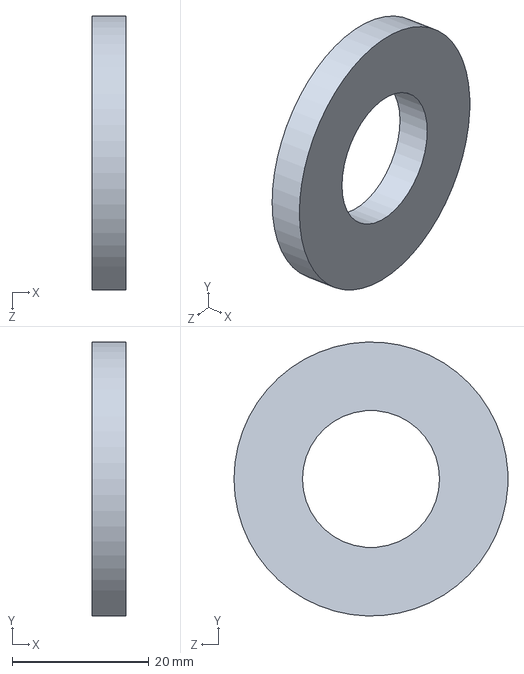
[picture p144: CAD file, 2015-06-24]
SolidWorks parts/wheels/wheel hub.SLDPRT
5.00 x 40.0 x 40.0 mm
