gzgreg/enph253-2015-team13/SolidWorks parts/Zipline Catcher/Ball Bearing Spacer.SLDPRT

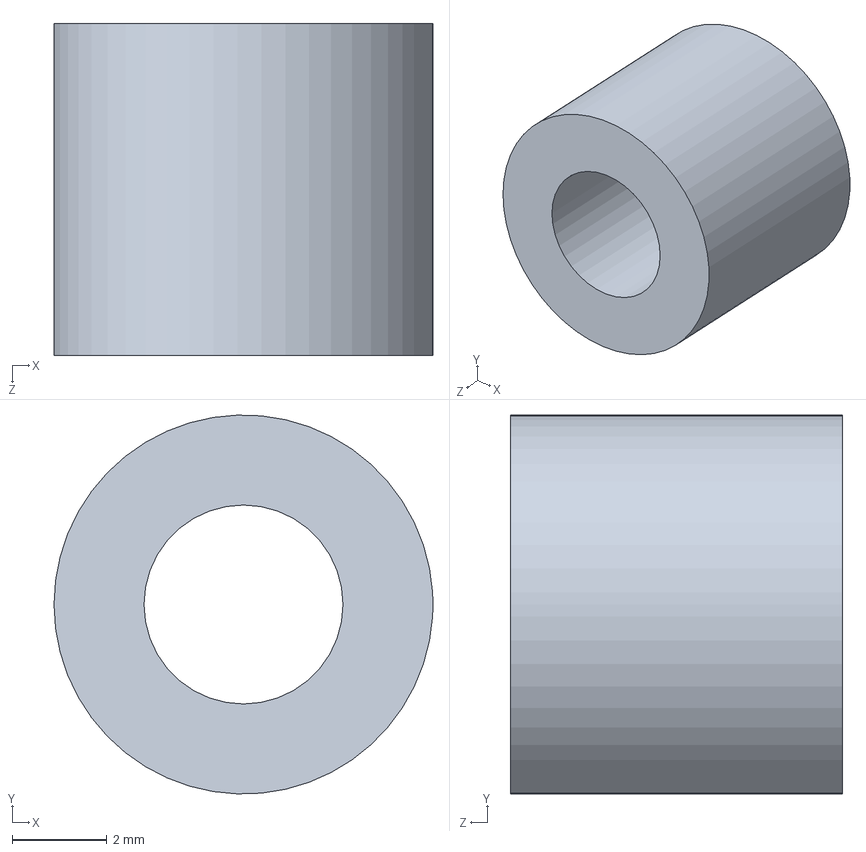
[picture p145: CAD file, 2015-07-23]
SolidWorks parts/Zipline Catcher/Ball Bearing Spacer.SLDPRT
8.00 x 8.00 x 7.00 mm
