gzgreg/enph253-2015-team13/Robot/SolidWorks Parts/4mmTube.SLDPRT

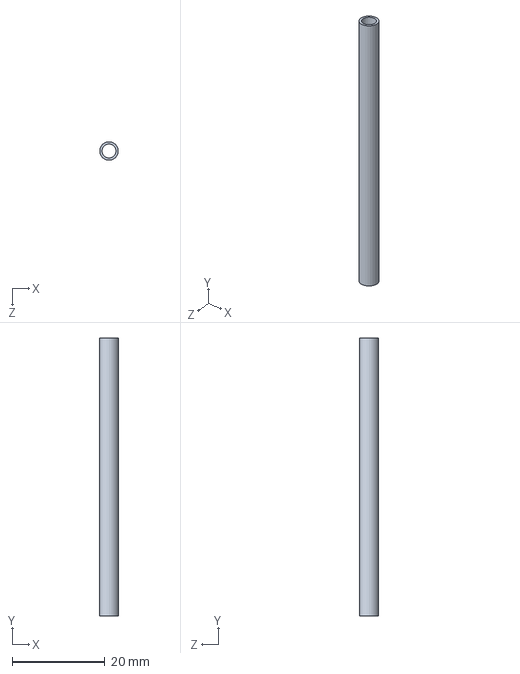
[picture p146: CAD file, 2015-06-03]
Robot/SolidWorks Parts/4mmTube.SLDPRT
4.00 x 60.0 x 4.00 mm
