gzgreg/enph253-2015-team13/Robot/SolidWorks Parts/Zipline Mechanism/Bearing Rod.SLDPRT

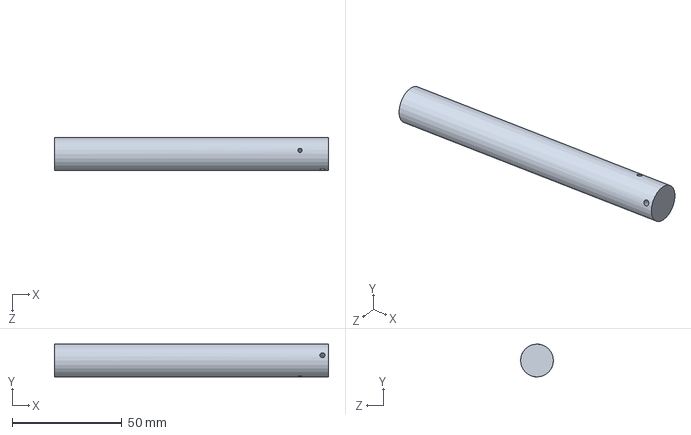
[picture p147: CAD file, 2015-06-15]
Robot/SolidWorks Parts/Zipline Mechanism/Bearing Rod.SLDPRT
125.0 x 15.0 x 15.0 mm
