gzgreg/enph253-2015-team13/SolidWorks parts/ARM Design/Design 1/armSeg2_V1.0.SLDPRT

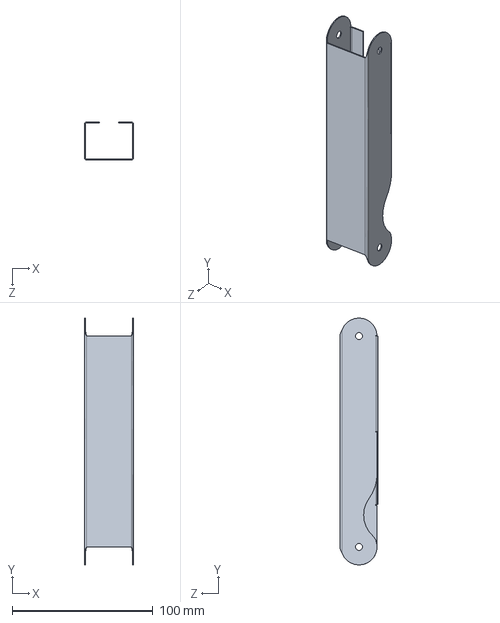
[picture p148: CAD file, 2015-06-15]
SolidWorks parts/ARM Design/Design 1/armSeg2_V1.0.SLDPRT
34.7 x 175.7 x 27.2 mm
