gzgreg/enph253-2015-team13/SolidWorks parts/ARM Design/Design 2/long_arm_side_beam.SLDPRT

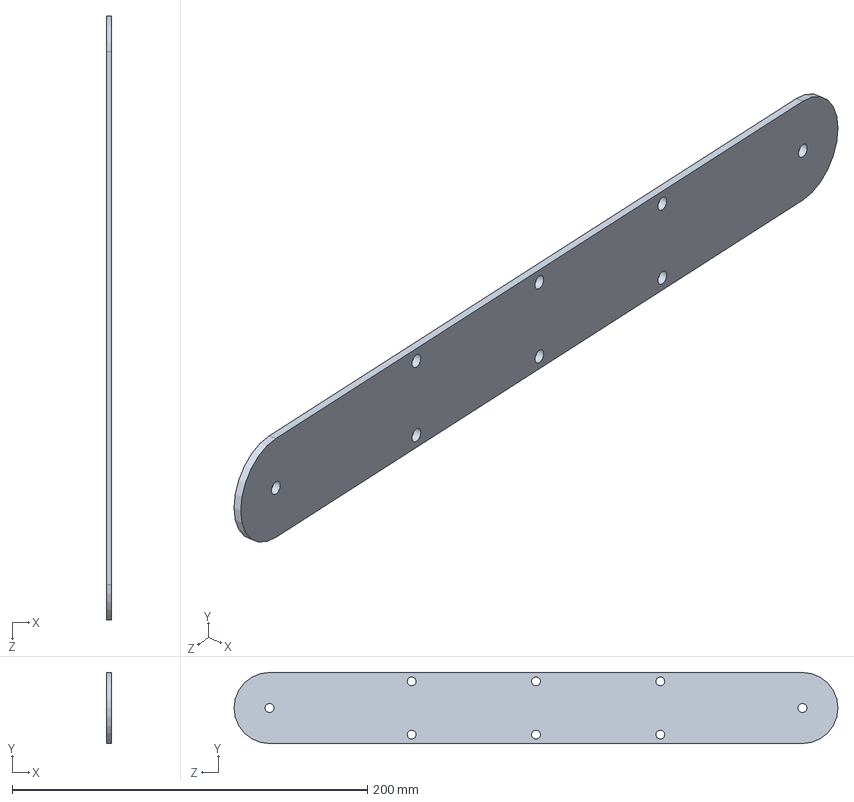
[picture p149: CAD file, 2015-06-18]
SolidWorks parts/ARM Design/Design 2/long_arm_side_beam.SLDPRT
3.00 x 40.0 x 340.0 mm
