gzgreg/enph253-2015-team13/SolidWorks parts/ARM Design/Design 5/new motor flangeV5.0.SLDPRT

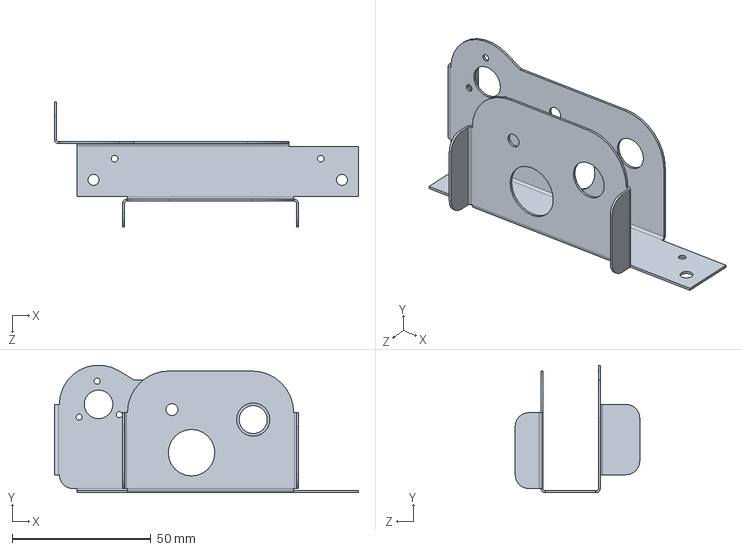
[picture p150: CAD file, 2015-08-13]
SolidWorks parts/ARM Design/Design 5/new motor flangeV5.0.SLDPRT
109.7 x 46.0 x 45.0 mm
