gzgreg/enph253-2015-team13/SolidWorks parts/Basket Lift Mechanism - R-Dawg Version 2.0/SweetArmSpacer.SLDPRT

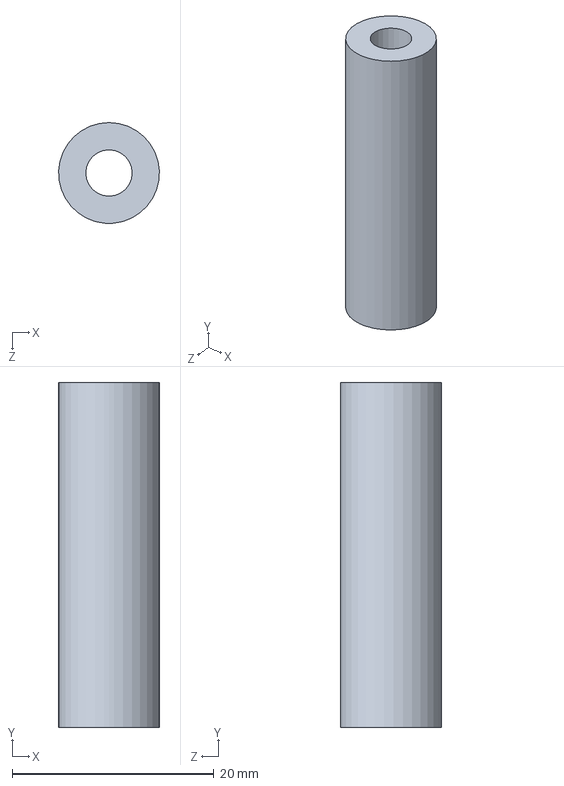
[picture p151: CAD file, 2015-07-22]
SolidWorks parts/Basket Lift Mechanism - R-Dawg Version 2.0/SweetArmSpacer.SLDPRT
9.99 x 34.2 x 10.0 mm
