gzgreg/enph253-2015-team13/SolidWorks parts/Basket Lift Mechanism - Version 1/PinJoint.SLDPRT

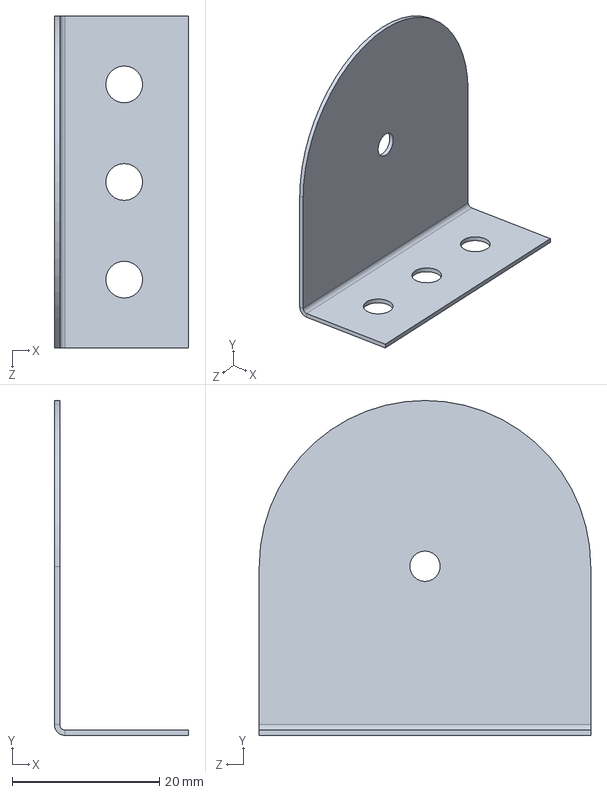
[picture p152: CAD file, 2015-07-16]
SolidWorks parts/Basket Lift Mechanism - Version 1/PinJoint.SLDPRT
18.2 x 45.5 x 45.0 mm
