gzgreg/enph253-2015-team13/SolidWorks parts/Bumper/CrudeMicroSwitch.SLDPRT

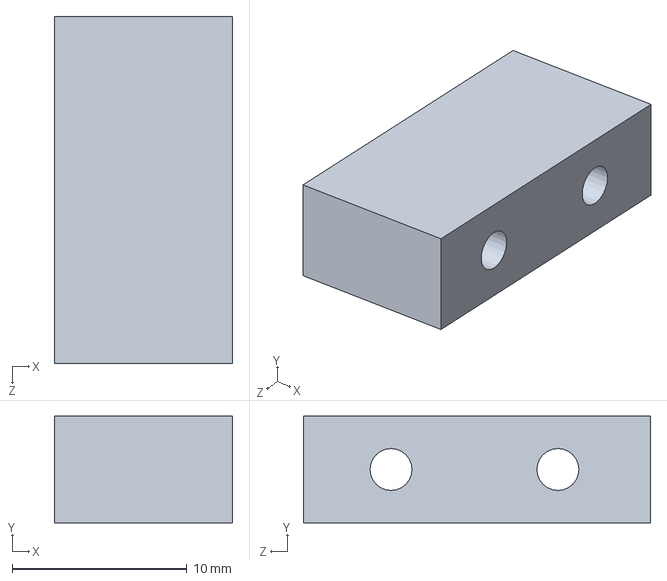
[picture p153: CAD file, 2015-08-13]
SolidWorks parts/Bumper/CrudeMicroSwitch.SLDPRT
10.2 x 6.10 x 19.9 mm
