gzgreg/enph253-2015-team13/SolidWorks parts/Catapult Basket/Inner Basket - Sloped Angle to Cut Rev 2.SLDPRT

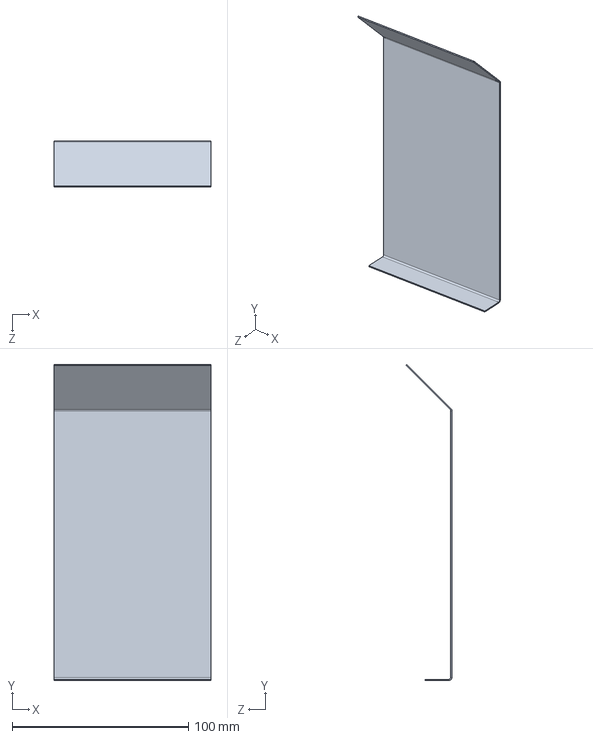
[picture p154: CAD file, 2015-07-14]
SolidWorks parts/Catapult Basket/Inner Basket - Sloped Angle to Cut Rev 2.SLDPRT
88.9 x 179.4 x 26.1 mm
