gzgreg/enph253-2015-team13/SolidWorks parts/james' zipline/Part4.SLDPRT

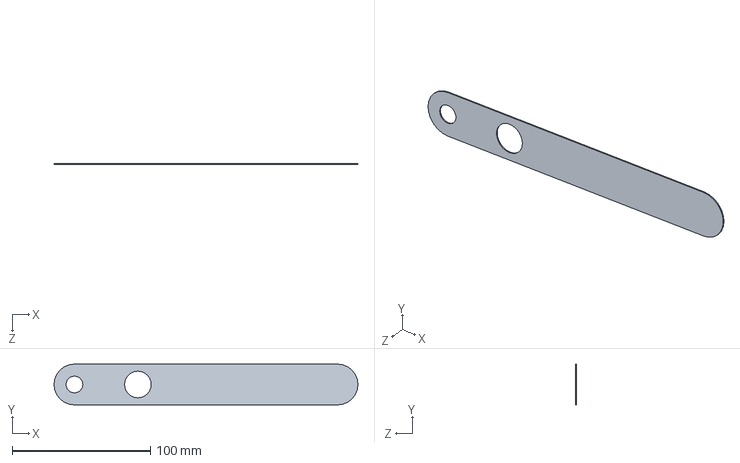
[picture p155: CAD file, 2015-07-04]
SolidWorks parts/james' zipline/Part4.SLDPRT
220.2 x 29.6 x 0.737 mm
