gzgreg/enph253-2015-team13/SolidWorks parts/Zip Line Mechanism/DrivingMotorTemplate.SLDPRT

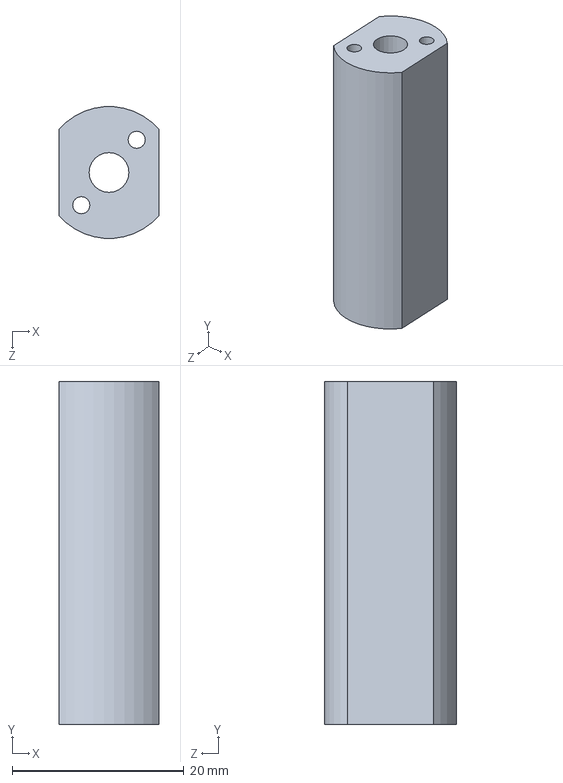
[picture p156: CAD file, 2015-08-01]
SolidWorks parts/Zip Line Mechanism/DrivingMotorTemplate.SLDPRT
11.7 x 40.0 x 15.3 mm
