gzgreg/enph253-2015-team13/SolidWorks parts/Zipline Catcher/Basket Attachment Rev 2.SLDPRT

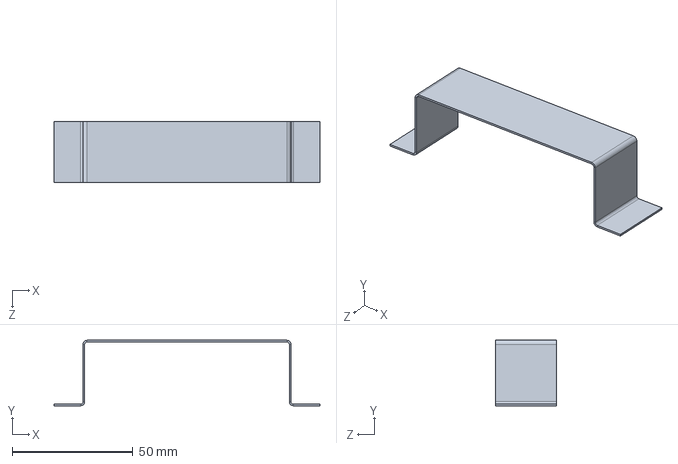
[picture p157: CAD file, 2015-07-23]
SolidWorks parts/Zipline Catcher/Basket Attachment Rev 2.SLDPRT
109.9 x 27.1 x 25.4 mm
