gzgreg/enph253-2015-team13/Robot/SolidWorks Parts/8mmTube.SLDPRT

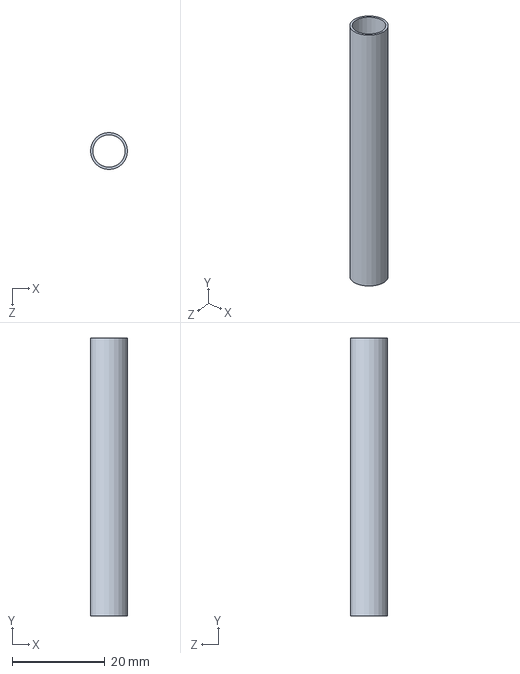
[picture p158: CAD file, 2015-06-03]
Robot/SolidWorks Parts/8mmTube.SLDPRT
8.00 x 60.0 x 8.00 mm
