gzgreg/enph253-2015-team13/Robot/SolidWorks Parts/Zipline Mechanism/Bearing Rod Holder.SLDPRT

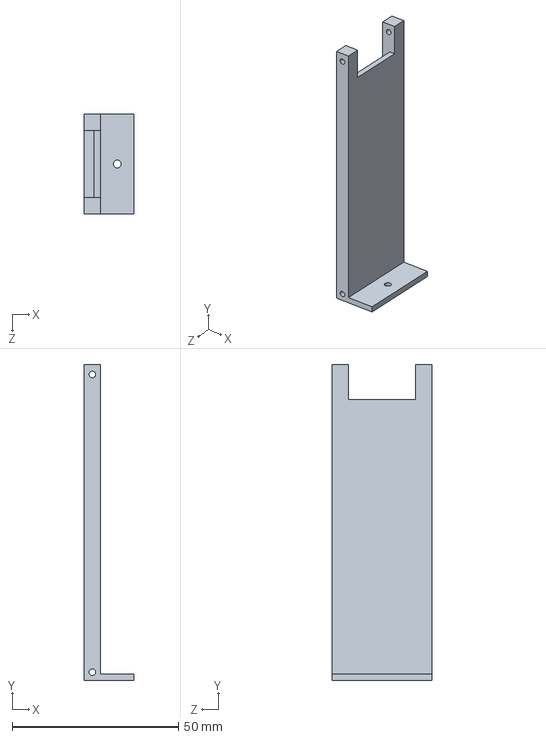
[picture p159: CAD file, 2015-06-15]
Robot/SolidWorks Parts/Zipline Mechanism/Bearing Rod Holder.SLDPRT
15.0 x 95.0 x 30.0 mm
