gzgreg/enph253-2015-team13/SolidWorks parts/ARM Design/Design 1/Armbracket.SLDPRT

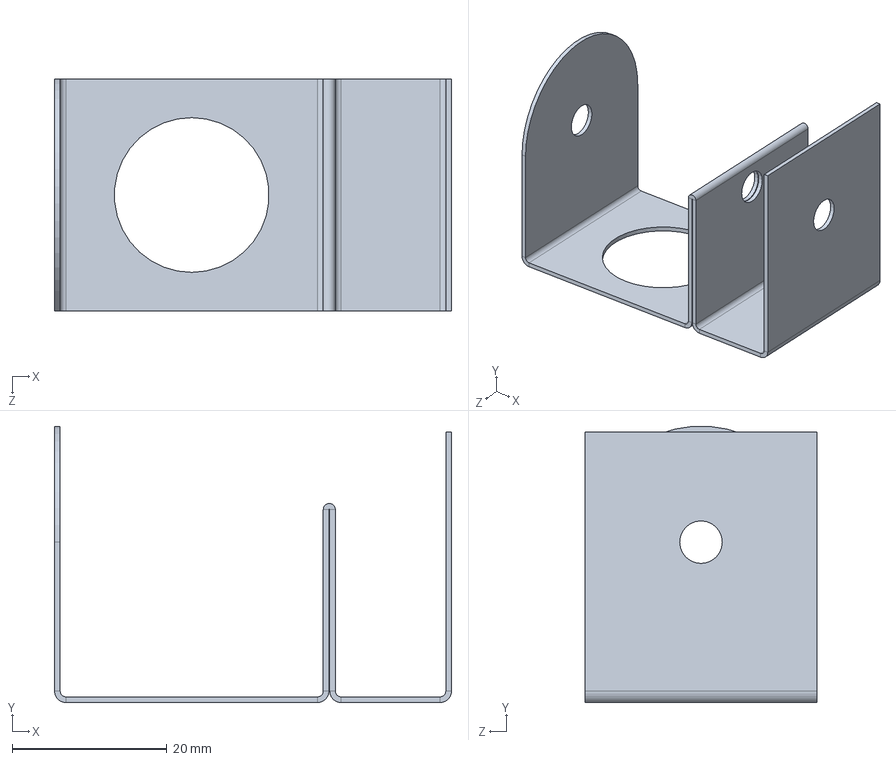
[picture p160: CAD file, 2015-06-10]
SolidWorks parts/ARM Design/Design 1/Armbracket.SLDPRT
51.3 x 35.7 x 30.0 mm
