gzgreg/enph253-2015-team13/SolidWorks parts/ARM Design/Design 2/ArmBracket_V2.1.SLDPRT

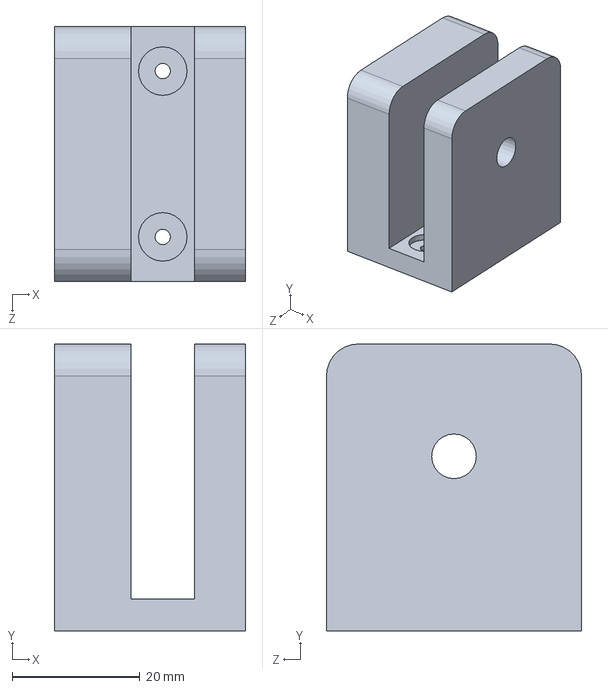
[picture p161: CAD file, 2015-06-18]
SolidWorks parts/ARM Design/Design 2/ArmBracket_V2.1.SLDPRT
30.0 x 45.0 x 40.0 mm
