gzgreg/enph253-2015-team13/SolidWorks parts/ARM Design/Design 5/Arm base Flange with motor mountV4.0V5.0.SLDPRT

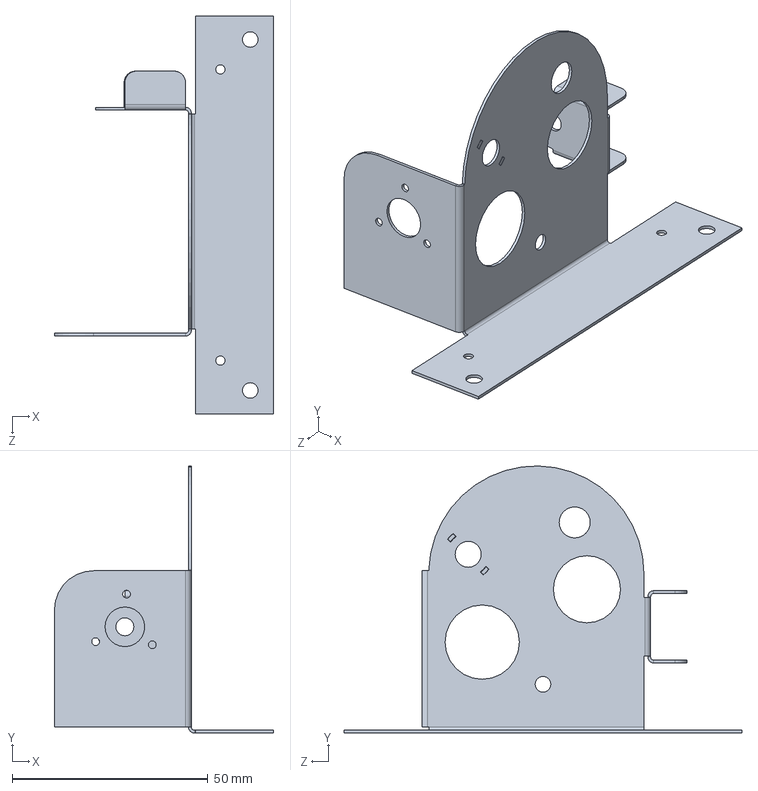
[picture p162: CAD file, 2015-08-13]
SolidWorks parts/ARM Design/Design 5/Arm base Flange with motor mountV4.0V5.0.SLDPRT
56.0 x 68.2 x 101.6 mm
