gzgreg/enph253-2015-team13/SolidWorks parts/Basket Lift Mechanism - R-Dawg Version 2.0/BasketHoldSpacer.SLDPRT

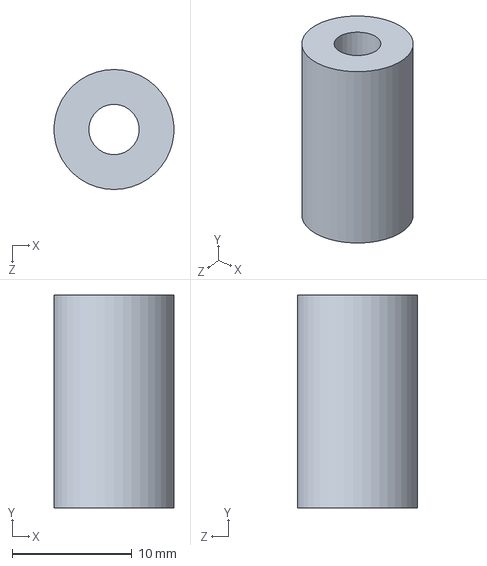
[picture p163: CAD file, 2015-07-22]
SolidWorks parts/Basket Lift Mechanism - R-Dawg Version 2.0/BasketHoldSpacer.SLDPRT
9.97 x 17.8 x 10.0 mm
