gzgreg/enph253-2015-team13/SolidWorks parts/Basket Lift Mechanism - Version 1/DrivenArmBasePinJoint.SLDPRT

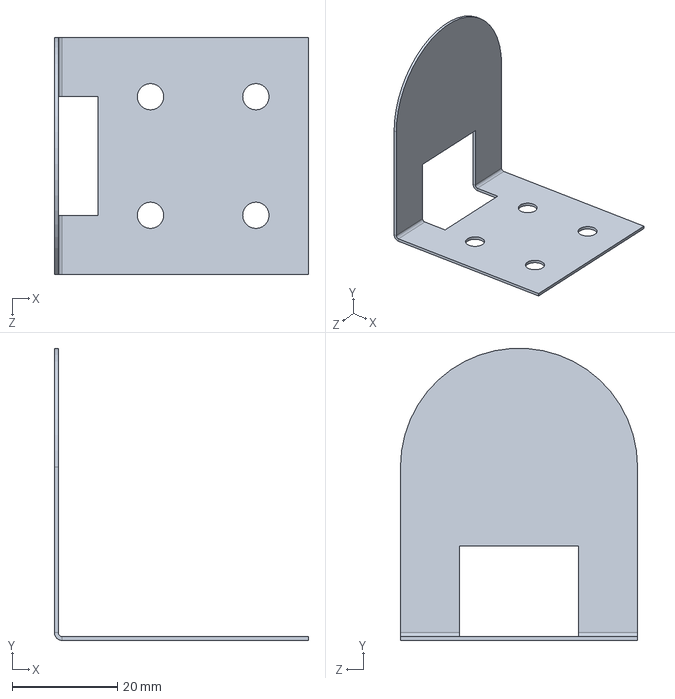
[picture p164: CAD file, 2015-07-16]
SolidWorks parts/Basket Lift Mechanism - Version 1/DrivenArmBasePinJoint.SLDPRT
48.2 x 55.4 x 45.0 mm
