gzgreg/enph253-2015-team13/SolidWorks parts/Basket Lift/Linkage long part.SLDPRT

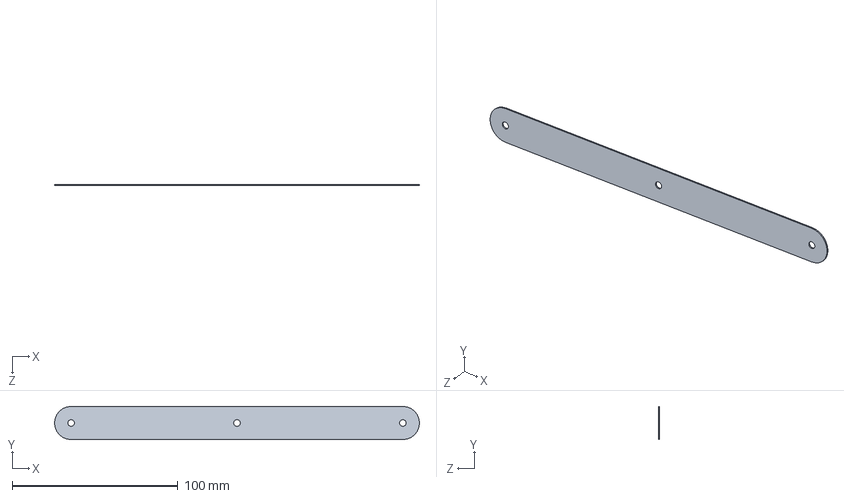
[picture p165: CAD file, 2015-06-15]
SolidWorks parts/Basket Lift/Linkage long part.SLDPRT
220.0 x 20.0 x 0.737 mm
