gzgreg/enph253-2015-team13/SolidWorks parts/Micro Switch Button.SLDPRT

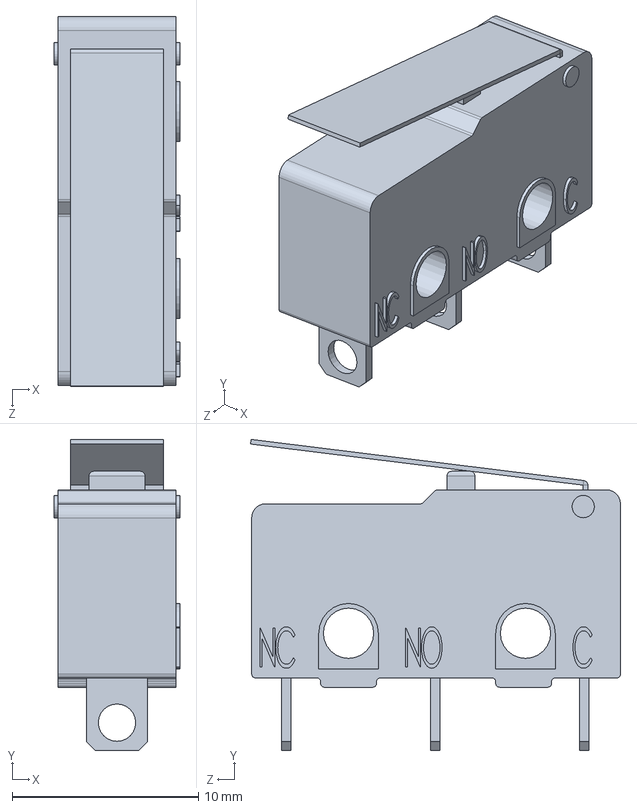
[picture p166: CAD file, 2015-08-02]
SolidWorks parts/Micro Switch Button.SLDPRT
6.75 x 16.7 x 19.9 mm
