gzgreg/enph253-2015-team13/SolidWorks parts/Motor-wheel_module/6-tooth-sprocket.SLDPRT

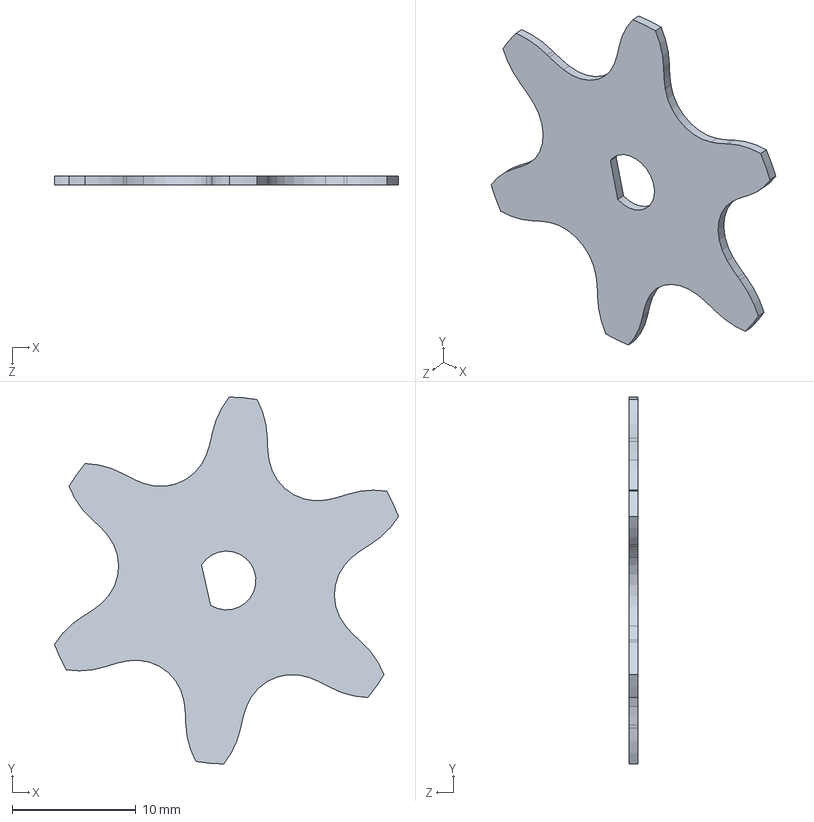
[picture p167: CAD file, 2015-07-13]
SolidWorks parts/Motor-wheel_module/6-tooth-sprocket.SLDPRT
27.8 x 29.6 x 0.737 mm
