gzgreg/enph253-2015-team13/SolidWorks parts/Zip Line Mechanism/DrivenShaft.SLDPRT

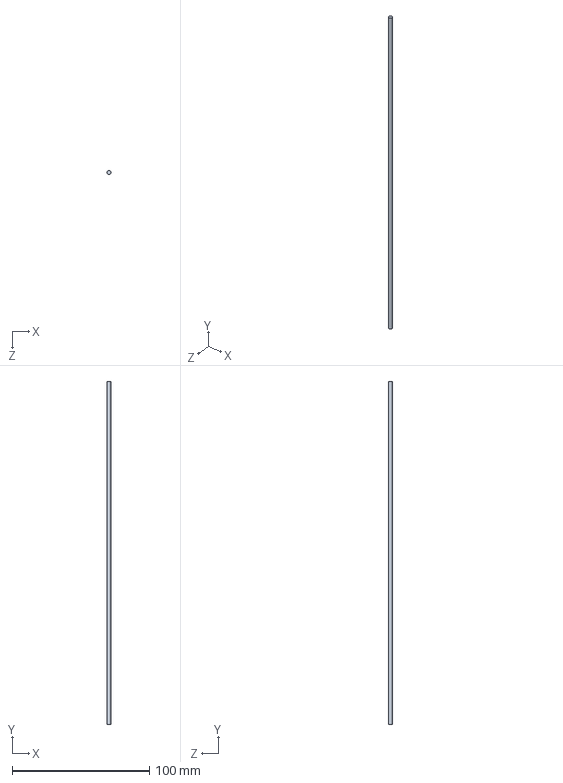
[picture p169: CAD file, 2015-08-01]
SolidWorks parts/Zip Line Mechanism/DrivenShaft.SLDPRT
3.15 x 250.0 x 3.15 mm
