gzgreg/enph253-2015-team13/Robot/SolidWorks Parts/Seal.SLDPRT

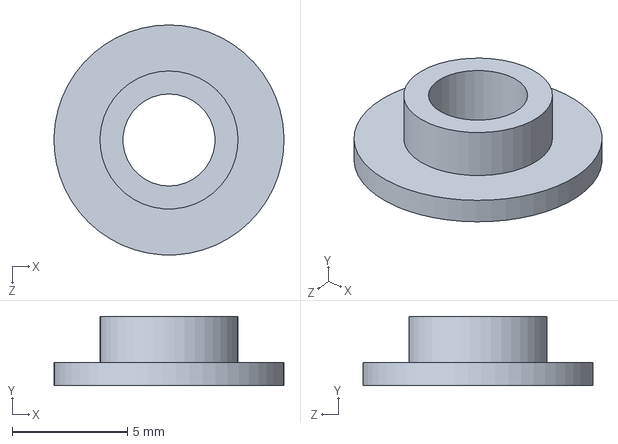
[picture p170: CAD file, 2015-06-03]
Robot/SolidWorks Parts/Seal.SLDPRT
10.00 x 3.00 x 10.0 mm
