gzgreg/enph253-2015-team13/Robot/SolidWorks Parts/Zipline Mechanism/Pin.SLDPRT

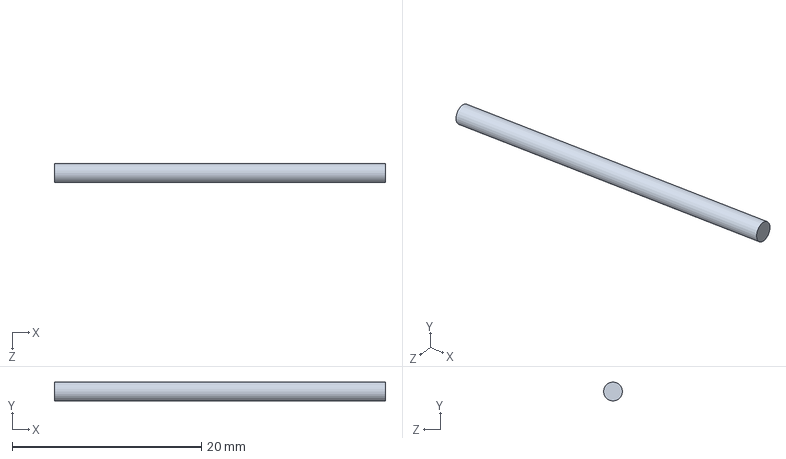
[picture p171: CAD file, 2015-06-15]
Robot/SolidWorks Parts/Zipline Mechanism/Pin.SLDPRT
35.0 x 2.00 x 2.00 mm
