gzgreg/enph253-2015-team13/SolidWorks parts/ARM Design/Design 2/Arm_bracket_V2.0.SLDPRT

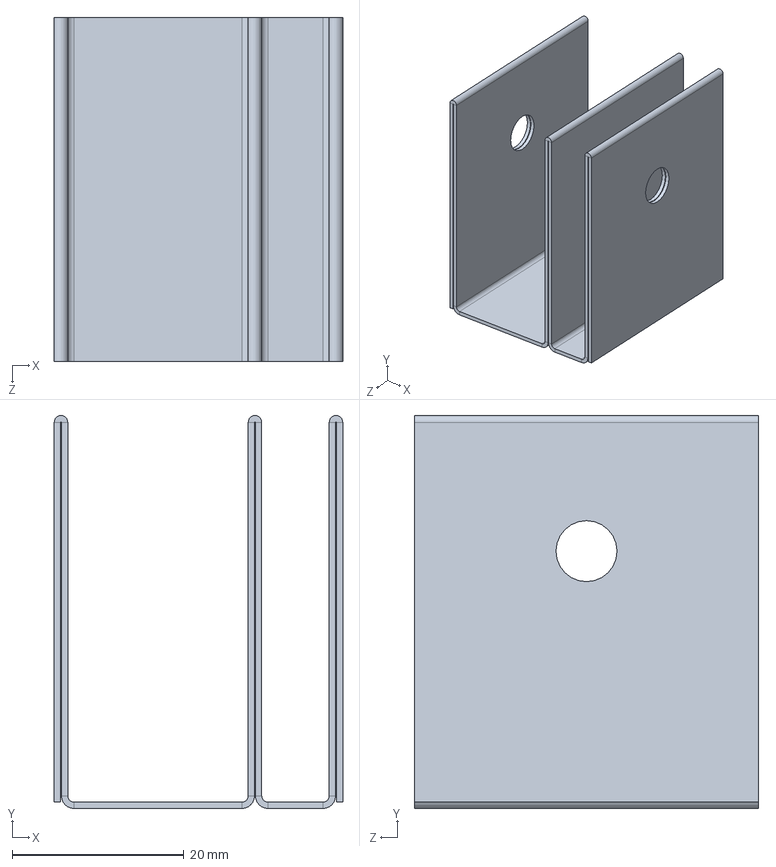
[picture p172: CAD file, 2015-06-17]
SolidWorks parts/ARM Design/Design 2/Arm_bracket_V2.0.SLDPRT
33.6 x 45.7 x 40.0 mm
