gzgreg/enph253-2015-team13/SolidWorks parts/Basket Lift Mechanism - R-Dawg Version 2.0/SlidePoleMount.SLDPRT

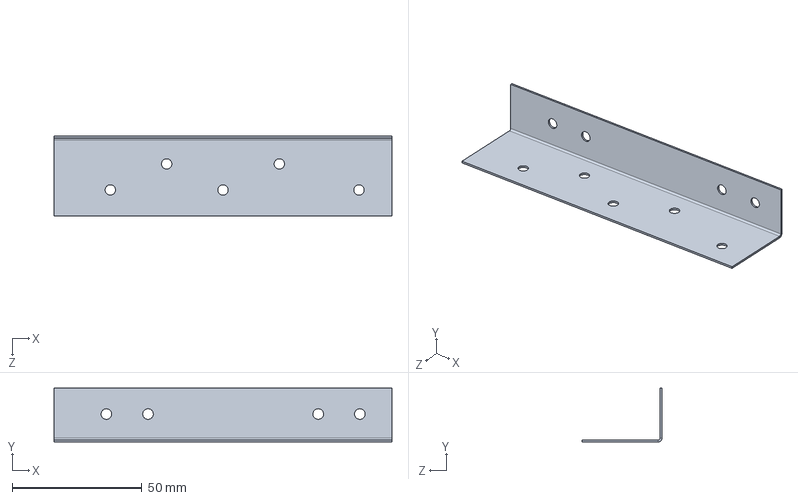
[picture p173: CAD file, 2015-07-22]
SolidWorks parts/Basket Lift Mechanism - R-Dawg Version 2.0/SlidePoleMount.SLDPRT
130.0 x 20.7 x 30.7 mm
