gzgreg/enph253-2015-team13/SolidWorks parts/Basket Lift/Linkage part.SLDPRT

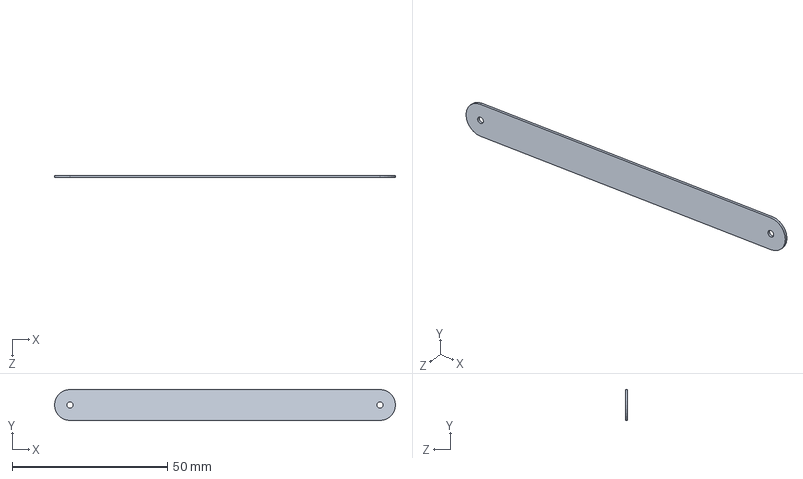
[picture p174: CAD file, 2015-06-15]
SolidWorks parts/Basket Lift/Linkage part.SLDPRT
110.0 x 10.0 x 0.737 mm
