gzgreg/enph253-2015-team13/SolidWorks parts/Bumper/MicroSwitchMount.SLDPRT

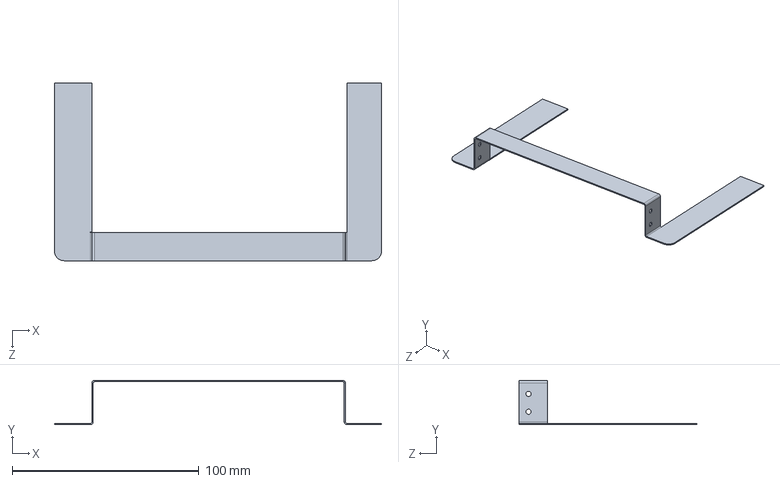
[picture p175: CAD file, 2015-08-01]
SolidWorks parts/Bumper/MicroSwitchMount.SLDPRT
175.0 x 23.7 x 95.0 mm
