gzgreg/enph253-2015-team13/SolidWorks parts/Motor-wheel_module/9 -tooth-sprocket.SLDPRT

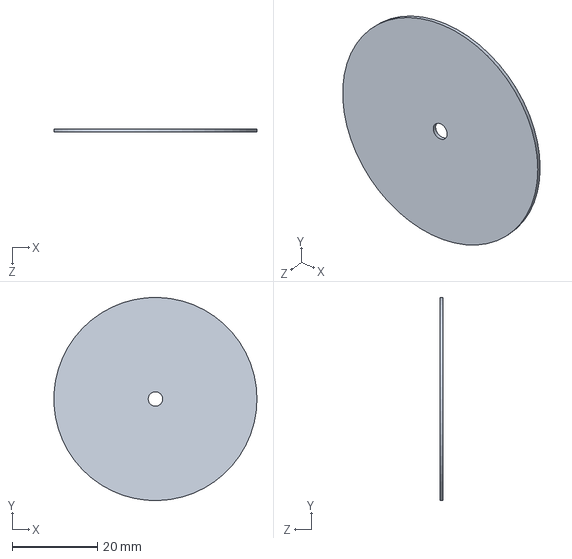
[picture p176: CAD file, 2015-07-04]
SolidWorks parts/Motor-wheel_module/9 -tooth-sprocket.SLDPRT
47.6 x 47.6 x 0.737 mm
