gzgreg/enph253-2015-team13/SolidWorks parts/SG90 ARM.SLDPRT

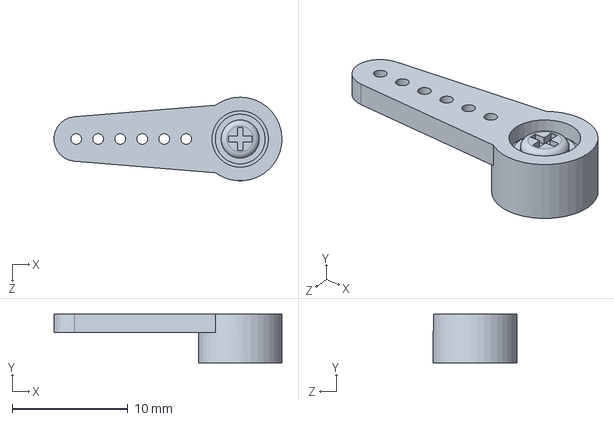
[picture p177: CAD file, 2015-08-02]
SolidWorks parts/SG90 ARM.SLDPRT
19.7 x 4.23 x 7.24 mm
