gzgreg/enph253-2015-team13/SolidWorks parts/Zipline Catcher/Zipline Roller Rev 5.2.SLDPRT

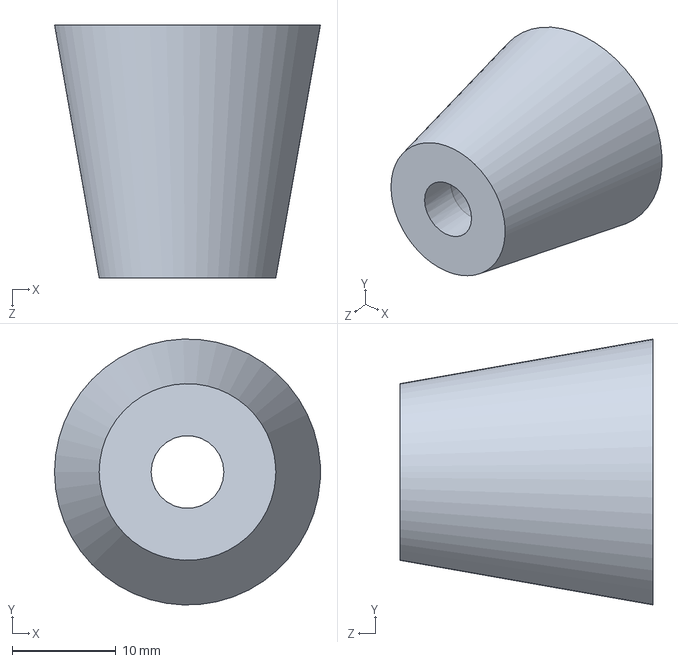
[picture p178: CAD file, 2015-07-23]
SolidWorks parts/Zipline Catcher/Zipline Roller Rev 5.2.SLDPRT
25.6 x 25.6 x 24.4 mm
