gzgreg/enph253-2015-team13/Robot/SolidWorks Parts/Launch Bottom.SLDPRT

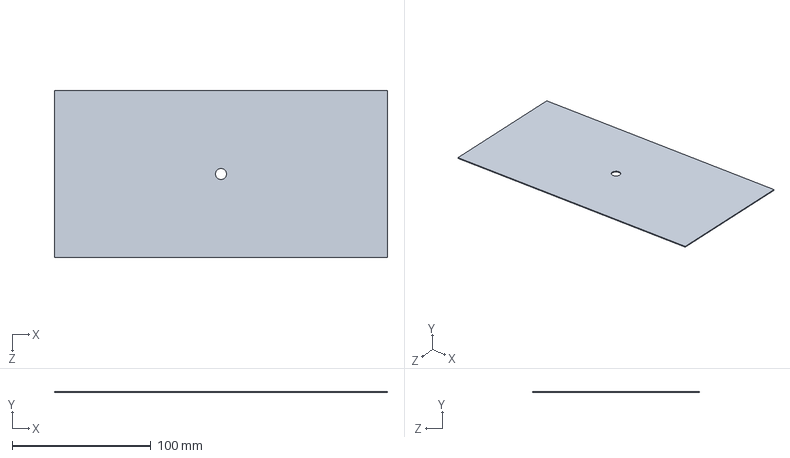
[picture p179: CAD file, 2015-06-03]
Robot/SolidWorks Parts/Launch Bottom.SLDPRT
240.0 x 0.737 x 120.0 mm
