gzgreg/enph253-2015-team13/SolidWorks parts/ARM Design/arm_encoder_gear.SLDPRT

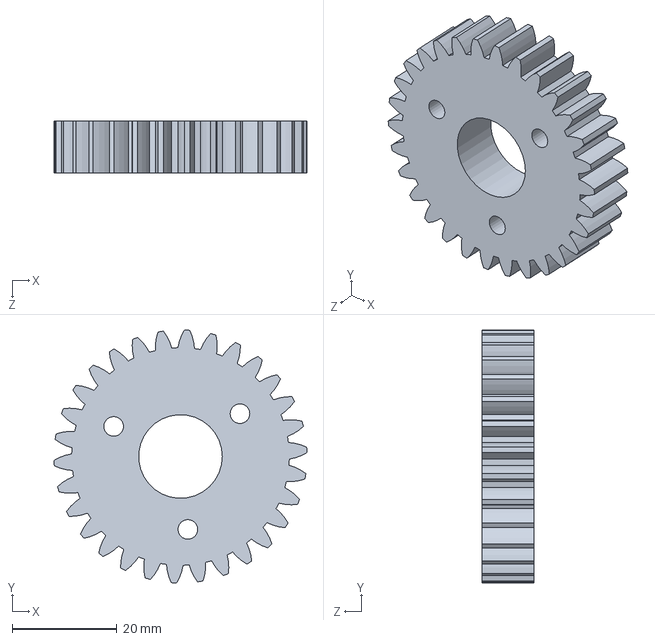
[picture p180: CAD file, 2015-07-30]
SolidWorks parts/ARM Design/arm_encoder_gear.SLDPRT
48.2 x 48.2 x 10.0 mm
