gzgreg/enph253-2015-team13/SolidWorks parts/Basket Lift Mechanism - R-Dawg Version 2.0/BasketHolder.SLDPRT

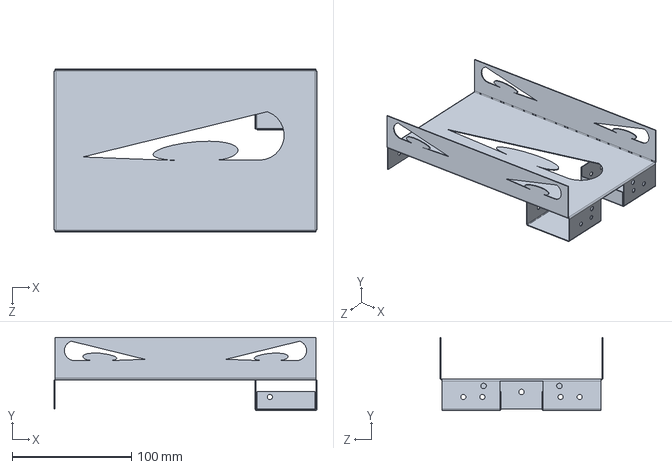
[picture p181: CAD file, 2015-07-22]
SolidWorks parts/Basket Lift Mechanism - R-Dawg Version 2.0/BasketHolder.SLDPRT
220.5 x 61.5 x 136.5 mm
