gzgreg/enph253-2015-team13/SolidWorks parts/Basket Lift/4mmShaft.SLDPRT

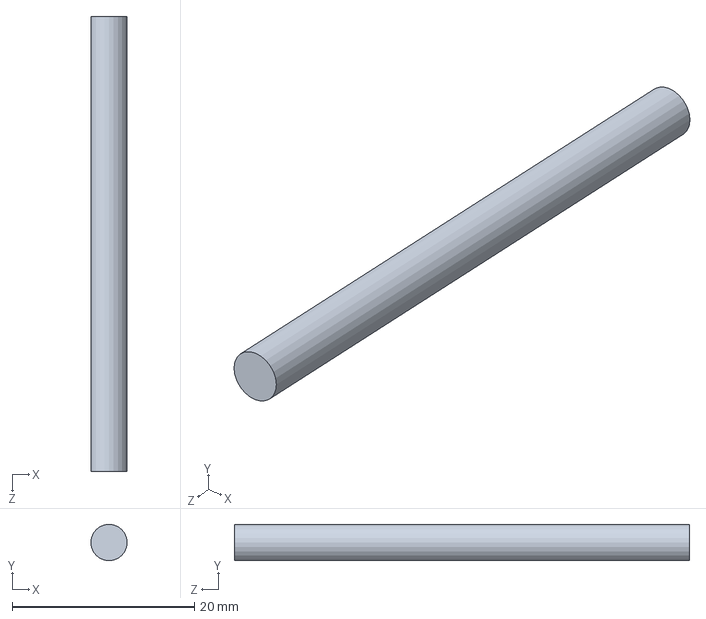
[picture p182: CAD file, 2015-06-15]
SolidWorks parts/Basket Lift/4mmShaft.SLDPRT
4.00 x 4.00 x 50.0 mm
