gzgreg/enph253-2015-team13/SolidWorks parts/SG90 BODY.SLDPRT

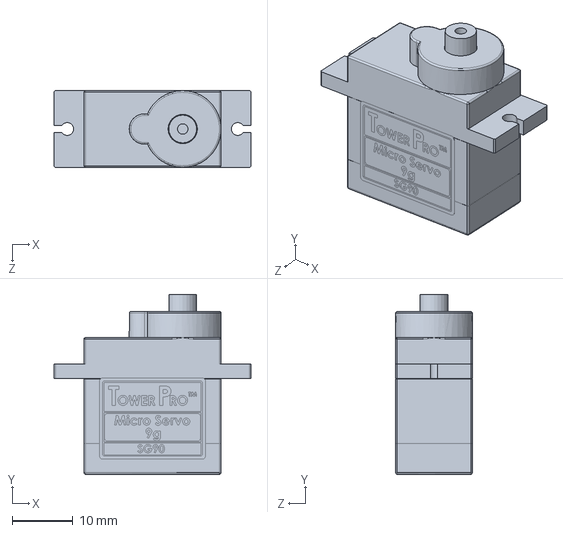
[picture p183: CAD file, 2015-08-02]
SolidWorks parts/SG90 BODY.SLDPRT
32.4 x 29.6 x 12.6 mm
