gzgreg/enph253-2015-team13/SolidWorks parts/Zip Line Mechanism/PinSupport v3.SLDPRT

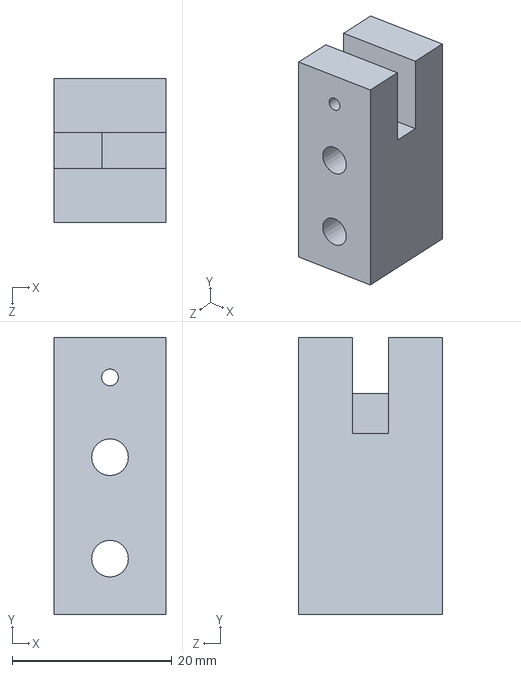
[picture p184: CAD file, 2015-08-01]
SolidWorks parts/Zip Line Mechanism/PinSupport v3.SLDPRT
14.0 x 34.7 x 18.0 mm
