gzgreg/enph253-2015-team13/SolidWorks parts/Zipline Catcher/Pin Support Rev 2.SLDPRT

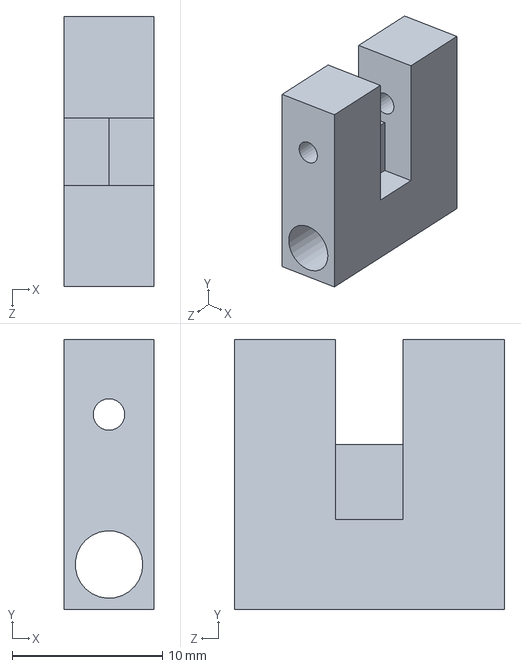
[picture p185: CAD file, 2015-07-23]
SolidWorks parts/Zipline Catcher/Pin Support Rev 2.SLDPRT
6.00 x 18.0 x 18.0 mm
