gzgreg/enph253-2015-team13/SolidWorks parts/ARM Design/Design 5/Arm_v3V4.0V5.0.SLDASM

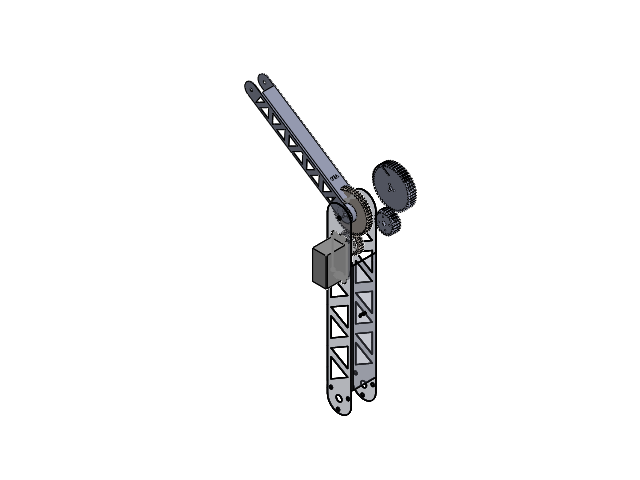
[picture p186: CAD file, 2015-08-13]
SolidWorks parts/ARM Design/Design 5/Arm_v3V4.0V5.0.SLDASM
Servo Futaba S3003V4.0V5.0FINAL
Servo SpindleV4.0V5.0FINAL
Servo RotorV4.0V5.0FINAL
amr_seg2_v3V4.0V5.0FINAL
gear spacerV4.0V5.0FINAL x 2
arm_segment_v3V4.0V5.0FINAL
spur gear_iso x 2
