gzgreg/enph253-2015-team13/SolidWorks parts/ARM Design/Servo Assembly Futaba S3003V4.0.SLDASM

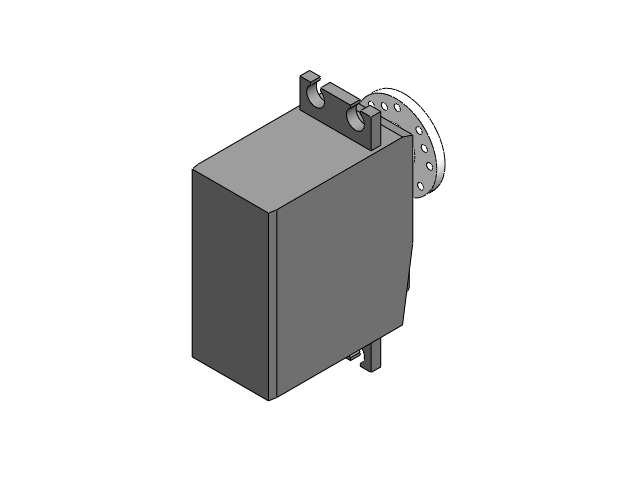
[picture p187: CAD file, 2015-07-17]
SolidWorks parts/ARM Design/Servo Assembly Futaba S3003V4.0.SLDASM
Servo Futaba S3003V4.0
Servo SpindleV4.0
Servo RotorV4.0
