gzgreg/enph253-2015-team13/SolidWorks parts/ARM Design/MountV4.0.SLDASM

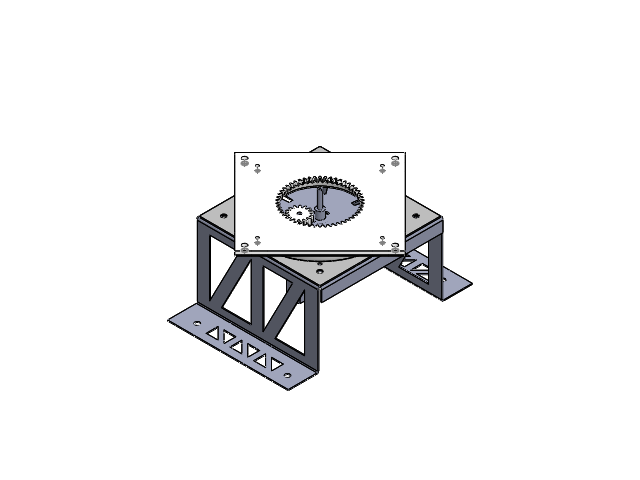
[picture p188: CAD file, 2015-07-17]
SolidWorks parts/ARM Design/MountV4.0.SLDASM
arm_mountV4.0
6031K170 (Lazy Susan)V4.0
Internal_spurV4.0
PotentiometerV4.0
arm_rotation_spur_gearV4.0
Arm_rotation_motorV4.0
