gzgreg/enph253-2015-team13/(list of files, cad)

Other CAD files:
SolidWorks parts/Arm Release/ASM Servo.SLDASM
SolidWorks parts/ARM Design/Arm_v3V4.0.SLDASM
SolidWorks parts/Servo Assembly Futaba S3003.SLDASM
SolidWorks parts/ARM Design/Design 5/Servo Assembly Futaba S3003V4.0V5.0.SLDASM
SolidWorks parts/Solarbotics motor B.SLDASM
SolidWorks parts/Arm Release/Servo Spindle.SLDPRT
SolidWorks parts/PLAN B STUFF/Basket-Triangles.SLDPRT
SolidWorks parts/Servo futaba/Servo Rotor.SLDPRT
SolidWorks parts/Bumper/IRHousing-toPrint.SLDPRT
SolidWorks parts/ARM Design/arm_segment_v5.SLDPRT
SolidWorks parts/Arm Release/Servo Motor.SLDPRT
SolidWorks parts/Basket Lift Mechanism - Version 1/MotorBarbColeGeared.SLDPRT
Robot/SolidWorks Parts/Pet Basket.SLDPRT
SolidWorks parts/ARM Design/4mm_shaft.SLDPRT
SolidWorks parts/ARM Design/4mm_shaftV4.0.SLDPRT
SolidWorks parts/ARM Design/6031K170 (Lazy Susan)V4.0.SLDPRT
SolidWorks parts/ARM Design/Arm base Flange with motor mountV4.0.SLDPRT
SolidWorks parts/ARM Design/Arm_V1.0.SLDASM
SolidWorks parts/ARM Design/Arm_mount_V4.0.SLDASM
SolidWorks parts/ARM Design/Arm_rotation_motor.SLDPRT
SolidWorks parts/ARM Design/Arm_rotation_motorV4.0.SLDPRT
SolidWorks parts/ARM Design/DC motor.SLDPRT
SolidWorks parts/ARM Design/DC motorV4.0.SLDPRT
SolidWorks parts/ARM Design/Design 1/6031K180-LazySusan.SLDPRT
SolidWorks parts/ARM Design/Design 2/6031K180-LazySusan.SLDPRT
SolidWorks parts/ARM Design/Design 2/Sleeve.SLDPRT
SolidWorks parts/ARM Design/Design 2/armRotationPlate.SLDPRT
SolidWorks parts/ARM Design/Design 5/4mm_shaftV4.0V5.0.SLDPRT
SolidWorks parts/ARM Design/Design 5/6031K170 (Lazy Susan)V4.0V5.0.SLDPRT
SolidWorks parts/ARM Design/Design 5/Arm_rotation_motorV4.0V5.0.SLDPRT
SolidWorks parts/ARM Design/Design 5/GM7V5.0.SLDPRT
SolidWorks parts/ARM Design/Design 5/Internal_spurV4.0V5.0.SLDPRT
SolidWorks parts/ARM Design/Design 5/Mecano ThingyV4.0V5.0.SLDPRT
SolidWorks parts/ARM Design/Design 5/PotentiometerV4.0V5.0.SLDPRT
SolidWorks parts/ARM Design/Design 5/Servo Futaba S3003V4.0V5.0.SLDPRT
SolidWorks parts/ARM Design/Design 5/Servo RotorV4.0V5.0.SLDPRT
SolidWorks parts/ARM Design/Design 5/Servo SpindleV4.0V5.0.SLDPRT
SolidWorks parts/ARM Design/Design 5/amr_seg2_v3V4.0V5.0.SLDPRT
SolidWorks parts/ARM Design/Design 5/arm big gear.SLDPRT
SolidWorks parts/ARM Design/Design 5/arm_encoder_gearV5.0.SLDPRT
SolidWorks parts/ARM Design/Design 5/arm_mountV4.0V5.0.SLDPRT
SolidWorks parts/ARM Design/Design 5/arm_rotation_spur_gearV4.0V5.0.SLDPRT
SolidWorks parts/ARM Design/Design 5/bevel gear box.SLDPRT
SolidWorks parts/ARM Design/Design 5/bevel pinion.SLDPRT
SolidWorks parts/ARM Design/Design 5/big transmission gear.SLDPRT
SolidWorks parts/ARM Design/Design 5/bushing-spacer2V4.0V5.0.SLDPRT
SolidWorks parts/ARM Design/Design 5/bushing-spacer3V4.0V5.0.SLDPRT
SolidWorks parts/ARM Design/Design 5/bushing-spacerV4.0V5.0.SLDPRT
SolidWorks parts/ARM Design/Design 5/gear spacerV4.0V5.0.SLDPRT
SolidWorks parts/ARM Design/Design 5/large bevel gear.SLDPRT
SolidWorks parts/ARM Design/Design 5/metal_shaft_couplerV4.0V5.0.SLDPRT
SolidWorks parts/ARM Design/Design 5/mod1_25T_gear_laser_offsetV4.0V5.0.SLDPRT
SolidWorks parts/ARM Design/Design 5/mod1_50t_laser_offsetV4.0V5.0.SLDPRT
SolidWorks parts/ARM Design/Design 5/motor gear collar.SLDPRT
SolidWorks parts/ARM Design/Design 5/motor gear.SLDPRT
SolidWorks parts/ARM Design/Design 5/pot_gearV5.0.SLDPRT
SolidWorks parts/ARM Design/Design 5/small transmission gear.SLDPRT
SolidWorks parts/ARM Design/Design 5/top_arm_spacerV4.0V5.0.SLDPRT
SolidWorks parts/ARM Design/Design 5/worm for helical gearV4.0V5.0.SLDPRT
SolidWorks parts/ARM Design/Internal_spur.SLDPRT
SolidWorks parts/ARM Design/Internal_spurV4.0.SLDPRT
SolidWorks parts/ARM Design/Mecano ThingyV4.0.SLDPRT
SolidWorks parts/ARM Design/Mount.SLDASM
SolidWorks parts/ARM Design/Part3V4.0.SLDPRT
SolidWorks parts/ARM Design/PotentiometerV4.0.SLDPRT
SolidWorks parts/ARM Design/Servo Futaba S3003V4.0.SLDPRT
SolidWorks parts/ARM Design/Servo RotorV4.0.SLDPRT
SolidWorks parts/ARM Design/Servo SpindleV4.0.SLDPRT
SolidWorks parts/ARM Design/amr_seg2_v3V4.0.SLDPRT
SolidWorks parts/ARM Design/arm_mount.SLDPRT
SolidWorks parts/ARM Design/arm_mountV4.0.SLDPRT
SolidWorks parts/ARM Design/arm_rotation_spur_gear.SLDPRT
SolidWorks parts/ARM Design/arm_rotation_spur_gearV4.0.SLDPRT
SolidWorks parts/ARM Design/arm_segment_v3.SLDPRT
SolidWorks parts/ARM Design/arm_segment_v3V4.0.SLDPRT
SolidWorks parts/ARM Design/bushing-spacer.SLDPRT
SolidWorks parts/ARM Design/bushing-spacer2.SLDPRT
SolidWorks parts/ARM Design/bushing-spacer2V4.0.SLDPRT
SolidWorks parts/ARM Design/bushing-spacer3.SLDPRT
SolidWorks parts/ARM Design/bushing-spacer3V4.0.SLDPRT
SolidWorks parts/ARM Design/bushing-spacerV4.0.SLDPRT
SolidWorks parts/ARM Design/gear spacerV4.0.SLDPRT
SolidWorks parts/ARM Design/helical gear 40 teethV4.0.SLDPRT
SolidWorks parts/ARM Design/internal_spur_offset.SLDPRT
SolidWorks parts/ARM Design/metal_shaft_couplerV4.0.SLDPRT
SolidWorks parts/ARM Design/mod1_25T_gear_laser_offsetV4.0.SLDPRT
SolidWorks parts/ARM Design/mod1_50t_laser_offsetV4.0.SLDPRT
SolidWorks parts/ARM Design/mod1_50t_spur gear_iso.SLDPRT
SolidWorks parts/ARM Design/new motor flange.SLDPRT
SolidWorks parts/ARM Design/pot_gear.SLDPRT
SolidWorks parts/ARM Design/top_arm_spacer.SLDPRT
SolidWorks parts/ARM Design/top_arm_spacerV4.0.SLDPRT
SolidWorks parts/ARM Design/worm for helical gearV4.0.SLDPRT
SolidWorks parts/ARM Design/~70x5mmCrosspin.SLDPRT
SolidWorks parts/ASM Servo/ASM Servo.SLDASM
SolidWorks parts/ASM Servo/Servo Motor.SLDPRT
SolidWorks parts/ASM Servo/Servo Rotor.SLDPRT
SolidWorks parts/ASM Servo/Servo Spindle.SLDPRT
SolidWorks parts/Arm base Flange with motor mount.SLDPRT
SolidWorks parts/Axel.SLDPRT
SolidWorks parts/Basket Lift Mechanism - R-Dawg Version 2.0/CrudeMotorRemake.SLDPRT
SolidWorks parts/Basket Lift Mechanism - R-Dawg Version 2.0/FixedArmShaft.SLDPRT
SolidWorks parts/Basket Lift Mechanism - R-Dawg Version 2.0/FixedArmSpacer.SLDPRT
SolidWorks parts/Basket Lift Mechanism - R-Dawg Version 2.0/GM7.SLDPRT
SolidWorks parts/Basket Lift Mechanism - R-Dawg Version 2.0/Part1.SLDPRT
SolidWorks parts/Basket Lift Mechanism - R-Dawg Version 2.0/SlideArmPinSlider.SLDPRT
SolidWorks parts/Basket Lift Mechanism - R-Dawg Version 2.0/SlideArmShaft.SLDPRT
SolidWorks parts/Basket Lift Mechanism - R-Dawg Version 2.0/SweetSpinner-v2.SLDPRT
SolidWorks parts/Basket Lift Mechanism - R-Dawg Version 2.0/SweetSpinner.SLDPRT
SolidWorks parts/Basket Lift Mechanism - Version 1/DrivenArmBasePinJoint-BackupModel.SLDPRT
SolidWorks parts/Basket Lift Mechanism - Version 1/DrivenArmBasePinJoint-WithMotorMount-v2.SLDPRT
SolidWorks parts/Basket Lift Mechanism - Version 1/DrivenArmBasePinJoint-WithMotorMount.SLDPRT
SolidWorks parts/Basket Lift Mechanism - Version 1/DrivenArmShaft.SLDPRT
SolidWorks parts/Basket Lift Mechanism - Version 1/DrivenArmTopPinJoint.SLDPRT
SolidWorks parts/Basket Lift Mechanism - Version 1/HelicalGear40Teeth.SLDPRT
SolidWorks parts/Basket Lift Mechanism - Version 1/MachinedDrivenPin.SLDPRT
SolidWorks parts/Basket Lift Mechanism - Version 1/MotorBarbColeUngeared.SLDPRT
SolidWorks parts/Basket Lift Mechanism - Version 1/SlideArmPinSlider.SLDPRT
SolidWorks parts/Basket Lift Mechanism - Version 1/SlideArmPoleHolder.SLDPRT
SolidWorks parts/Basket Lift Mechanism - Version 1/SlideArmShaft.SLDPRT
SolidWorks parts/Basket Lift Mechanism - Version 1/TopShelf-v1.SLDPRT
SolidWorks parts/Basket Lift/Basket holder.SLDPRT
SolidWorks parts/Bumper/Bumper.SLDPRT
SolidWorks parts/Bumper/Part3.SLDPRT
SolidWorks parts/Catapult Basket/Archive/Catapult Basket - Catapult Rev 1.SLDPRT
SolidWorks parts/Catapult Basket/Archive/Catapult Basket - Catapult Rev 2.SLDPRT
SolidWorks parts/Catapult Basket/Archive/Catapult Basket - Catapult Slope Side Rev 1.SLDPRT
SolidWorks parts/Catapult Basket/Archive/Catapult Basket Rev 1.SLDPRT
SolidWorks parts/Catapult Basket/Archive/Side Shot Basket (Inner).SLDPRT
SolidWorks parts/Catapult Basket/Archive/Side Shot Basket (Outer).SLDPRT
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
