gzgreg/enph253-2015-team13/Lab/Diagrams for Report/GeneralSetup.png

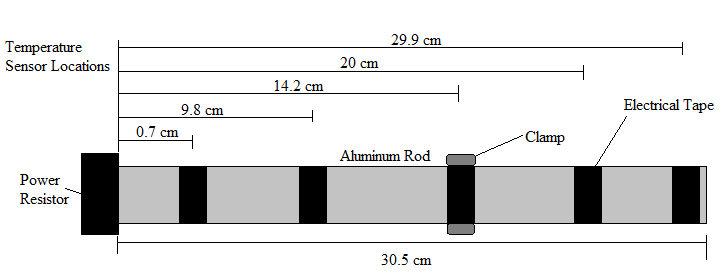
Lab/Diagrams for Report/GeneralSetup.png
