gzgreg/enph253-2015-team13/Lab/Transient Insulated Rod Heating/results from fitting.txt

Conduction constant k = 221.2
kc, epsilon inside tube = 0
kc outside tube = 175
epsilon outside tube = 1
