gzgreg/enph253-2015-team13/Lab/STEADY STATE RESULTS/Appendix PDFs/Moist Steady State Sim.pdf

## Horizontal Moist rod Steady State simulation

%2015.06.03
%ENPH 257 Lab -Group13

clear all;
close all;
%Load the results
load('June12MoistRodSteadyState.mat');

radius = 0.0111;%m
length = 0.305;%m
nstep = 50;
dx =length/nstep;%m

%Thermo constants
k =200; %W / (m*K)- conduction
sigma = 5.67e-8;%W/ (m^2 * K^4)stefan-boltzman const emsv= 0.2; %emissivity
moist_kc =5.0;%W/ (m^2 * K)
fudgeE = 1.5; %fudge factor forevaporation
alpha = 1.9e-5;%m^2/skinematicviscosity of air g =9.81; %m/s^2
kc =20.0;%W /(m^2 * K)
emsv_elec_tape =0.95;
emsv_cloth=0.9;
width_tape=.020;%m,width of theelectricaltape
pwrR_Area = ((15.5*20.7)+ 2*(15.5*2)+ 2*(20.7*2))*10^-6;%m^2, areaofpwr resistor emsvR = 0.8;%emsivityofpower resistor
latentHeatWaterEvap =2260; %J/g
totalEvapPowerLoss= 0.0; %0.0 Valueis a placeholderuntilloop isexicuted

%measurementpoints
h5 =0.006;%m, distance fromendhole h4 =0.105;%m, distance fromendhole h3 =0.163;%m, distance fromendhole h2 =0.207;%m, distance fromendhole h1 =0.298;%m, distance fromendhole

t1st= h1 - width_tape/2;
t2st= h2 - width_tape/2;
t2end = h2+width_tape/2;
t3st= h3 - width_tape/2;
t3end = h3+width_tape/2;
t4end = h4+width_tape/2;
t4st= h4 - width_tape/2;
t5end = h5+width_tape/2;

ambPin = 1;
readRangeStart =1;
readRangeEnd= 400;
sensorDataC = 1:6;

offset = moistOffsetCalculator('June12MoistRodHeating.mat',120,ambPin);
calibratedData =moistCalibrate(readings,readRangeStart,readRangeEnd,ambPin);%calibrates data inreading range
fori = 1:6
sensorDataC(i)= mean(calibratedData(i,:))+ offset(i);%C,averagestemperatureat eachs ensor and applies additionaloffset
end

sensorPos = [h1h2h3h4h5];%fromend hole

x =1:nstep;%just placeholderdata
T =1:nstep;%just placeholderdata

Tamb= sensorDataC(6)+273;%K T(1)= sensorDataC(5)+273;%K

%Endconditions

P_conv_end=kc* pi * radius^2* (T(1) - Tamb);
% $P_{conv} = k_c (2\pi r)dx(T(1)^4 - T_{amb}^4)$
P_conv_an = kc *2* pi * radius*dx* (T(1)- Tamb);%convectionpowerlossfortheannulus of the endof the rod
P_rad_end = sigma * emsv* pi*radius^2*(T(1)^4- Tamb^4);
P_rad_an =sigma*emsv_elec_tape *2* pi* radius *dx*(T(1)^4-Tamb^4);

P_out = P_conv_end+ P_conv_an +P_rad_end+ P_rad_an;
P_in= P_out;
x(1)= dx;

fori = 2:nstep
x(i) = i * dx;
P_out =P_in;
T(i) = T(i-1);

%is thesliceon the tapeornot?
if(x(i) < t5end)||(x(i) >t4st&&x(i)< t4end) || (x(i) >t3st&&x(i) <t3end)||(x(i) > t2st &&x(i)< t2end)|| (x(i) >t1st)
P_conv =kc* 2 *pi *radius* dx *(T(i) - Tamb);
P_rad= emsv_elec_tape*sigma* (2*pi*radius)*dx*(T(i)^4-Tamb^4);
P_loss =P_conv +P_rad;
else

if (x(i) <t4st && x(i)> t5end)
P_conv = moist_kc* 2*pi* radius* dx *(T(i)- Tamb); P_rad=emsv_cloth*sigma* (2*pi*radius)*dx* (T(i)^4-Tamb^4); P_evap = fudgeE *dx* (T(i)-Tamb);

P_loss = P_conv +P_rad+P_evap;

totalEvapPowerLoss=totalEvapPowerLoss +P_evap;

else

P_conv = kc *2 *pi* radius*dx*(T(i)- Tamb); P_rad=emsv * sigma* (2*pi*radius)*dx*(T(i)^4-Tamb^4); P_loss = P_conv +P_rad;
end
end

P_in = P_out+ P_loss;
dT = P_in* dx/(k * pi * radius^2); T(i) = T(i) +dT;
end

pwrR_loss = emsvR * sigma * pwrR_Area*dx*(T(nstep)^4-Tamb^4)+ kc*pwrR_Area *dx*(T(nstep ) -Tamb);%powerlossfrom powerresistor
pwrR_rod =P_in;%the power goingintothe rodis thepowergoing intothelast slice(whichi s the slice adjancenttothepowerresistor)
pwrR_tot =9*.6;%W, 9V*0.6A,this shouldequalthe powerlossplusthepowerin
pwrFract = pwrR_rod/(pwrR_tot);%fraction of power goingintorod
display(pwrR_tot)
display(pwrR_loss+pwrR_rod);

pwrR_tot =

5.4000

ans=

4.7125

figure
plot(length - x,T-273);
holdon
errorbar(length- sensorPos,sensorDataC(1:5),[3 33 33],'ro'); plot(x,Tamb-273,'r');
title('Simulation of HorizontalMoistRod'); legend('Model','data','Ambient temp');
xlabel('{\itx}(m)')
ylabel('{\itT}(C)')
set(gca, 'FontSize', 16)
set(gca, 'FontName', 'TimesRoman')

waterEvapPerSec= totalEvapPowerLoss/ latentHeatWaterEvap%g/s display(totalEvapPowerLoss)%W

waterEvapPerSec=

3.3383e-04

totalEvapPowerLoss=

0.7545


Published with MATLAB® R2013a (http://www.mathworks.com/products/matlab/)
