gzgreg/enph253-2015-team13/Robot/Electrical/IR Circuit - PhotoTransistor Voltage vs Distance Test.xlsx

Sheet: Sheet1
Distance Away (cm) | Voltage (V)
0 | 5.2
10 | 5.2
20 | 5.2
30 | 5.12
40 | 5.12
50 | 4.16
60 | 3.2
70 | 2.64
80 | 2.16
90 | 1.84
100 | 1.6
110 | 1.36
120 | 1.12
130 | 1.04
140 | 0.96
150 | 0.88
160 | 0.8
170 | 0.76
180 | 0.74
190 | 0.72
200 | 0.64

Sheet: Sheet2
Distance Away (cm) | Voltage (V)
40 | 5.12
50 | 4.16
60 | 3.2
70 | 2.64
80 | 2.16
90 | 1.84
100 | 1.6
110 | 1.36
120 | 1.12
130 | 1.04
140 | 0.96
150 | 0.88
160 | 0.8
170 | 0.76
180 | 0.74
190 | 0.72
200 | 0.64
