gzgreg/enph253-2015-team13/Lab/Transient results/parameter values.xlsx

Experiment | k | deltak | kc | deltakc | eps | deltaeps | kcend | deltakcend | epsend | deltaepsend | c | deltac | Uncertainty | Column1 | Column2
Insulated | 189 | 70 | 0 | 1 | 0.39 | 0.12 | 375 | 100 | 1 | 1 | 988 | 200 | 5.62
Bare | 278 | 100 | 14 | 6 | 1 | 0.75 |  |  |  |  | 1353 | 550 | 2.66
Vertical (Resistor on top) | 206 | 160 | 16.5 | 6.5 | 0.3 | 0.7 |  |  |  |  | 1403 | 500 | 2.4
Vertical (Resistor on bottom) | 270 | 130 | 12.4 | 3 | 0.3 | 0.45 |  |  |  |  | 1059 | 550 | 4.14
Moist | 191 | 80 | 17.6 | 9 | 1 | 0.6 |  |  |  |  | 1381 | 600 | 3.45 | power loss = 0 +- 0.8 W
Black | 163 | 75 | 16.4 | 4 | 1 | 0.5 |  |  |  |  | 1563 | 450 | 2
 | 178 < k < 238 |  |  |  | 0.25 < eps < 0.75 | (for bare rod) |  |  |  |  | 1113 < c < 1188
