gzgreg/enph253-2015-team13/Lab/Bare_rod_test_June3/html/transFinDiffPlotter_01.png

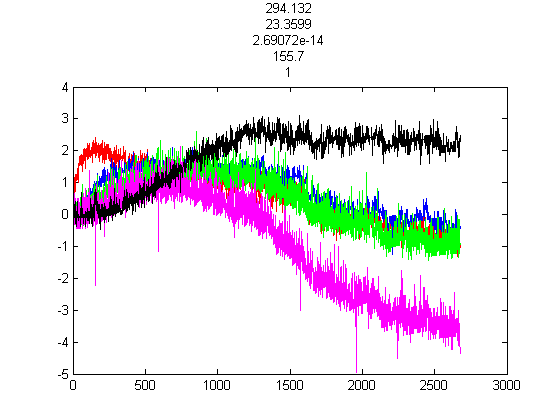
Lab/Bare_rod_test_June3/html/transFinDiffPlotter_01.png
