gzgreg/enph253-2015-team13/Lab/Transient results/blackrod.png

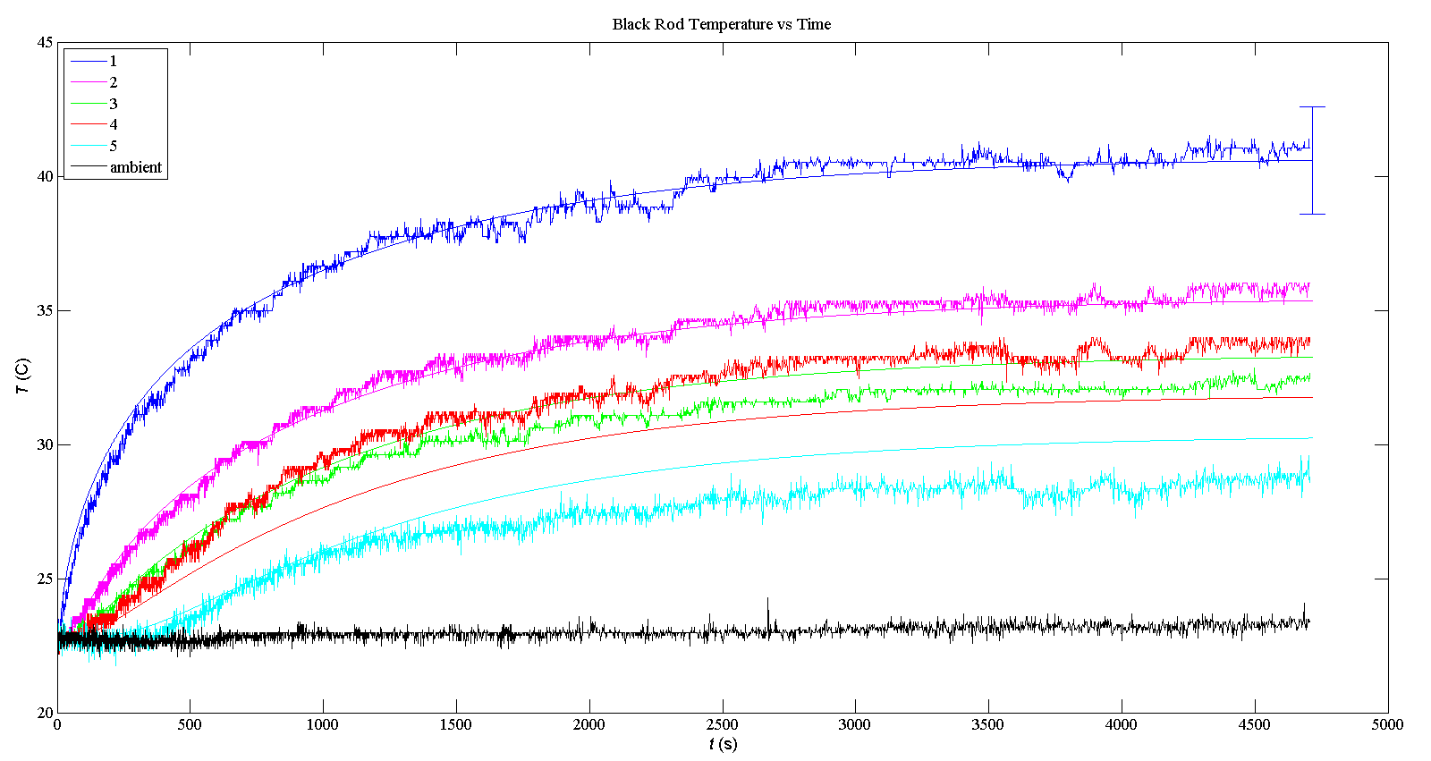
Lab/Transient results/blackrod.png
