gzgreg/enph253-2015-team13/Lab/Transient results/insulatedrod.png

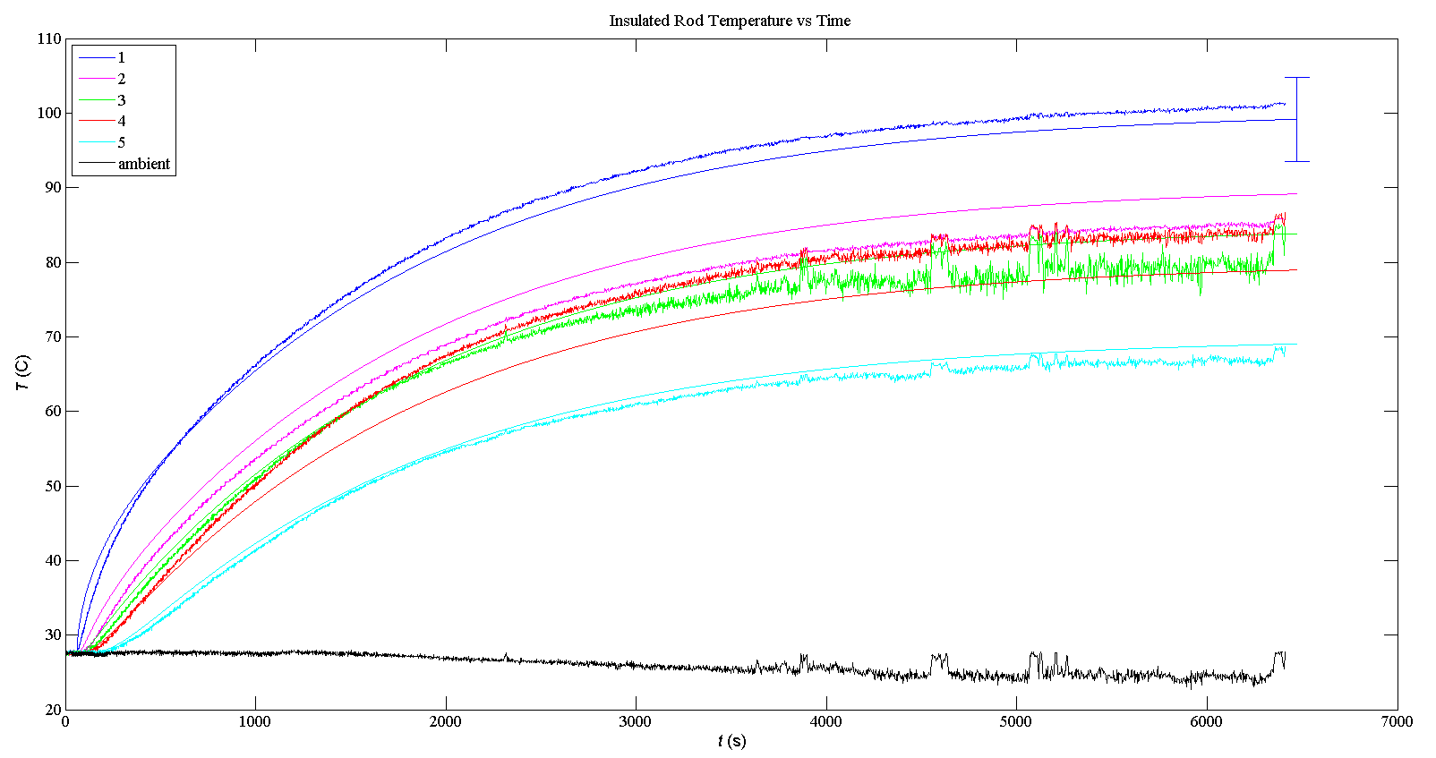
Lab/Transient results/insulatedrod.png
