gzgreg/enph253-2015-team13/Lab/Transient results/moistrod.png

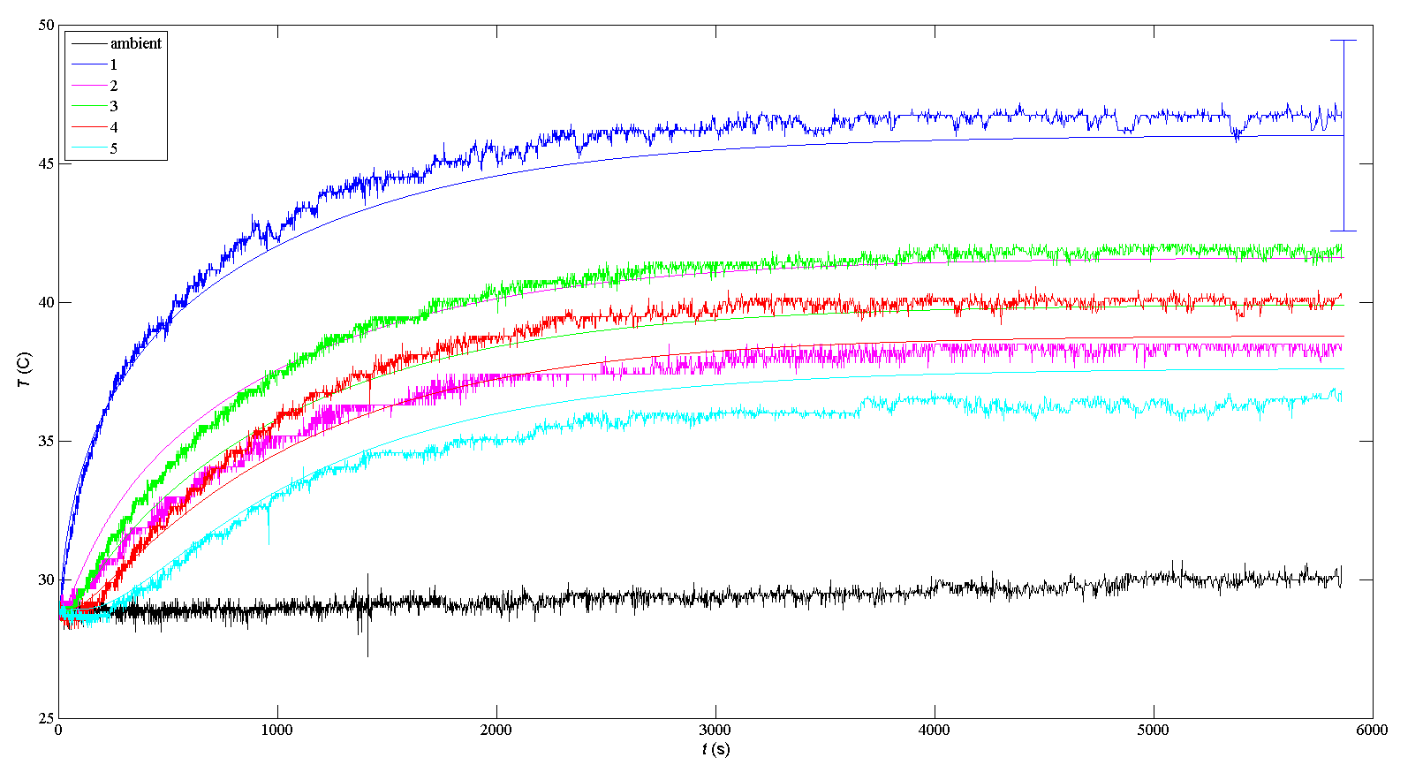
Lab/Transient results/moistrod.png
