gzgreg/enph253-2015-team13/Lab/Transient results/verticalrodbottom.png

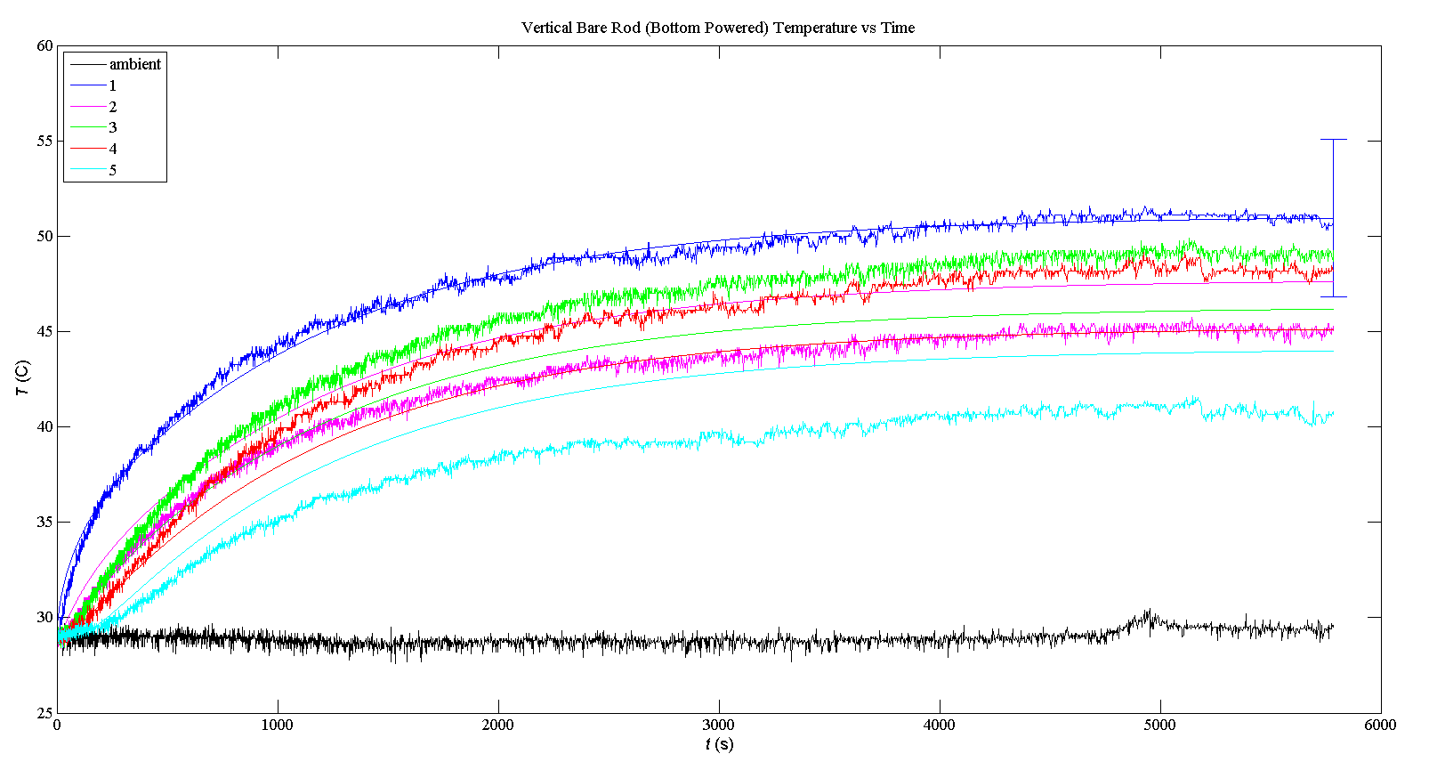
Lab/Transient results/verticalrodbottom.png
