gzgreg/enph253-2015-team13/Lab/Transient results/verticalrodtop.png

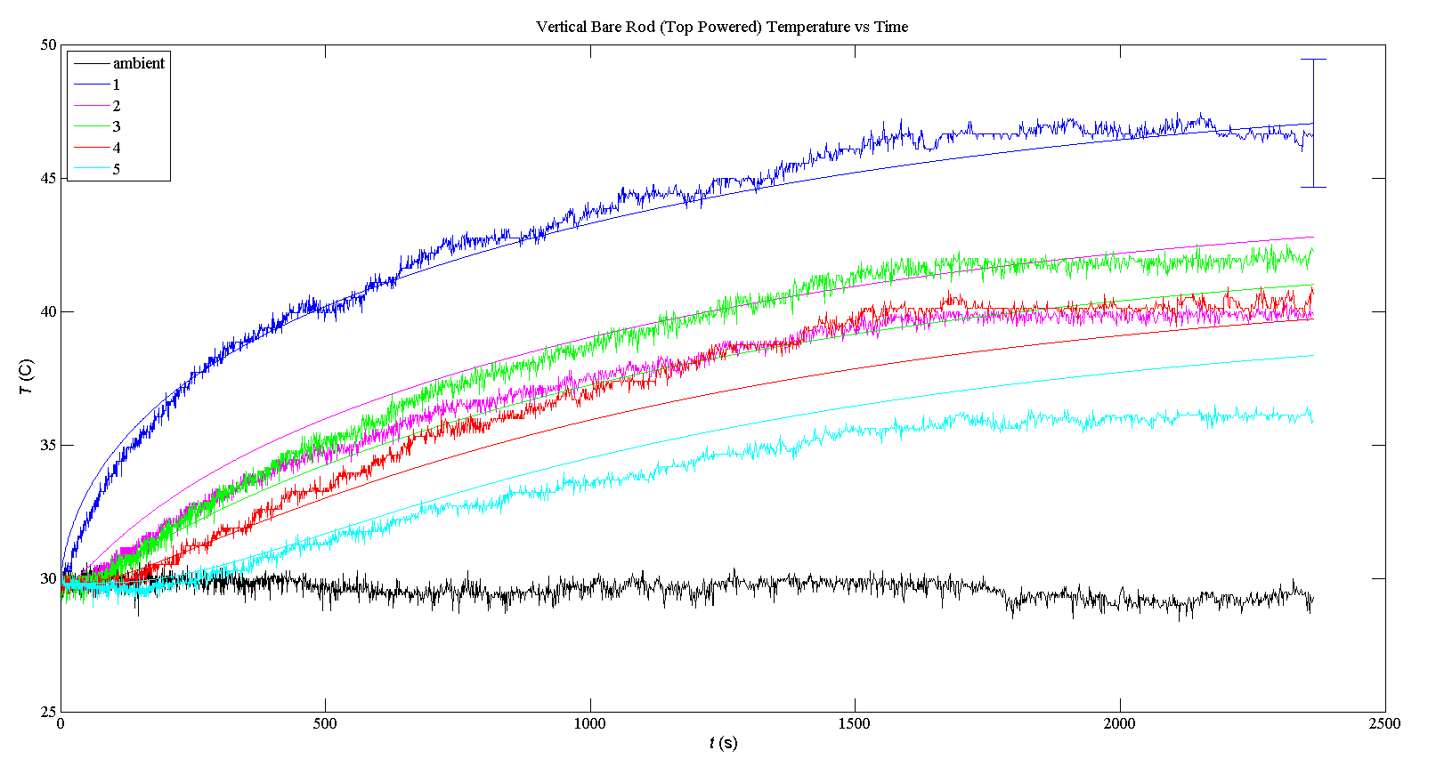
Lab/Transient results/verticalrodtop.png
