gzgreg/enph253-2015-team13/Robot/Formal Design Proposal - Risk Assessment and Contingency Planning.xlsx

Risk Condition | Probability of occurrence | Impact to Project | Change to Work Plan | Expected Date of Risk Decision
Chassis Risks
Chassis is unable to fit all internal components | Low | Components such as the robotic arm and circuits will not be included in the robot. Redesign of components or chassis may be required. | Chassis redesign to allow more space claim for more components. Smaller components such as PCB's can also be mounted outside of the chassis rather than inside.
Chassis is not designed for easy access to internal components | Low | It will be difficult to conduct maintenance, testing, and replacement tasks on the robot's components. | Chassis redesign to allow easier access to components, such as a chassis that incoroporates a large opening. Smaller components such as PCB's can also be mounted outside of the chassis rather than inside.
Arm Risks
Arm cannot locate first pets (after pet tape marking is found) | Medium | Pet retrieval becomes a major issue, preventing our robot from scoring points. Recalbiration of the arm's potentionmeters would be required. | Recalibrate the potentiometer/s used on the robotic arm so that it utilizes the correct angles that allows for effective pet retrieval.
Arm cannot locate pets (either due to the arm being too long or short) | Medium | Pet retrieval becomes a major issue, preventing our robot from scoring points. A redesign to the arm and/or its placement must be conducted. | Redsign the arm with different dimensions in order to reach a wider area. Another option is to change the placement of the arm on the chassis.
Arm is unable to locate basket, leading to misplaced release of pets | Medium | Pet retrieval becomes a major issue, preventing our robot from scoring points. Recalbiration of the arm's potentionmeters would be required. | Recalibrate the potentiometer/s used on the robotic arm so that it utilizes the correct angles that allows for effective pet release.
Arm is unable to release pets onto basket using an electromagnet | Medium | Pet retrieval becomes a major issue, preventing our robot from scoring points. Design would require an aluminum plate and another motor. | Pet release mechanism will be switched with an aluminum plate that separates a magnet on the arm with the magnet on the pet. A motor will turn the plate to separate the two magnets once the pet is on top of the basket.
Arm is distorting performance of tape following sensor (since it is placed close to the sensors) | High | Tape following system becomes flawed due to extra mass on top of the sensors (pivot of the robot). | Recalibration of the tape following system will most likely be conducted. Another option would be to change the placement of the arm so that it does not significantly distort the performance of the tape follower, but is not recommended.
Basket Risks
Basket catapult is unable to launch three pets into the rescue area | Medium | Affects strategy of guaranteeing at least three points when scoring. This will either require different torsion springs must be used, or a redesign of the release mechanism depending on the situation. | If the issue is a result of the torsion springs not being strong enough to catapult the pets into rescue area, then the torsion springs need only be replaced by stronger ones (a redesign of the basket may be required to accommodate larger springs). The more likely scenario would be that the release mechanism does not activate properly, which would require a redesign of the whole mechanism.
Basket is unable to locate and grab the zipline | High | Accordion linkage does not allow the basket to rise up in order to grab the zipline, or the motor is too weak to lengthen the linkage. All of these issues would likely be due to friction. Grabbing the zipline, however, would require a redesign of the grabbing mechanism. Overall, this prevents the robot from delivering the last three pets, which is a majority of the points. | Rather than an accordion linkage, the basket would utilize a pulley system to rise up in order to grab the zipline.
Basket is unable to separate from the robot once attached to the zipline | Low | It affects the delivery of the last three pets if the basket gets stuck on the surface attached to the linkage. | A redesign of the accordion linkage's surface where the basket will sit on will be required to minimize the chances of the basket getting stuck.
Driver System Risks
Driver System's optimal speed is too slow to be considered a competitive speed and/or carry the robot over the ramp | High | The drive system would need to be recalibrated, which would require additional time. | Different sizes of drive gears and or wheels may need to be fabricated in order to change the power output of the motors. Other options include changing the power input into the motor, or using different motors for the drive system altogether.
Size of gears are unrealistic in terms of the amount of space claim available for the gears. | Medium | Depending on the gear calculations, some gears may be too big to realistically or effectively fit in the robot. | Recalculation of the gear calculations must be conducted, taking into account any newly found constratints of the robot's space claim.
Sensor System, Tape Follower, Electrical Circuit Risks
Tape Follower loses sight of the tape, especially when making turns at corners | High | Affects the overall strategy for the competition if the robot is unable to effectively follow the tape. Many calibration tests would be required. | Many calibration tests must be conducted on the robot with most, if not all, of its components installed. This would be time consuming but essential, so the assigned team member who will be conducting these tests will be occupied for the duration of the tests.
Sensor System is unable to operate over the 1-7 foot range when locating the final pet | High | The robot would be unable to detect the IR beam, which locates the final pet, as well as the zipline. | The IR detection circuit must be redesigned in order to accommodate a wider range.
Overall electrical circuit cannot relay communication between components in the robot | High | An issue of communication between the TINAH and the component will affect the overall strategy for the competition. | Electrical circuits for communication between the TINAH and the component must be redesigned more increased reliability.
Construction Risks
Gear ratio required for the design is unrealistic in terms of creating the gear | Low | Gear ratio determined must be altered to accommodate a more realistic gear ratio. | If the gear required for the design is unrealistic in terms of size and number of teeth, then the components that use these gears must be altered in order to accommodate more realistic gears. If the material used for the gears is too weak to handle the torque placed upon it, then the material needs to be stronger. Otherwise, different dimensions for the gear must be used.
Accordion linkage is not built reasonably straight, and may have additional friction due to dissimilar lengths of links | Medium | Refabrication of links would be required in order to fabricate a more effective accordion linkage. | Accordion links must have the same lengths and rivoted in the exact same places. The accuracy of this process is crucial for the effectiveness of the linkage, seeing as that it determines the delivery of the last three pets.
Non-technical Risks
A team member becomes temporarily or permanently unavailable to work on the project | Medium | Project productivity would be temporarily decreased, as there are less members of the team present. | All team members must be proficient at all of the tasks given in the task list, and must be ready to fill in for the absent member. The absent member may also provide guidelines to their current task for their temporary replacement prior to their absence.
A team member is found to have a bigger workload than he can handle | Medium | Individual productivity would decrease donsidering the amount of workload the team member has. | Some of the team member's workload will be distributed evenly to all team members, or covered by another team member with a relatively smaller workload.
A team member is found to have a small amount of tasks to conduct at a given time | Medium | Individual productivity would not be used to its maximum potential | The team member will be assigned additional tasks, either help another team member with their task at the discretion of both team members, and enhancing tasks such as planning redesigns, component testing, etc.
