gzgreg/enph253-2015-team13/Robot/Code/robotIR/robotIR.ino

#include "preprocessor.h"
#include <phys253.h>
#include <LiquidCrystal.h>

int errDeriv, prevErr, errTime, prevErrTime, threshold, i;

void setup()
{
  #include <phys253setup.txt>
  Serial.begin(9600);
}

void loop()
{   
  int leftErr = analogRead(LEFT_IR);
  int rightErr = analogRead(RIGHT_IR);
  
  int totalErr = (leftErr - rightErr) * 100 / (leftErr + rightErr); //normalize

  if (totalErr != prevErr) {
    errTime = 0;
    prevErrTime = errTime; //take slope from change before previous change
  }

  errDeriv = (totalErr - prevErr) / (errTime + prevErrTime);
  int correct = (PIR.Value * totalErr - DIR.Value * errDeriv);
  if(correct > Speed.Value * 2) correct = Speed.Value * 2;
  if(correct < -Speed.Value * 2) correct = -Speed.Value * 2;
  
  int leftMotor, rightMotor;
  leftMotor = (correct > 0) ? Speed.Value : Speed.Value + correct;
  rightMotor = (correct < 0) ? -Speed.Value : -Speed.Value + correct;
  
  motor.speed(LEFT_MOTOR, leftMotor);
  motor.speed(RIGHT_MOTOR, rightMotor);
  
  if(i == 100){
    if(startbutton()){
      delay(50);
      if(startbutton()){
        motor.speed(LEFT_MOTOR, 0);
        motor.speed(RIGHT_MOTOR, 0);
        Menu();
      }
    }
    
    if(stopbutton()){
      delay(50);
      if(stopbutton()){
        motor.speed(LEFT_MOTOR, 0);
        motor.speed (RIGHT_MOTOR, 0);
        delay(BUTTON_WAIT);
        while(!stopbutton()){
          int leftSensor = analogRead(LEFT_IR);
          int rightSensor = analogRead(RIGHT_IR);
          LCD.clear();
          LCD.home();
          LCD.print(leftSensor);
          LCD.setCursor(0, 1);
          LCD.print(rightSensor);
          delay(50);
        }  
      }
      delay(BUTTON_WAIT);
    }
    
    LCD.clear();
    LCD.home();
    char buffer[1024];
    sprintf(buffer, "%d %d %f %d", leftErr, rightErr, totalErr, PIR.Value);
    LCD.print(buffer);
    LCD.setCursor(0, 1);
    sprintf(buffer, "%d %d %d %d", correct, leftMotor, rightMotor, DIR.Value);
    LCD.print(buffer);
    i = 0;
  }
  
  prevErr = totalErr;
  errTime = errTime + 1;
  i = i + 1;
}
