gzgreg/enph253-2015-team13/Robot/Code/ServoTest/servoTest.ino

#include <phys253.h>
#include <LiquidCrystal.h>

bool pos = false;

void setup()
{
  #include <phys253setup.txt>
  Serial.begin(9600);
}

void loop(){
  RCServo1.write(knob(6)*180.0/1023.0);
  LCD.home();LCD.print(knob(6)*180.0/1023.0);
  
/* if(startbutton()){
    delay(50);
    if(startbutton()){
      if(pos) RCServo1.write(180); else RCServo1.write(0);
      pos = !pos;
    }
  }
  */
}
