gzgreg/enph253-2015-team13/(commit log)

2015-06-02 add solidworks aluminum rod simulation
    [AlRodSim.SLDPRT]
2015-06-03 Parts for the pet basket
    [4mmTube.SLDPRT, 8mmEndCap.SLDPRT, 8mmTube.SLDPRT, Launch Bottom.SLDPRT, Pet Basket.SLDASM, Pet Basket.SLDPRT, Seal.SLDPRT]
2015-06-06 Calorimeter readings
    calo readings of al rod
2015-06-07 add PID tape follower algorithm
2015-06-07 Formal Design Proposal
    The following sections have been completed:
    - Overview of Basic Strategy
    - Executive Summary
    - Title Page and Table of Contents
    Pages have been reserved for the other sections.
    [Formal Design Proposal - Risk Assessment and Contingency Planning.xlsx]
2015-06-08 update tape follower code, add bearing holder
    [Bearing Holder.SLDPRT]
2015-06-08 Worked on Robot Arm Parts
    [ASM Servo.SLDASM, Arm_V1.0.SLDASM, Chassis V1.0.SLDPRT, Servo Motor.SLDPRT, Servo Rotor.SLDPRT, Servo Spindle.SLDPRT, armSeg1_V1.0.SLDPRT, armSeg2_V1.0.SLDPRT]
2015-06-08 Tests From Last Lab
    BEAR rod
2015-06-10 Added vertical axis rotation in robot arm
    [00 competition surface 2015.SLDASM, 6031K180-LazySusan.SLDPRT, ASM Servo.SLDASM, Arm_V1.0.SLDASM, Armbracket.SLDPRT, Chassis V1.0.SLDPRT, GM7.SLDPRT, Servo Motor.SLDPRT]
2015-06-10 Design Proposal Updated
    Major Milestones, Task List, and Team Responsibilities Section ready for
    review. Risk Assessment filled with major potential risks.
    [Formal Design Proposal - Risk Assessment and Contingency Planning.xlsx]
2015-06-10 Risk Assessment updated
    Basket launches pets down the ramp risk added
    [Formal Design Proposal - Risk Assessment and Contingency Planning.xlsx]
2015-06-10 Changed simulation files
    [Arm_V1.0.SLDASM, Assem1.SLDASM, Part2.SLDPRT, armSeg1_V1.0.SLDPRT, basket.SLDPRT]
2015-06-10 Bare Rod Stuff (June 10)
    GIT REKT BITCH
2015-06-11 add sensor threshold calibration to tape follower
2015-06-12 Data
    Moist Rod and Temp Sensor Calibration Data
2015-06-12 changes after friday lab
    [Arm_V1.0.SLDASM, Assem1.SLDASM, armSeg1_V1.0.SLDPRT]
2015-06-12 Formal Design Proposal Updated
    Formal Design Proposal has been updated. Letter of Transmittal written
    and ready for review. Risk Assessment and Contingency Planning
    statements filled in. Dates of decisions to be determined.
    [Formal Design Proposal - Risk Assessment and Contingency Planning.xlsx]
2015-06-15 Did a whole bunch of solidworks shit
    [4mmShaft.SLDPRT, 6031K180-LazySusan.SLDPRT, ASM Servo.SLDASM, Accordian_Linkage.SLDASM, Arm_V1.0.SLDASM, Arm_V2.0.SLDASM, Arm_bracket_V2.0.SLDPRT, Armbracket.SLDPRT]
2015-06-15 add zipline mechanism
    [Basket Attachment.SLDPRT, Bearing Holder.SLDPRT, Bearing Rod Holder.SLDPRT, Bearing Rod.SLDPRT, Pin.SLDPRT, Zipline.SLDASM]
2015-06-15 Merge branch 'master' of https://github.com/gzgreg/enph253-2015-team13
    Conflicts:
    SolidWorks parts/ARM Design/Design 1/armSeg1_V1.0.SLDPRT
    SolidWorks parts/Arm_V1.0.SLDASM
    [Arm_short_section_V2.0.SLDPRT]
2015-06-15 Made some small changes to design proposal
    Typos/wording etc.
    [ASM Servo.SLDASM, Arm_V2.0.SLDASM, Sleeve.SLDPRT, cylinder_joint.SLDPRT, long_arm_side_beam.SLDPRT]
2015-06-15 fix some stuff I screwed up in the repo earlier
2015-06-16 257 Lab Sensor Calibrations
    Here she goes!
2015-06-16 add calibration results
2015-06-17 some proposal stuff
    [PCB box.SLDPRT]
2015-06-17 more proposal things
    add a timeline, update zipline and write a little chassis stuff
2015-06-17 aparently some changes were made
    [Arm_V1.0.SLDASM, Arm_V2.0.SLDASM, Driven Linkage.SLDASM, armSeg1_V1.0.SLDPRT, linage with motor mount.SLDPRT]
2015-06-17 Did lots of work on Arm V2.0
    [6031K160.SLDPRT, 6031K170 (Lazy Susan).SLDPRT, 6031K180-LazySusan.SLDPRT, Arm_V2.0.SLDASM, Arm_bracket_V2.0.SLDPRT, Servo Assembly Futaba S3003.SLDASM, Servo Futaba S3003.SLDPRT, Servo Rotor.SLDPRT]
2015-06-17 Driver Section added
    Driver Section semi-complete. Review highly recommended
2015-06-18 June 17
    Black Rod and Sensor Calibration
2015-06-18 update drivers
2015-06-18 final updates to drivers
2015-06-18 change to four wheels
2015-06-18 my hands are typign words
    [Arm_V2.0.SLDASM, Arm_short_section_V2.0.SLDPRT, ChassisV2.0.SLDPRT, Driven Linkage.SLDASM, Pickup_Mechanism.SLDPRT, Servo Futaba S3003.SLDPRT, long_arm_side_beam.SLDPRT, ~70x5mmCrosspin.SLDPRT]
2015-06-18 git reckted
    [CrudeRobot.SLDASM, Driven Linkage.SLDASM]
2015-06-19 modeled Stepper Motor
    [Arm_V2.0.SLDASM, Scotty's Stepper.SLDPRT]
2015-06-19 use different calibration
2015-06-24 Outer Basket 3D Model
    Outer Basket to be cut with the water jet cutter. New dimensions are
    5.5"x10"x8" (l x w x h)
    [Outer Basket to Cut Rev 3.SLDPRT]
2015-06-24 minor edits
    [Axel.SLDPRT, Chassis V3.0.SLDPRT, CrudeRobot.SLDASM, Driven Linkage.SLDASM, Motor BarbCole Geared (1).SLDPRT, Robot.SLDASM, Wheel_mount_bracket.SLDPRT, linage with motor mount.SLDPRT]
2015-06-26 Did more work on the motor mounting bracket
    [Motor BarbCole Geared (1)MWasm.SLDPRT, Motor-wheel_assem.SLDASM, axelMWasm.SLDPRT, mounting bracket.SLDPRT, mounting bracketMWasm.SLDPRT, wheel hubMWasm.SLDPRT, wheelMWasm.SLDPRT]
2015-06-26 add some power fraction stuff
2015-06-27 Worked on wheel mounting system
    [30-tooth-sprocket.SLDPRT, Assem1.SLDASM, Motor-wheel_assem.SLDASM, axelMWasm.SLDPRT, edge_stiffener.SLDPRT, mounting bracketMWasm.SLDPRT, wheel hubMWasm.SLDPRT, wheelMWasm.SLDPRT]
2015-06-27 Re-Orginization
    Added an extra folder for Bare rod in Ice. Hopefully this is less
    confusing.
2015-06-27 Here she goes
    Pls work
    [Lab Report Tracking Sheet.xlsx]
2015-06-28 Add fit code for insulated rod heating
2015-06-28 add curve fit for calibration
2015-06-28 MOIST ROD SIM
    Steady state moist rod. Just needs calibration data
2015-06-28 Update
    Tracking sheet mostly
    [Lab Report Tracking Sheet.xlsx]
2015-06-28 Vertical Bare Rod - Steady State (One End in Ice)
    I have added my code for the steady state of the vertical bare rod with
    one end in ice. This is mainly a variation of James's bare rod
    simulation.
2015-07-03 changes to tape following code
    Add max values to menu, fix bug due to menuItem values not being
    integers, account for variable max speed
    [preprocessor.h, robot.ino]
2015-07-04 edits to simulation code: add transient insulated analysis
    [AlRodSim.SLDPRT]
2015-07-05 Added and Offset Calculator and impoved the Calibrate function
2015-07-05 257: Report Diagrams, 253: Basket Assembly Rev A
    257:
    I've made some report diagrams that will be helpful for method
    descriptions.
    253:
    I've made the assembly of the Rev A of our Catapult basket for future
    reference
    [Catapult Basket - Assy Rev A.SLDASM, Inner Basket - Catapult to Cut Rev 1.SLDPRT, Inner Basket - Sloped Angle to Cut Rev 1.SLDPRT, Outer Basket to Cut Rev 3.SLDPRT]
2015-07-05 Changed insulated rod and bare rod
2015-07-05 IR Circuit Test Code
    I doubt this is very important
    [Lab Report Tracking Sheet.xlsx]
2015-07-05 fixed calibrate, copy this version for all sims
2015-07-05 add transient results and code updates
    [parameter values.xlsx]
2015-07-05 Simulations: Black, Vert Top, Vert Bottom
    Simulations for the black rod, vertical bare rod powered from the top,
    and vertical bare rod powered from the bottom. All simulations found in
    my simulation folder
2015-07-05 Black Rod Fit Change
    Greg wants to fix a bug
2015-07-06 MOIST ROD MOTHER FUCKERS
    8============================D~~~~~~~
2015-07-06 Moist Rod Simulation
    THIS SIMULATION MAKES MY ROD SO MOIST
2015-07-06 add moist rod model
    [parameter values.xlsx]
2015-07-06 Updated Moist Rod with better emissiv
    so swegggg
2015-07-07 Finished arm mount
    [6031K170 (Lazy Susan).SLDPRT, Internal_spur.SLDPRT, Mount.SLDASM, Potentiometer.SLDPRT, Solarbotics motor B.SLDASM, arm_mount.DXF, arm_mount.SLDPRT, internal_spur_offset.SLDPRT]
2015-07-08 code for arm control
2015-07-09 Bunch of arm work
    [4mm_shaft.SLDPRT, 6031K170 (Lazy Susan).SLDPRT, Arm base Flange with motor mount.SLDPRT, Arm_mount.SLDASM, Arm_v3.SLDASM, DC motor.SLDPRT, Internal_spur.SLDPRT, Mecano Thingy.SLDPRT]
2015-07-09 fixed a few things
    [Arm base Flange with motor mount.SLDPRT, Arm_v3.SLDASM, Part3.SLDPRT, amr_seg2_v3.SLDPRT, arm_segment_v3.SLDPRT, gear spacer.SLDPRT, mod1_25T_gear.SLDPRT, mod1_50t_spur gear_iso.SLDPRT]
2015-07-09 fixes to IR code
    [robotIR.ino]
2015-07-09 IR Stuff
    [IR Circuit - PhotoTransistor Voltage vs Distance Test.xlsx]
2015-07-10 Arm Release and Zipline Catcher Models Added
    These are the relevant models I have made for the Arm Release and the
    Zipline Catcher
    [ASM Servo.SLDASM, Al Plate Rev 1.SLDPRT, Basket Attachment Rev 1.SLDPRT, Roller Stopper Rev 1.SLDPRT, Servo Motor.SLDPRT, Servo Rotor.SLDPRT, Servo Spindle.SLDPRT, Steel Plate Rev 1.SLDPRT]
2015-07-10 a whole bunch of stuff
    [Arm base Flange with motor mount.SLDPRT, Arm_mount.SLDASM, Arm_v3.SLDASM, Mount.SLDASM, Part3.SLDPRT, amr_seg2_v3.SLDPRT, arm_rotation_spur_gear.SLDPRT, arm_segment_v3.SLDPRT]
2015-07-10 Arm edits
    [6031K170 (Lazy Susan).SLDPRT, Arm_rotation_motor.SLDPRT, Internal_spur.SLDPRT, Mount.SLDASM, arm_mount.SLDPRT, arm_rotation_spur_gear.SLDPRT]
2015-07-13 Zipline Catcher & Catapult Basket Changes
    Catapult Basket:
    Speed Holes Added
    Zipline Catcher:
    Basket Attachment screw holes removed due to probability of misalignment
    during bending
    [Basket Attachment Rev 2.SLDPRT, Catapult Basket - Assy Rev 1.SLDASM, Catapult Basket - Assy Rev 2.SLDASM, Catapult Basket - Assy Rev B.SLDASM, Catapult Basket - Catapult Rev 1.SLDPRT, Catapult Basket - Catapult Rev 2.SLDPRT, Catapult Basket - Catapult Slope Side Rev 1.SLDPRT, Catapult Basket Rev 1.SLDPRT]
2015-07-13 arm work
    [6-tooth-sprocket.SLDPRT, Arm_mount.SLDASM, Motor-wheel_assem.SLDASM, arm_rotation_spur_gear.SLDPRT, bushing-spacer.SLDPRT, bushing-spacer2.SLDPRT, bushing-spacer3.SLDPRT, top_arm_spacer.SLDPRT]
2015-07-14 Basket Attachment Updated, Pin Support Created
    Basket Attachment for Zipline Roller Updated, Pin Support for Zipline
    Roller onto Meccano added
    [Basket Attachment Rev 2.SLDPRT, Catapult Basket - Assy Rev B.SLDASM, Guide Piece Rev 1.SLDPRT, Inner Basket - Catapult to Cut Rev 2.SLDPRT, Inner Basket - Sloped Angle to Cut Rev 2.SLDPRT, Pin Support Rev 1.SLDPRT, Zipline Roller Assy Rev 1.SLDASM, Zipline Roller Rev 2.SLDPRT]
2015-07-14 arm and chassis
    [Arm base Flange with motor mount.SLDPRT, Arm_mount.SLDASM, Arm_v3.SLDASM, Mount.SLDASM, Part3.SLDPRT, QRD.SLDPRT, arm_segment_v3.SLDPRT, chassis V4.0.SLDPRT]
2015-07-15 More arm code updates
2015-07-16 Here is the basket lift
    swagswag
    [Assem1.SLDASM, DrivenArmBasePinJoint-BackupModel.SLDPRT, DrivenArmBasePinJoint-ForMakingAssembly.SLDPRT, DrivenArmBasePinJoint-WithMotorMount-v2.SLDPRT, DrivenArmBasePinJoint-WithMotorMount.SLDPRT, DrivenArmBasePinJoint.SLDPRT, DrivenArmShaft.SLDPRT, DrivenArmTopPinJoint.SLDPRT]
2015-07-17 arm code updates
2015-07-17 SECOND LIFT
    DO YOU EVEN LIFT?
    [BasketLiftMechanism-V2.SLDASM, CrudeMotorRemake.SLDPRT, FixedArmPinJoint-WithSlidePoleMounts.SLDPRT, FixedArmPinJoint.SLDPRT, FixedArmShaft.SLDPRT, SlideArmPinSlider.SLDPRT, SlideArmShaft.SLDPRT, SlideArmSlidePole.SLDPRT]
2015-07-17 add integral gain to arm code
2015-07-17 Basket Lift for real
    [BasketLiftMechanism-V2.SLDASM, FixedArmPinJoint-WithSlidePoleMounts.SLDPRT, FixedArmPinJoint.SLDPRT, GM7.SLDPRT, SlidePoleMount.SLDPRT]
2015-07-17 DO YOU EVEN LIFT JAMES? THIS DOES
    [Assem1.SLDASM, BasketLiftMechanism-V2.SLDASM, DrivenArmBasePinJoint-BackupModel.SLDPRT, DrivenArmBasePinJoint-ForMakingAssembly.SLDPRT, DrivenArmBasePinJoint-WithMotorMount-v2.SLDPRT, DrivenArmBasePinJoint-WithMotorMount.SLDPRT, DrivenArmBasePinJoint.SLDPRT, DrivenArmShaft.SLDPRT]
2015-07-17 just commiting so I can pull
    [chassis V4.0.SLDPRT, chassis v4.0.SLDASM]
2015-07-17 LIFT LIFTL ILFILTIFLIT
    [BasketHolder.SLDPRT, BasketLiftMechanism-V2.SLDASM, FixedArmPinJoint-WithSlidePoleMounts.SLDPRT, FixedArmPinJoint.SLDPRT, SlidePoleMount.SLDPRT]
2015-07-17 chassis work
    [chassis V4.0.SLDPRT, chassis v4.0.SLDASM]
2015-07-17 commit to pull
    [chassis V4.0.SLDPRT, chassis v4.0.SLDASM]
2015-07-17 HERE JAAAAAMMMEESS
    [BasketLiftMechanism-V2.SLDASM]
2015-07-17 ERRARA RAGEGER QERG QREG RQEG RQGE
    [BasketHoldAssembly.SLDASM, BasketHolder.SLDPRT, FixedArmPinJoint-WithSlidePoleMounts.SLDPRT, FixedArmPinJoint.SLDPRT, SlidePoleMount.SLDPRT]
2015-07-17 whole bunch of edits
    [Arm base Flange with motor mountV4.0.SLDPRT, Arm_mount_V4.0.SLDASM, Arm_v3V4.0.SLDASM, Part3V4.0.SLDPRT, arm_encoder_gear.SLDPRT, arm_segment_v3V4.0.SLDPRT, chassis V4.0.SLDPRT, chassis v4.0.SLDASM]
2015-07-17 Here she is
    [BasketHoldAssembly.SLDASM, BasketHolder.SLDPRT, BasketLiftMechanism-V2.SLDASM, FixedArmPinJoint-WithSlidePoleMounts.SLDPRT, FixedArmPinJoint.SLDPRT, SlidePoleMount.SLDPRT]
2015-07-17 safety commit
    [chassis v4.0.SLDASM]
2015-07-18 finished chassis
    fuck yeah
    [BasketHolder.SLDPRT, BasketLiftMechanism-V2.SLDASM, FixedArmPinJoint-WithSlidePoleMounts.SLDPRT, FixedArmPinJoint.SLDPRT, SlidePoleMount.SLDPRT, chassis v4.0.SLDASM]
2015-07-18 robot 'finished'
    [Arm base Flange with motor mountV4.0.SLDPRT, Arm_mount_V4.0.SLDASM, Arm_v3V4.0.SLDASM, Part3V4.0.SLDPRT, arm_encoder_gear.SLDPRT, arm_segment_v3V4.0.SLDPRT, chassis v4.0.SLDASM, helical gear 40 teethV4.0.SLDPRT]
2015-07-18 even more arm updates
2015-07-20 interrupt stuff
2015-07-20 a quick fix to avoid duplicate detection of markings
    [constants.h, robot.ino, tape.h]
2015-07-21 u Lift bro?
    ya
    [BasketHolder.SLDPRT, FixedArmSpacer.SLDPRT, SweetSpinner-v2.SLDPRT, SweetSpinner.SLDPRT]
2015-07-21 whoops didn't actually commit the code
    [Benchmark.ino, arm.h, constants.h, preprocessor.h, robot.ino]
2015-07-22 Fuck you james
    you suck
    [BasketHoldSpacer.SLDPRT, BasketHolder.SLDPRT, BasketLiftMechanism-V2.SLDASM, FixedArmPinJoint-WithSlidePoleMounts.SLDPRT, FixedArmPinJoint.SLDPRT, RollerSpacers.SLDPRT, SlidePoleMount.SLDPRT, SweetArmSpacer.SLDPRT]
2015-07-23 Latest Revisions of Zipline Catcher addded.
    Note that Rev 5.1 and 5.2 are pieces of Rev 5 that were printed due to
    the 3D printer being unable to print a full piece.
    [Ball Bearing Spacer.SLDPRT, Basket Attachment Rev 2.SLDPRT, Catapult Basket - Assy Rev B with Zipline Catcher.SLDASM, Catapult Basket - Assy Rev B.SLDASM, Pin Support Rev 2.SLDPRT, Pin Support Rev 3.SLDPRT, Zipline Guide Rev 1.SLDPRT, Zipline Roller Rev 3.SLDPRT]
2015-07-31 tried to defuckulate the arm assembly
    [Arm base Flange with motor mountV4.0V5.0.SLDPRT, Arm_v3V4.0V5.0.SLDASM, Part3V4.0V5.0.SLDPRT, amr_seg2_v3V4.0V5.0.SLDPRT, arm big gear.SLDPRT, arm_encoder_gearV5.0.SLDPRT, arm_segment_v3V4.0V5.0.SLDPRT, basket lift motor mount.SLDPRT]
2015-08-01 yolo
    sdfghj
    [Assem2.SLDASM, Bumper.SLDPRT, BumperMech.SLDASM, CrudeMicroSwitch.SLDPRT, DrivenShaft.SLDPRT, DrivingMotorTemplate.SLDPRT, IRHousing-for Assembly.SLDPRT, IRHousing-toPrint.SLDPRT]
2015-08-02 bugfix overflow errors in servo
    [arm.h]
2015-08-02 made new pickup mechanism
    [Al_pickup_mech.SLDPRT, Micro Switch Button.SLDPRT, SG90 ARM.SLDPRT, SG90 BODY.SLDPRT, SG90.SLDASM, pickup mechanism.SLDASM, pickup mechanism.SLDPRT]
2015-08-02 finished pickup mech
    [Al_pickup_mech.SLDPRT, pickup mechanism.SLDASM, pickup mechanism.SLDPRT]
2015-08-04 minor edits to pickup mech
    slight edits, added edge cuts etc.
    [Al_pickup_mech.SLDPRT, pickup mechanism.SLDASM, pickup mechanism.SLDPRT]
2015-08-13 Here is my last stuff.
    Not all of the naming is consistent, so ask me if you have any questions
    [Assem2.SLDASM, Basket v1.SLDPRT, Basket-Caution.SLDPRT, Basket-Triangles.SLDPRT, CrudeMicroSwitch.SLDPRT, FinalBumperMech.SLDASM, HolesOnBasket.SLDASM, MicroSwitchMount-withIRMount.SLDPRT]
2015-08-13 Revert "photos and videos from my phone"
    This reverts commit 166fc5d5b8cfef6748a36c15619aeb72e213e13f.
    Merge remote-tracking branch 'origin/master'
    photos and videos from my phone
    [20-tooth-sprocket.SLDPRT, 20-tooth-sprocket_.SLDPRT, Arm base Flange with motor mountV4.0V5.0.SLDPRT, Arm_mount_V5.0.SLDASM, Arm_v3V4.0V5.0.SLDASM, Chassis and Drive train.SLDASM, MicroSwitchMount-withIRMount.SLDPRT, Part3V4.0V5.0.SLDPRT]
2015-08-13 Here we go
    [FinalBumperMech.SLDASM, MicroSwitchMount-withIRMount.SLDPRT, PickupFlange.SLDPRT]
